cansat-tsniimash/KNPN-2025/doc/Расчет скорости спуска белый.docx

v=v_0 +(g-(C_x ∙S∙(ρ∙v^2)/2)/M)∙t

Find(v)→[, (2∙M∙((√((2∙C_x ∙S∙ρ∙g∙t^2 +2∙C_x ∙S∙ρ∙v_0 ∙t+M)/M))/2-1/2))/(C_x ∙S∙ρ∙t);, -(2∙M∙((√((2∙C_x ∙S∙ρ∙g∙t^2 +2∙C_x ∙S∙ρ∙v_0 ∙t+M)/M))/2+1/2))/(C_x ∙S∙ρ∙t)]

C_x =0.84

S=(π∙(84 mm)^2)/4=5 542 mm^2

ρ=1.225 (kg)/(m^3)

v_0 =7.1 m/s

M=779 gm

v=(2∙M∙((√((2∙C_x ∙S∙ρ∙g∙t^2 +2∙C_x ∙S∙ρ∙v_0 ∙t+M)/M))/2-1/2))/(C_x ∙S∙ρ∙t)

s(t)=∫_0^t v(t)dt

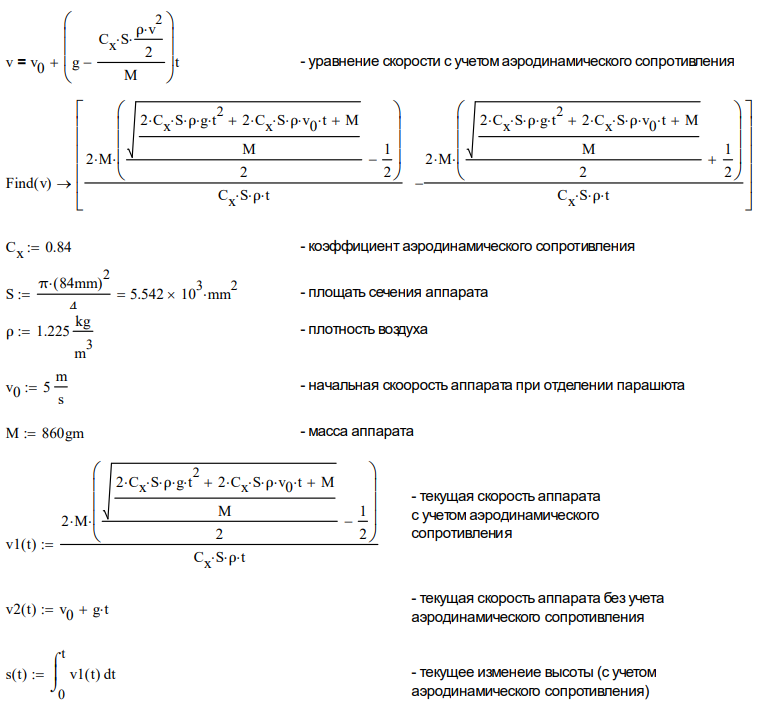
[picture p1: figure]
