cansat-tsniimash/KNPN-2025/doc/парашют1.docx

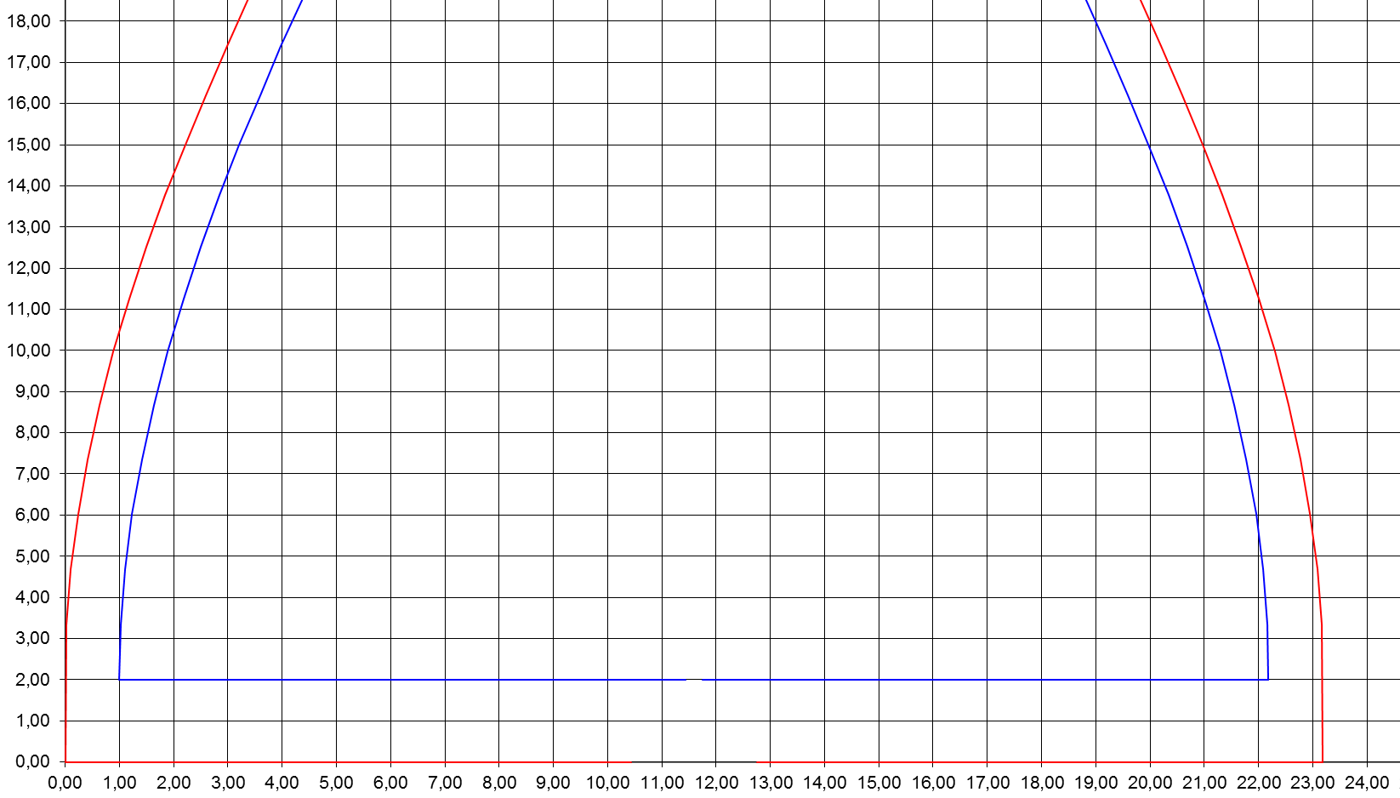
[picture p2: figure]
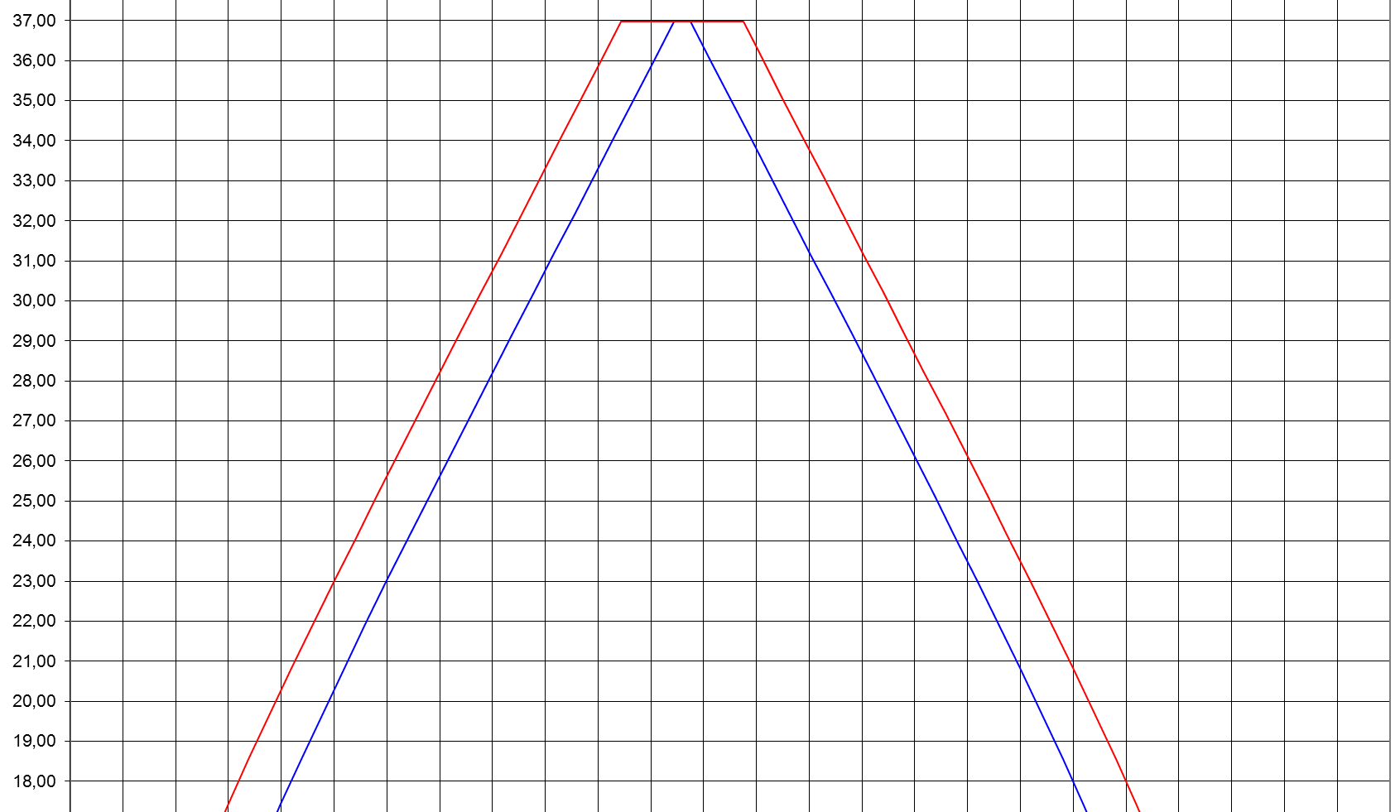
[picture p3: figure]
