cansat-tsniimash/KNPN-2025/doc/Спецификация.pdf

Копировал | Формат А4
КНПН.0000-0 СБ | Сборочный чертеж
| Сборочные единицы
1 | КНПН.1000-0 | Мотор/крепление | 8
2 | КНПН.1100-0 | Кнопка-концевик | 8
3 | КНПН.3000-0 | Гермообъем | 1
4 | КНПН.4000-0 | Плата радио | 1
5 | КНПН.5000-0 | Плата моторов | 1
6 | КНПН.5000-0 | Узел солнечных батарей | 1
7 | КНПН.6000-0 | Плата МК | 1
8 | КНПН.7000-0 | Парашют | 1

Детали

9 | КНПН.0000-1 | База | 1
10 | КНПН.0000-2 | Лепесток 1 | 1
11 | КНПН.0000-3 | Лепесток 2 | 1
12 | КНПН.0000-4 | Лепесток 3 | 1
13 | КНПН.0000-5 | Лепесток 4 | 2
14 | КНПН.0000-6 | Лепесток 5 | 1
15 | КНПН.0000-7 | Лепесток 6 | 1
16 | КНПН.0000-8 | Лепесток 7 | 1
17 | КНПН.0000-9 | Стержень М3 | 4

Инв. N подл. Подп. и дата Взам. инв. N Инв. N дубл. Подп. и дата Справ. N Перв. примен.

## КНПН.0000-0

Изм. | Лист | N докум. | Подп. | Дата
| | Разраб. | - | | Атмосферный зонд | Лит. | Лист | Листов
Пров. | | | | | | | 1 | 3
Н. контр. | Команда КНПН

## Утв. Формат

Зона
Поз.
Обозначение | Наименование | Приме-чание
| Документация

Кол.

Копировал | Формат А4

Прочие изделия

23 | DC-DC преобразователь | 1
| MP1584EN
24 | GPS антенна | 1
| Ublox-NEO-7M
25 | Дальномер | 1
| TF-luna
26 | Мотор-редуктор | 1
| GA12-NA20
27 | Радиомаяк | 1
| TBEACON-ONYX

## КНПН.0000-0

Лист

2 Изм. | Лист | N докум. | Подп. | Дата

Инв. N подл. Подп. и дата Взам. инв. N Инв. N дубл. Подп. и дата

Формат
Зона
Поз.
| Обозначение | Наименование | | Приме-чание
18 | КНПН.0000-11 | Крепление СП | 1
19 | КНПН.0000-12 | Крепление gps | 1
20 | КНПН.0000-13 | Парашютная катушка | 1
21 | КНПН.0000-14 | Кронштейн СБ вертикальный | 1
22 | КНПН.0000-15 | Натяжитель | 1

Кол.
