cansat-tsniimash/KNPN-2025/Winter Session/2025 КНПН ЗС доп.pdf

# Тест подъема аппарата

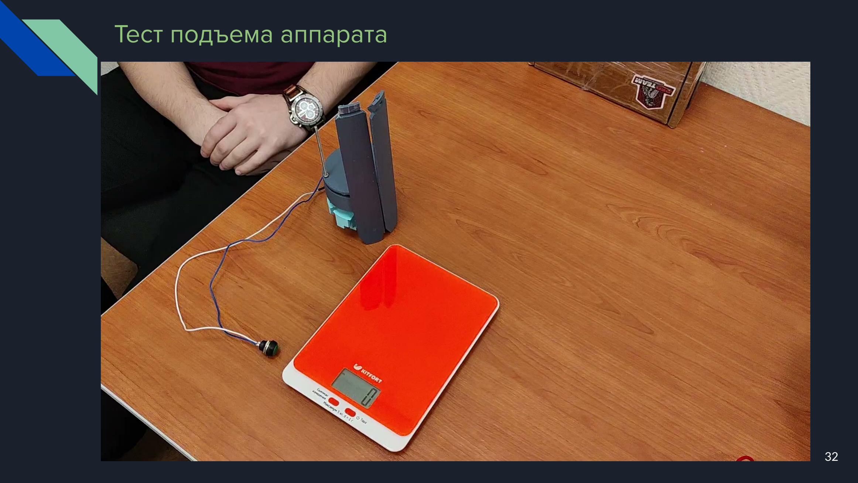
[picture p4: page 1]

# ВИДЕО (https://docs.google.com/file/d/16i_DLucU9-pxqTA7eW-CcuCZwpfHuC1A/preview)

# План-график работ

№ | Сроки | Содержание работ
1 | Октябрь | Определение дополнительных миссий аппарата, постановка задач
2 | Ноябрь - Декабрь | Выбор способов решения поставленных задач, определение состава аппарата, разработка модели аппарата, подбор комплектующих
2 | Декабрь | Прохождение онлайн-тестирования
3 | Январь | Разработка модели аппарата,начало написания кода, подготовка к отборочной сессии
4 | Февраль | Отборочная сессия, доработка ПО, доработка модели аппарата, разработка печатных плат
5 | Март | Изготовление элементов конструкции аппарата, доработка ПО, испытания всех систем
6 | Апрель | Разработка ПО для взаимодействия всех систем, сборка аппарата, пайка микросхем
7 | Май | Сборка тестовой модели аппарата, проведение испытаний, проверка работы всех систем, заочный допуск
8 | Июнь | Разбор телеметрии с испытаний, устранение недочетов, сборка финальной модели аппарата
9 | Июль | Финал чемпионата

# Энергопотребление компонентов аппарата

Устройство | Количество, шт. | Потребление в рабочем режиме, А | Напряжение питания, В | Мощность, Вт
Микроконтроллер STM32F411 Black Pill | 1 | 0,0234 | 3,3 | 0,07722
SD карта | 1 | 0,25 | 3,3 | 0,825
Радиомодуль E220-400T22S | 1 | 0,11 | 3,3 | 0,363
Акселерометр + гироскоп LSM6DS3 | 1 | 0,0009 | 3,3 | 0,00297
Магнитометр LIS3MDL | 1 | 0,0002 | 3,3 | 0,00066
Датчик тока INA219 | 1 | 0,00002 | 3,3 | 0,000066
Фоторезистор VT93N1 | 2 | 0,0006 | 3,3 | 0,00198
АЦП 8-канальный AD5593RBRUZ | 2 | 0,001 | 3,3 | 0,0033
GPS модуль NEO-7M | 1 | 0,1000 | 5 | 0,5
Пищалка | 1 | 0,025 | 5 | 0,125
Датчик давления, температуры, влажности BME280 | 1 | 0,012 | 5 | 0,06
Датчик примесей воздуха MICS-5524 | 1 | 0,032 | 5 | 0,16
Датчик качества воздуха CCS811 | 1 | 0,03 | 5 | 0,15
Датчик примесей воздуха MICS-6814 | 1 | 0,032 | 5 | 0,16
Компрессор JSB1523018 | 1 | 0,12 | 5 | 0,6
Электромагнитный клапан ZT2-3C | 1 | 0,204 | 5 | 1,02
Мотор двухосевой панели GA12-N20 | 1 | 0,06 | 5 | 0,3
Мотор угловой панели GA12-N20 | 1 | 0,04 | 5 | 0,2
Мотор угловой лепестки GA12-N20 активные | 2 | 0,26 | 16 | 4,16
Мотор угловой лепестки GA12-N20 пассивные | 6 | 0,02 | 16 | 0,32
Пережигатель | 2 | 2 | 4,1 | 8,2

# Энергопотребление компонентов аппарата

Токоотдача | Ток, А
Максимальная токоотдача | 8,000
Максимальная токоотдача (3,3V) | 4,500
Максимальная токоотдача (5V) | 3,000
Максимальная токоотдача (16V) | 1,000
Потребление | Ток, А
Максимальное потребление | 3,245
Максимальное потребление (3,3V) | 0,388
Максимальное потребление (5V) | 0,859
Максимальное потребление (16V) | 0,640

# Расчет скорости спуска без парашюта

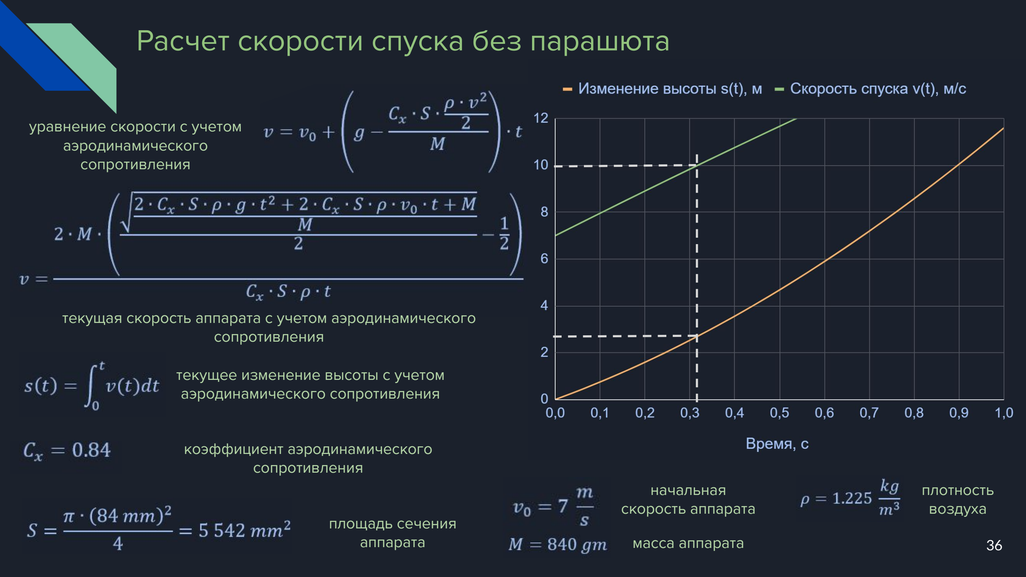
[picture p5: page 5]

плотность
воздуха

начальная
скорость аппарата

масса аппарата

коэффициент аэродинамического сопротивления

уравнение скорости с учетом аэродинамического
сопротивления

текущая скорость аппарата с учетом аэродинамического сопротивления

текущее изменение высоты с учетом аэродинамического сопротивления

площадь сечения
аппарата

# MICS

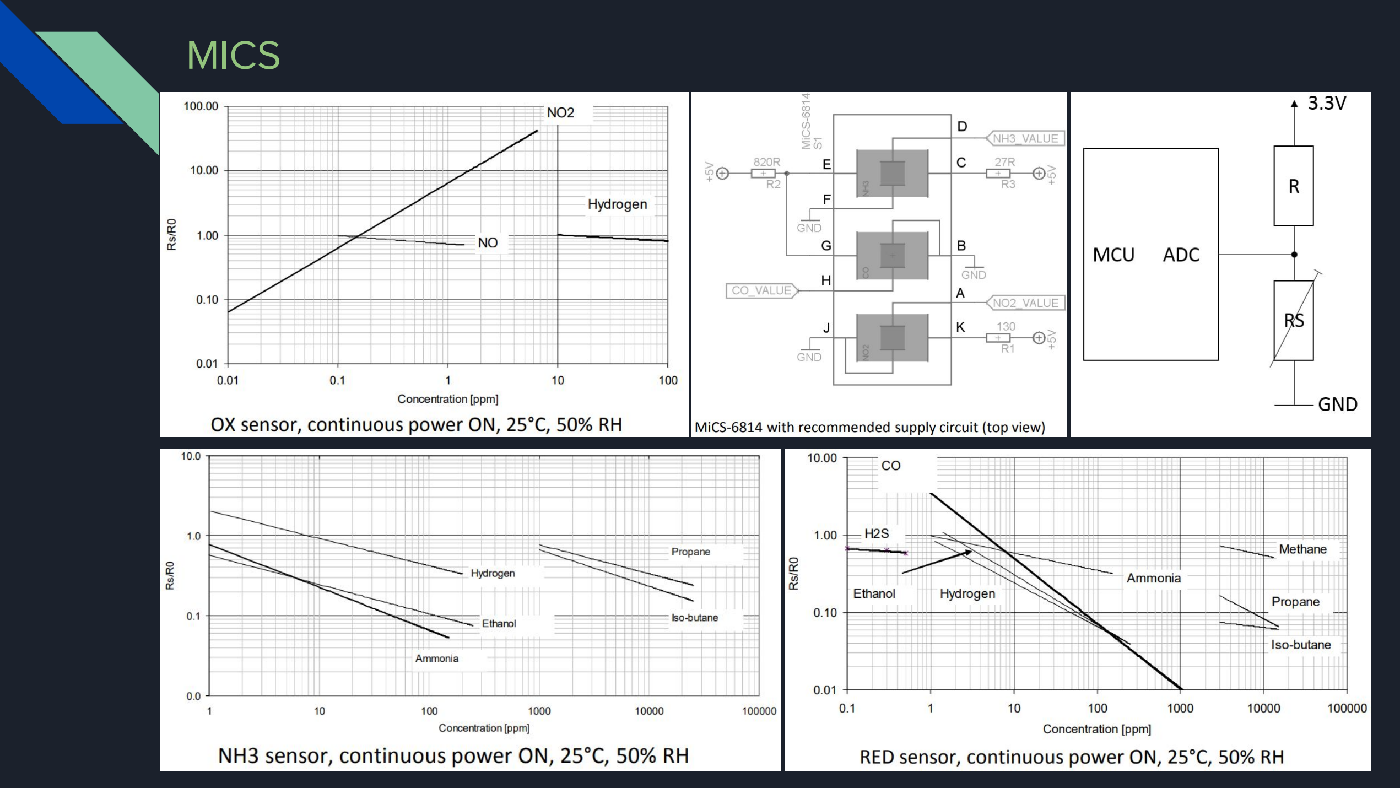
[picture p6: page 6]

Измерения Диапазон измерений

Точность
измерени
я

Частота
измерени
я

Объем
данных
, байт
BME280 | Температура | -40 - +85 град | 0,5 град | 157 Гц -26,32 Гц | 2
| Давление | 30 - 110 кПа | 100 Па (1 м) | | 4
| Влажность | 0% - 100% | 3% | | 2
| Высота | | 1м | | 4
LSM6DSL | Акселеромет р | 16 g | 40 mg | 104,2 Гц | 6
| Гироскоп | 2000 град/с | 3 град/с | | 6
LIS3MDL | Магнитометр | 16 гаусс | 1 гаусс | 80 Гц | 6

Ublox neo
7m
Широта | -

2,5 м

10 Гц

4

Долгота | - | 4
Высота | 0 - 50000 м | 4
Скорость, узл | 0 - 500 м/с | 0,1 м/с | -
Время, с | - | 30 нс | 4
Время, мкс | - | | 4
Fix | - | - | 1
Madgwick | q1, q2, q3, q4 | - | - | 40 Гц | 16
Измерения | Диапазон измерений

Точность
измерения

Частота
измерени
я

Объем
данных
, байт
Фото | Сопротивлени е | 12-300K | - | 28,6 Гц | 4
INA219 | Напряжение | 0 - 26 В | 1% (0,2%) | 14,7 Гц | 2
| Ток | - | 1% (0,2%) | | 4
CCS811 | углекислый CO2 | 400 – 8192 ppm | | 4 Гц | 2
| концентрация летучих веществ TVOC | 0 – 1187 ppb | | | 2
MICS-5524 | угарный CO | 1 – 1000 ppm | | 4 Гц | 2
| этанол C2H5OH | 10 – 500 ppm
водород H2 | 1 – 1000 ppm
аммиак NH3 | 1 – 500 ppm
метан CH4 | 1000 ppm
MICS-6814 | угарный CO | 1 – 1000 ppm | | 4 Гц | 2
| диоксид азота NO2 | 0,05 - 10 ppm | | | 2
| аммиак NH3 | 1 - 300 ppm | | | 2
| | | ±6см (0,2-3м)
TF-luna
8M | Расстояние | 0,2 - 8м
100 Гц | 2
±2% (3-8м)

# Параметры датчиков

# Расчет радиолинии (E220-400T22S)

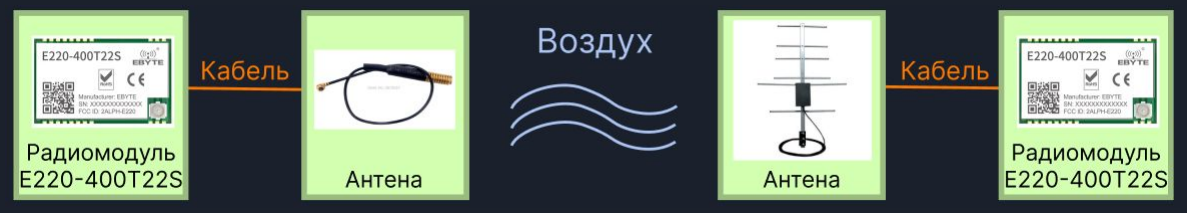
[picture p7: figure]

Радиомодуль | Кабель | Антенна | Воздух | Антенна | Кабель | Радиомодуль
22 | -2 | 0 | -102 | 8 | -2 | 117
дБм | дБ | дБи | дБ | дБи | дБ | дБм
P прд | L прд | G прд | ΣL | G прм | L прм | Pmin

### c – скорость света f – частота радио λ – длина волны d – максимальное расстояние между радиомодулями ΣL – суммарные потери в пространстве ΣP – суммарная мощность на входе в радиоприемник Pmin – чувствительность радиоприемника Δ – запас мощности на входе в радиоприемник

### с = 299 792 458 м/с f = 450.125 MГц

λ = 0.666 м
d = 7 000 м

### ΣL = -102.417 dBm ΣP = P

прд

- Lпрд + G
прд

### - ΣL + G

прм

- L
прм

### = -76 dBm Pmin = -117 dBm Δ = ΣP - Pmin= 41 dBm
