cansat-tsniimash/KNPN-2025/Winter Session/Алгоритм работы .png

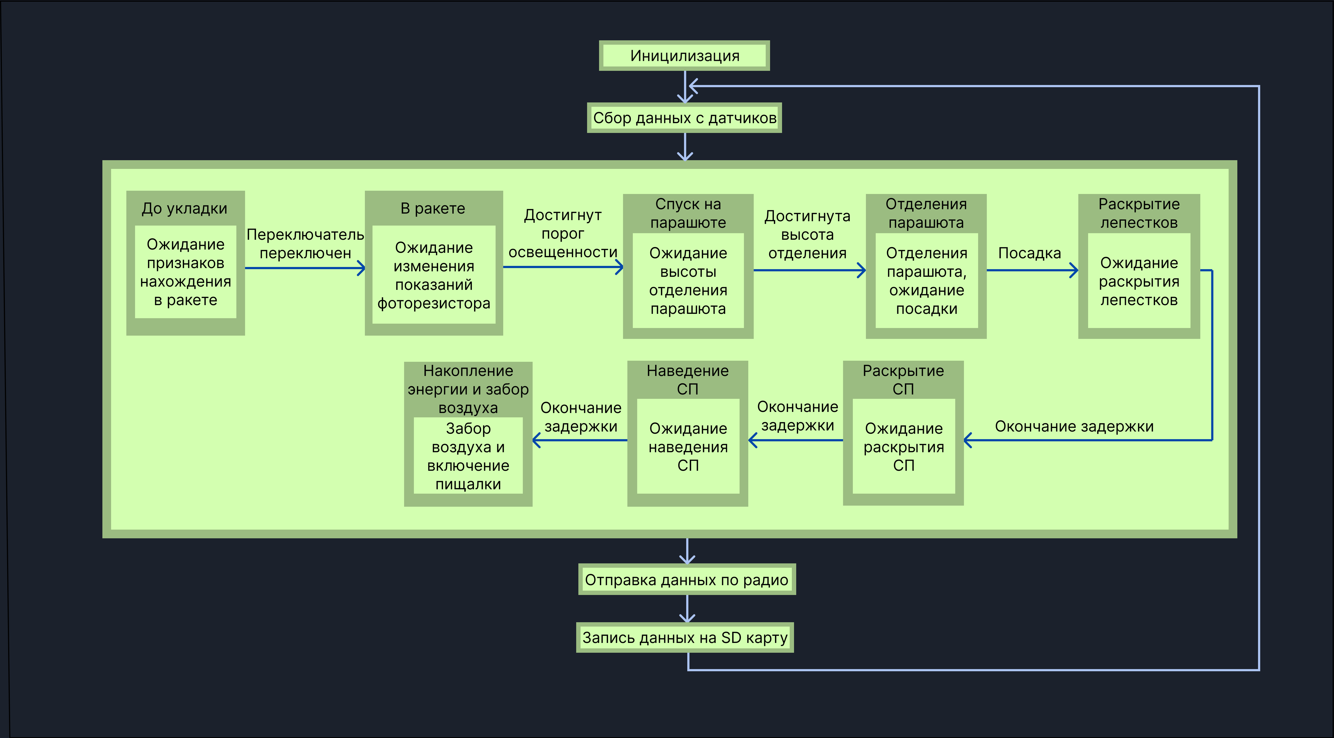
Winter Session/Алгоритм работы .png
