cansat-tsniimash/KNPN-2025/Winter Session/Подключение (16).png

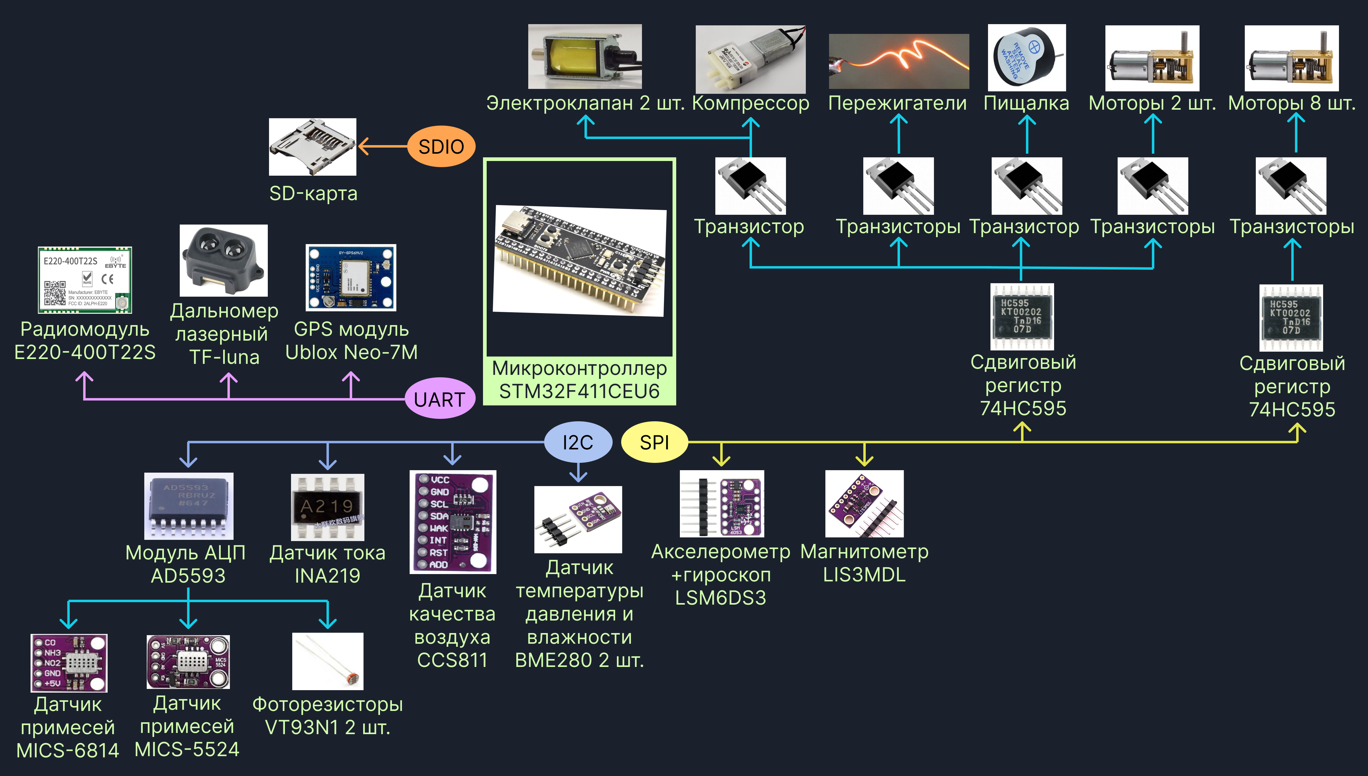
Winter Session/Подключение (16).png
