cansat-tsniimash/KNPN-2025/Winter Session/Подключение.png

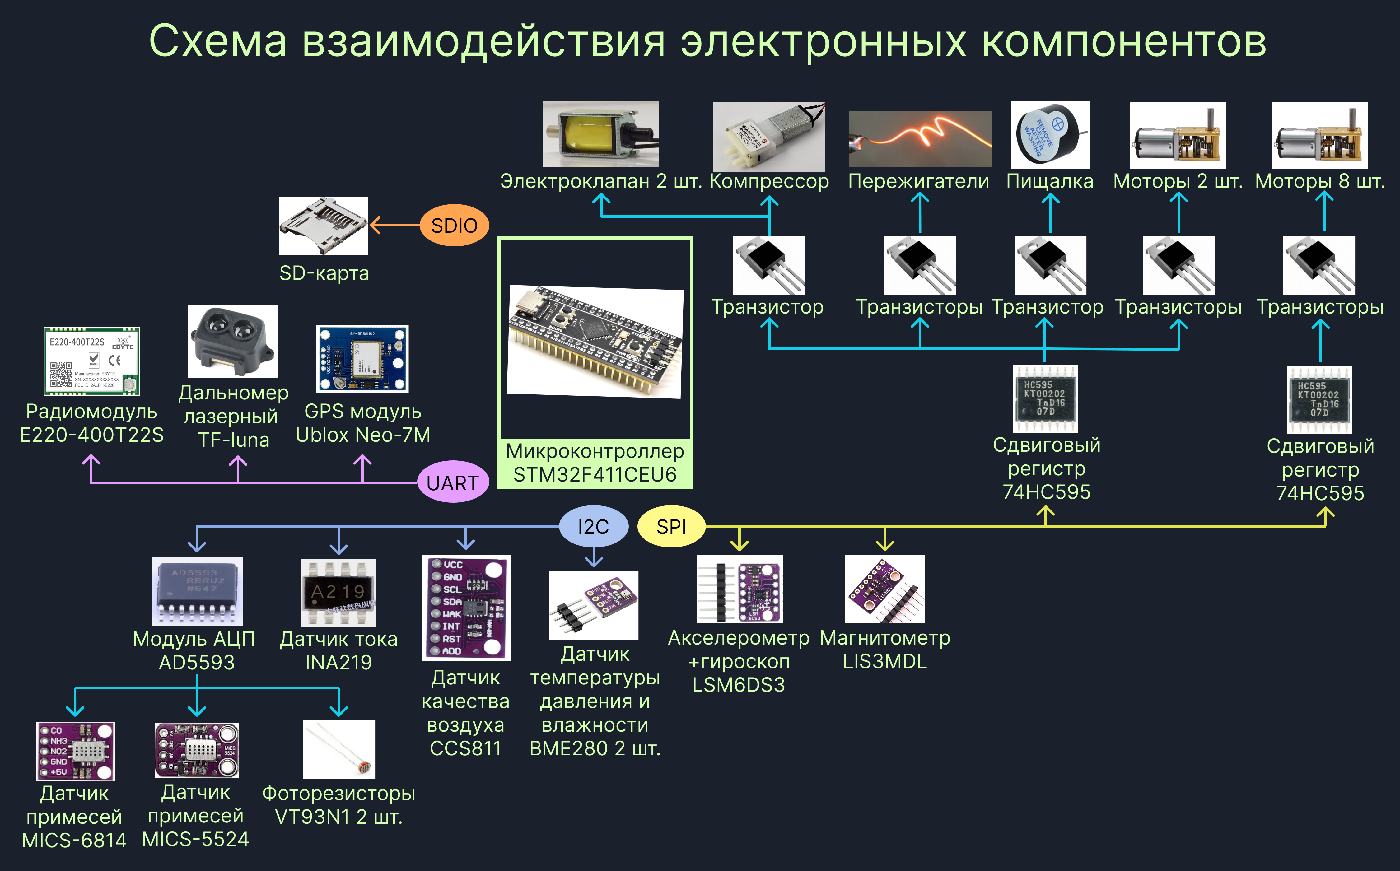
Winter Session/Подключение.png
