cansat-tsniimash/KNPN-2025/Winter Session/Расчёт параметров системы спасения.png

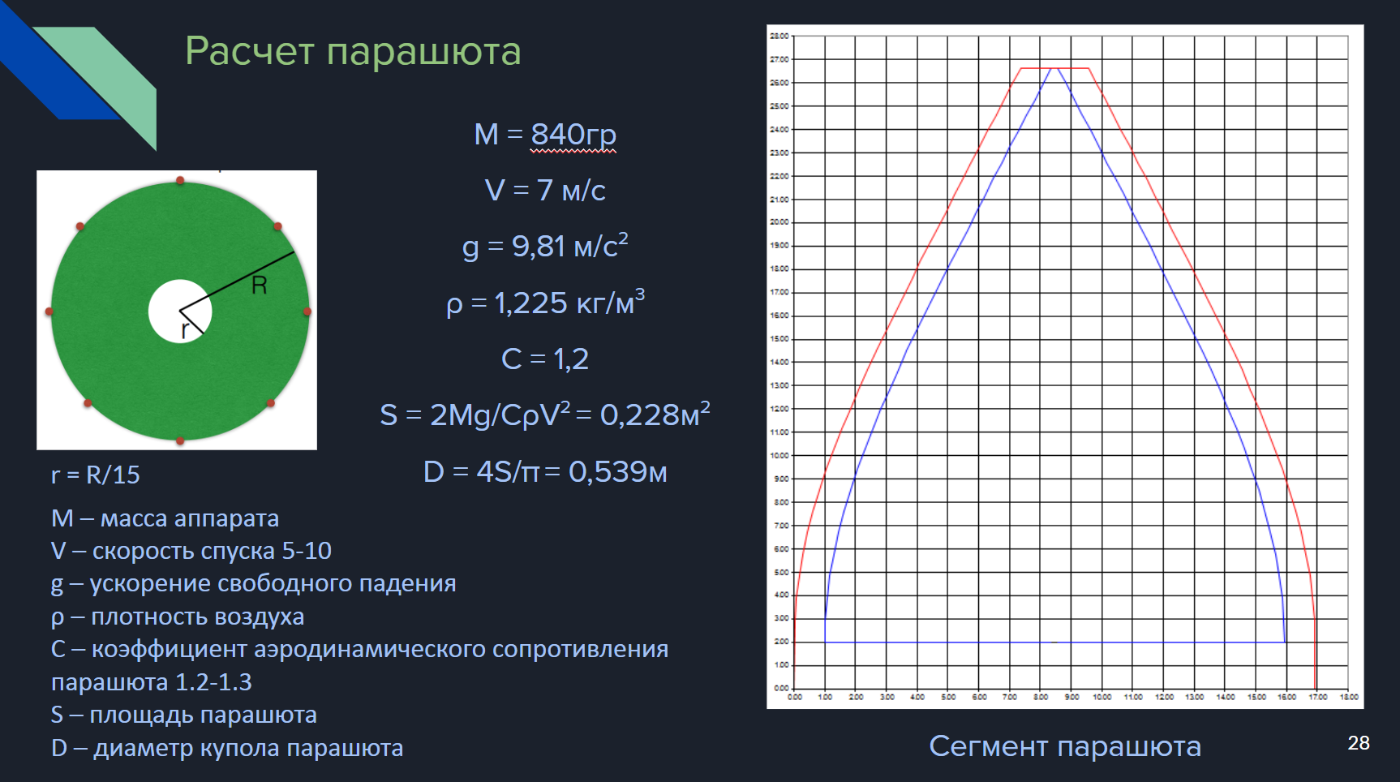
Winter Session/Расчёт параметров системы спасения.png
