cansat-tsniimash/KNPN-2025/Winter Session/Расчёт энергопотребления.png

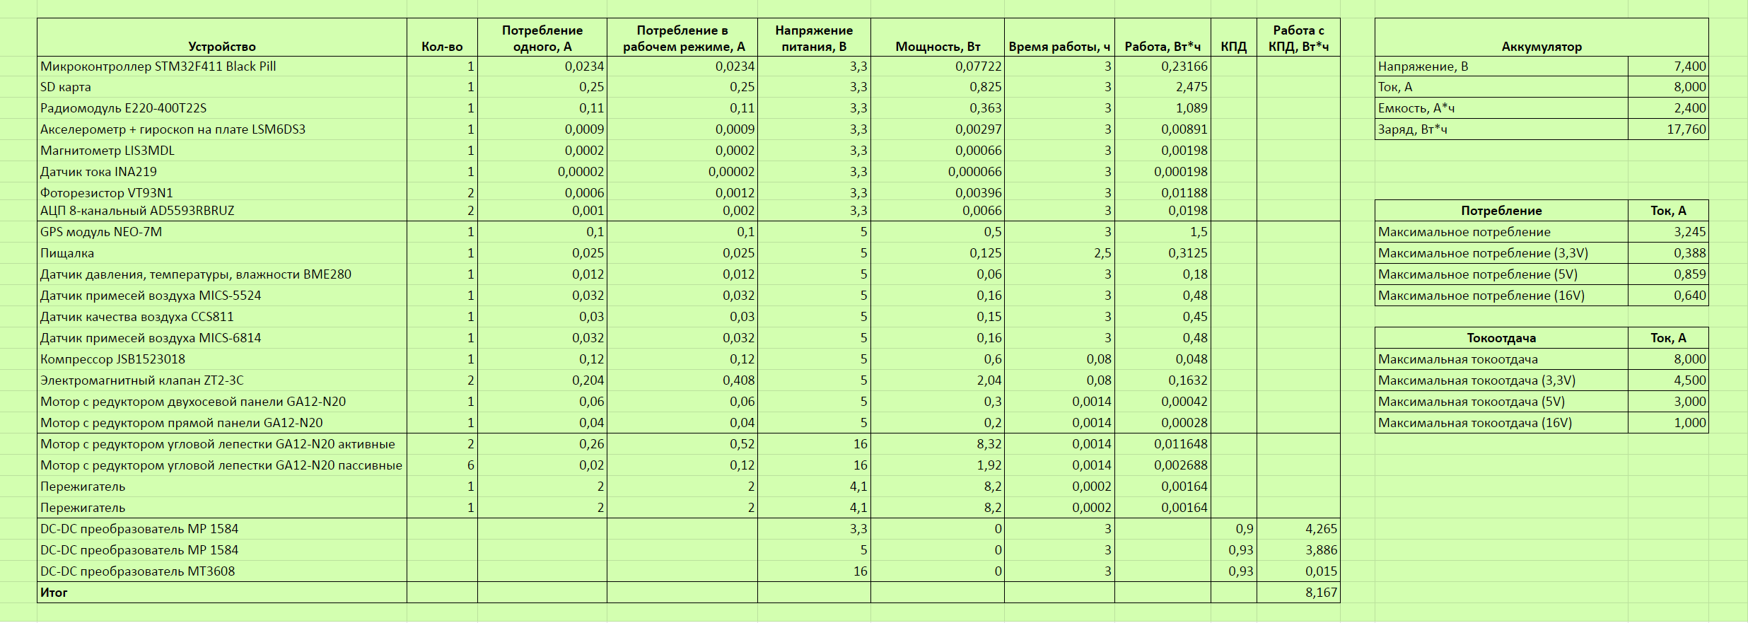
Winter Session/Расчёт энергопотребления.png
