cansat-tsniimash/KNPN-2025/Winter Session/Расчёт энергопотребления_1.png

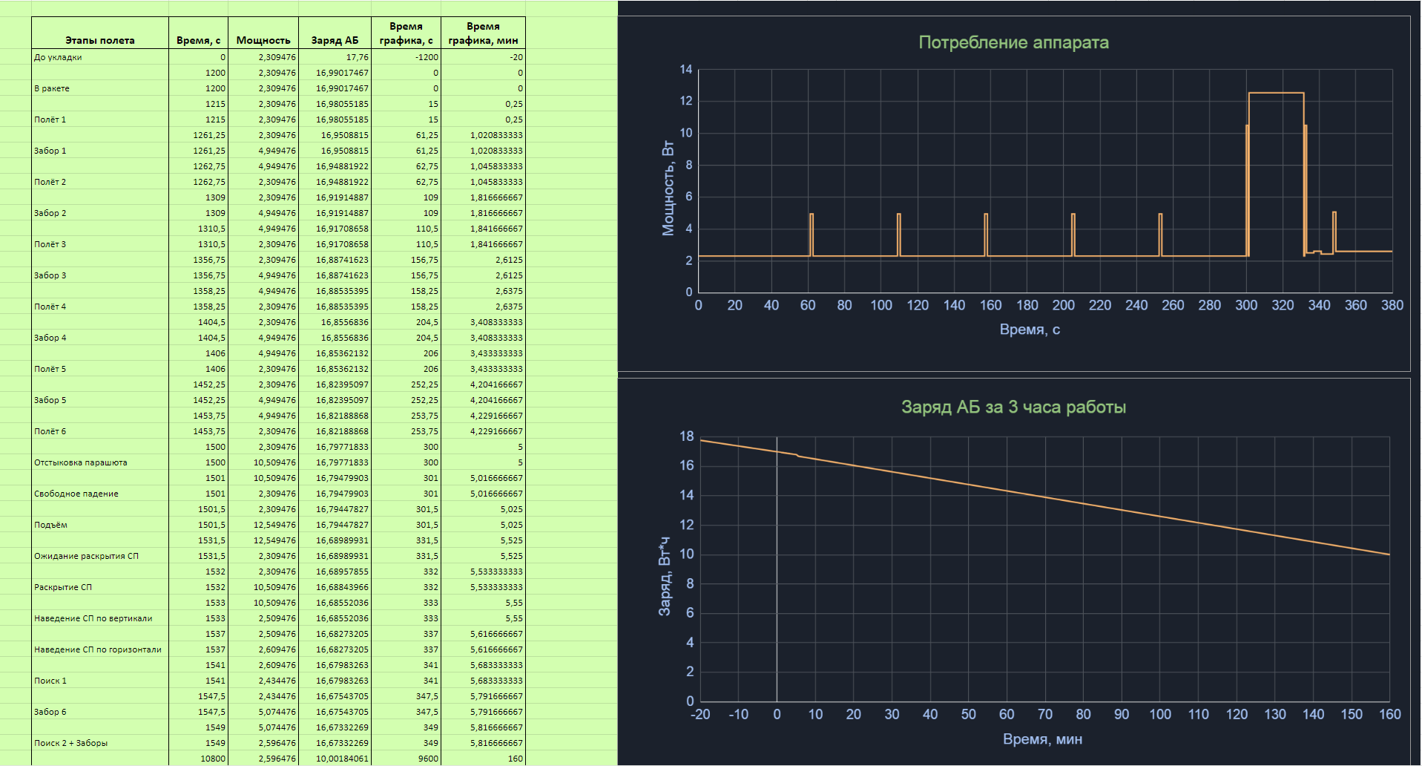
Winter Session/Расчёт энергопотребления_1.png
