cansat-tsniimash/KNPN-2025/Winter Session/Структурная схема бортовой электроники.png

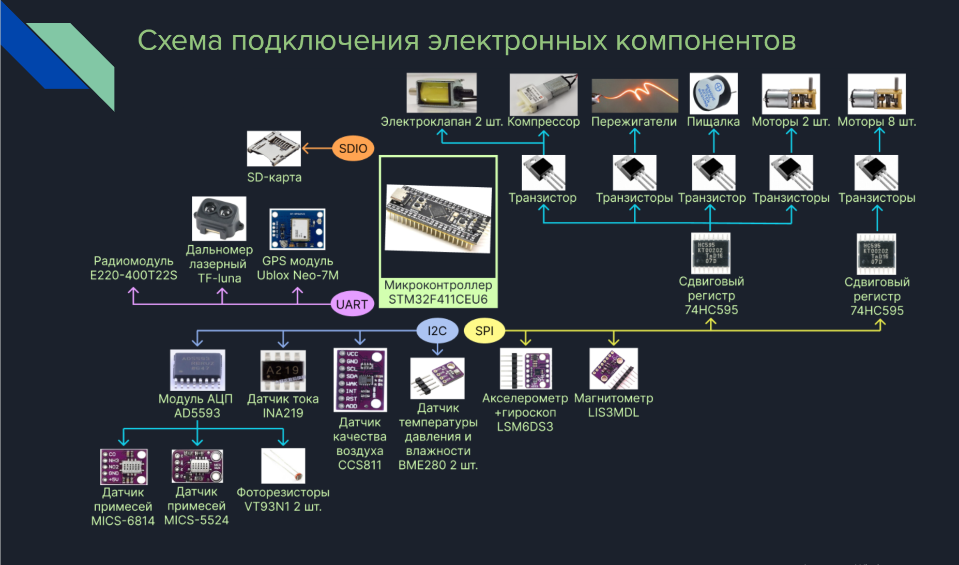
Winter Session/Структурная схема бортовой электроники.png
