cansat-tsniimash/KNPN-2025/Winter Session/электроника.png

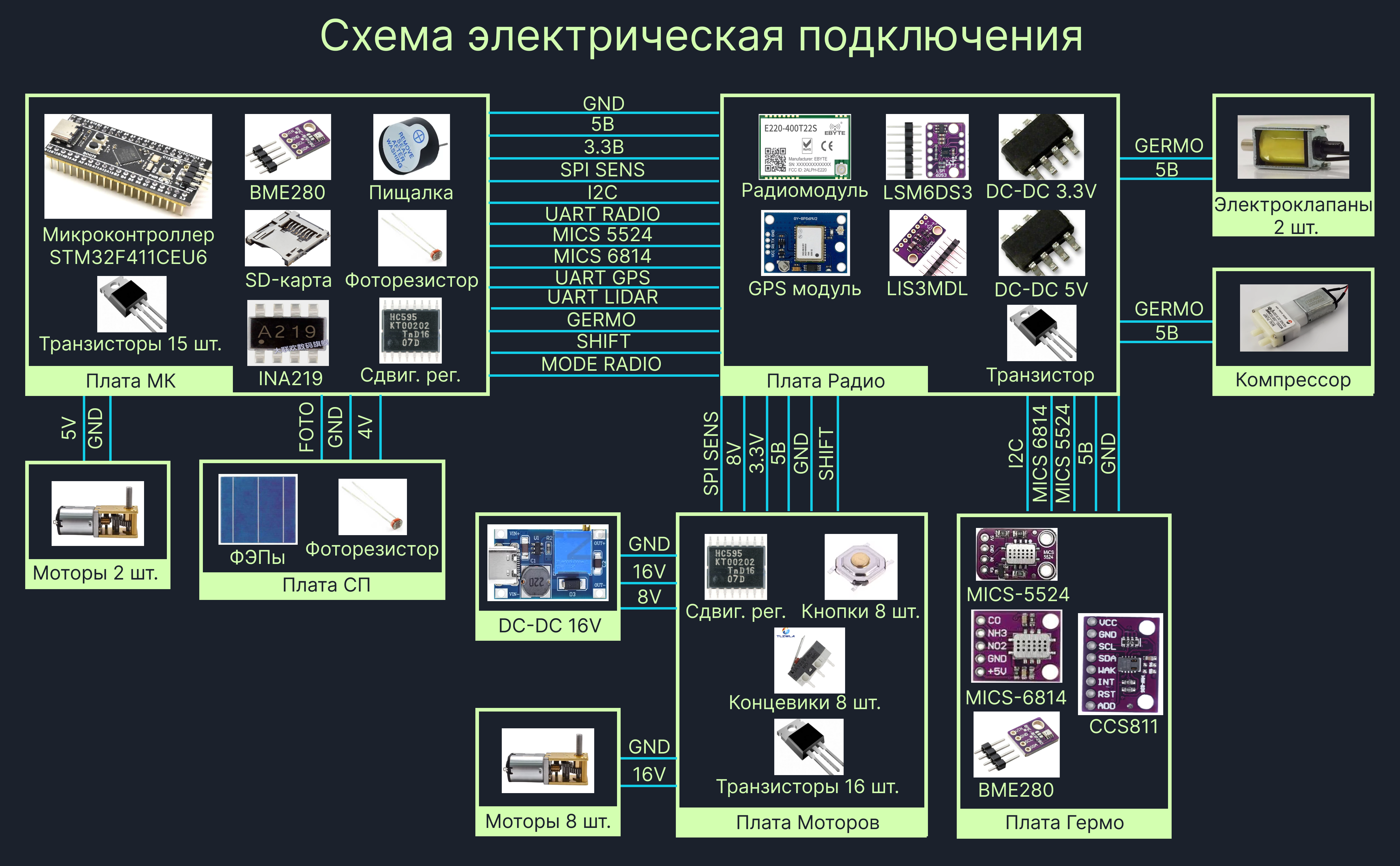
Winter Session/электроника.png
