cansat-tsniimash/KNPN-2025/construction/sat/mk-board.dxf

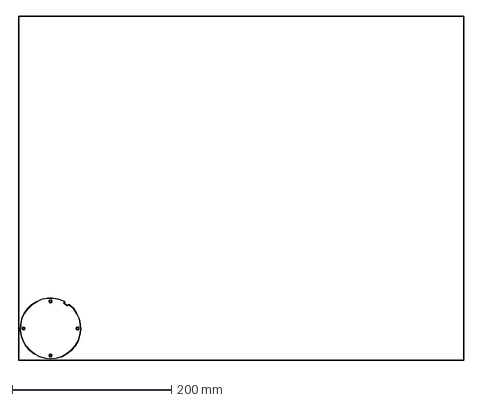
[picture p16: CAD file, 2025-03-26]
construction/sat/mk-board.dxf
561.8 x 434.7 mm
