cansat-tsniimash/KNPN-2025/construction/STL/base.stl

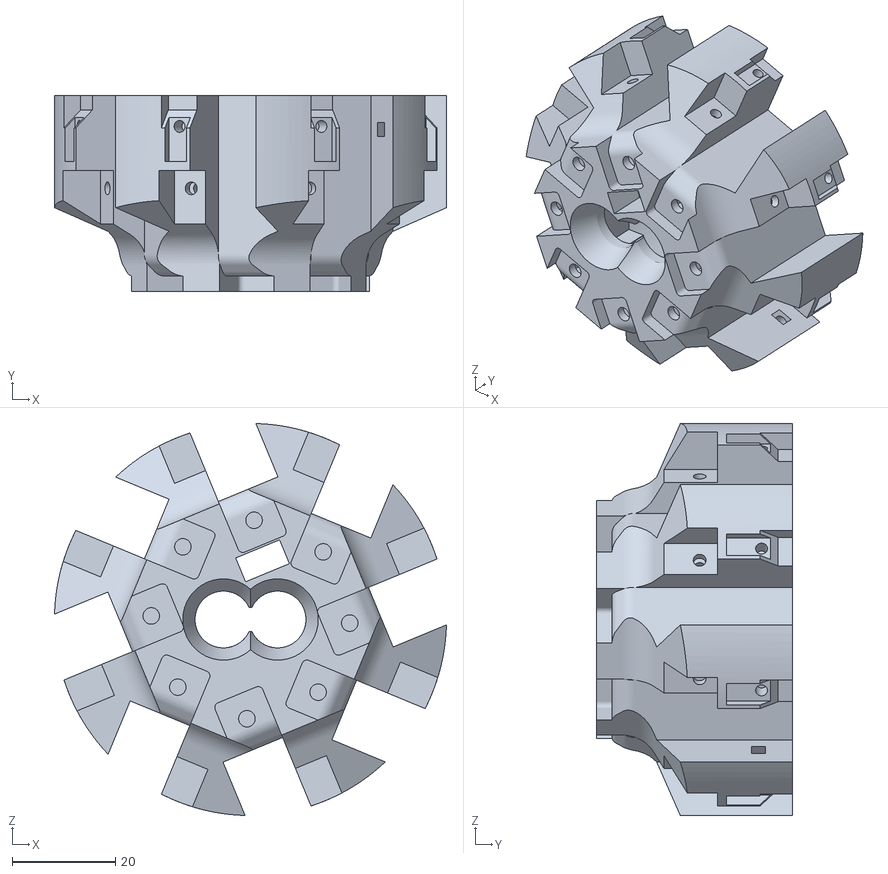
[picture p17: CAD file, 2025-06-01]
construction/STL/base.stl
76.0 x 38.0 x 76.0
