cansat-tsniimash/KNPN-2025/construction/STL/Лепестки запас/lepestok_vz1.stl

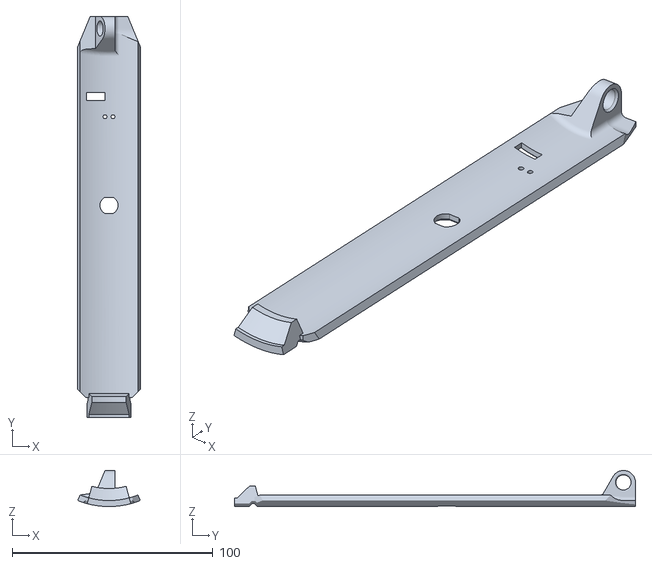
[picture p18: CAD file, 2025-06-25]
construction/STL/Лепестки запас/lepestok_vz1.stl
31.2 x 200.0 x 18.0
