cansat-tsniimash/KNPN-2025/construction/sat/motor_gxf.dxf

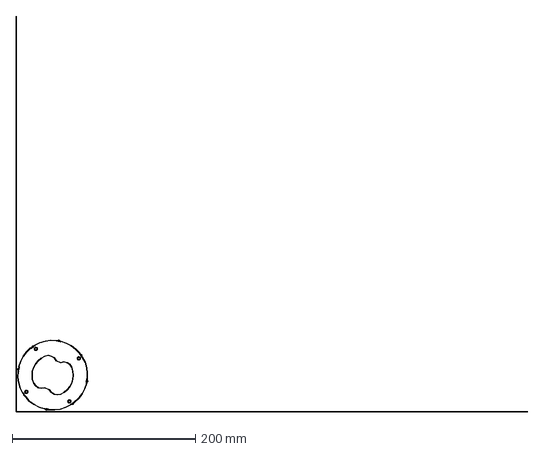
[picture p19: CAD file, 2025-03-07]
construction/sat/motor_gxf.dxf
558.8 x 431.8 mm
