cansat-tsniimash/KNPN-2025/construction/STL/hermetic_case.stl

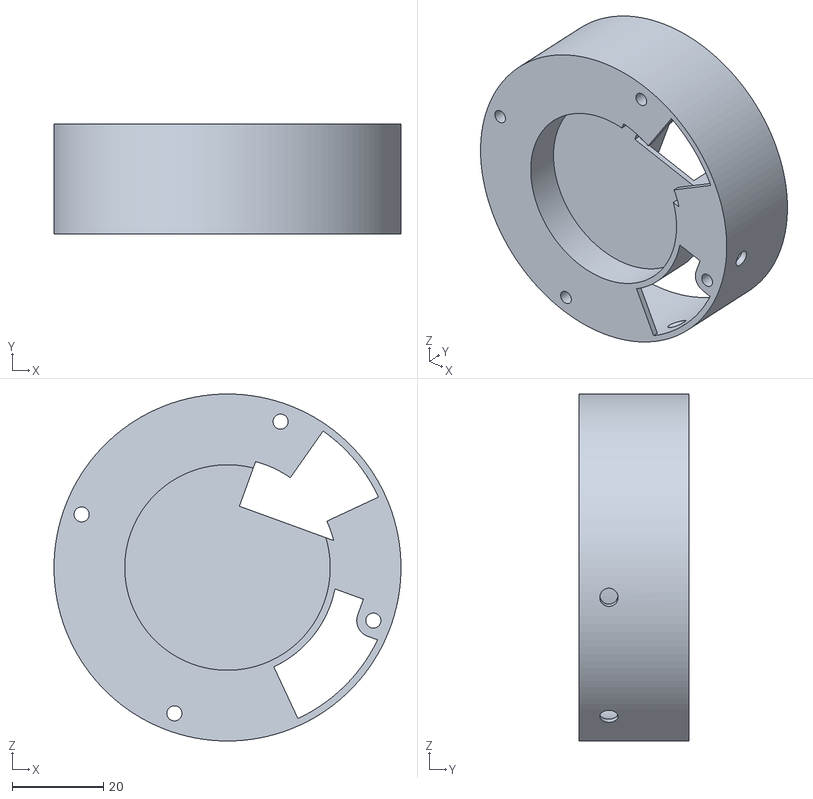
[picture p20: CAD file, 2025-06-01]
construction/STL/hermetic_case.stl
76.0 x 24.0 x 76.0
