cansat-tsniimash/KNPN-2025/construction/sat/hermetic_board.dxf

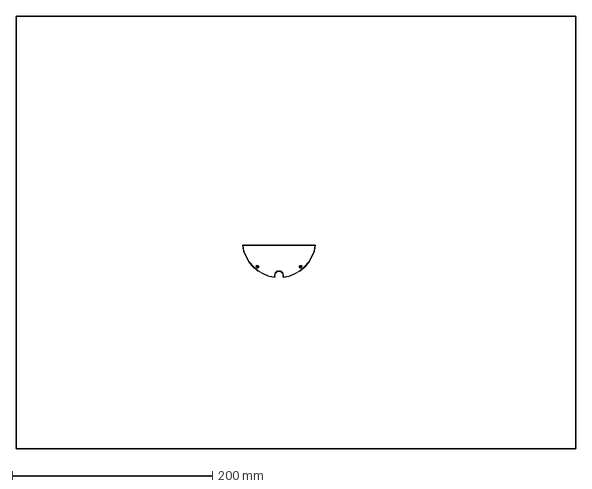
[picture p21: CAD file, 2025-02-07]
construction/sat/hermetic_board.dxf
558.8 x 431.8 mm
