cansat-tsniimash/KNPN-2025/construction/STL/tube_holder.stl

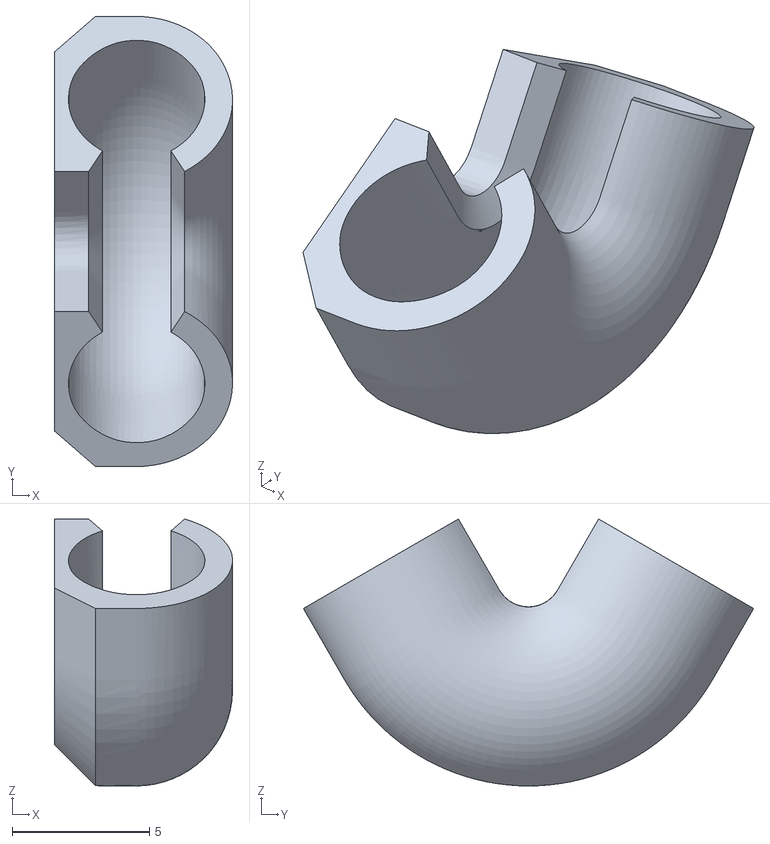
[picture p22: CAD file, 2025-06-01]
construction/STL/tube_holder.stl
6.50 x 16.4 x 9.74
