cansat-tsniimash/KNPN-2025/construction/sat/drw0001.dxf

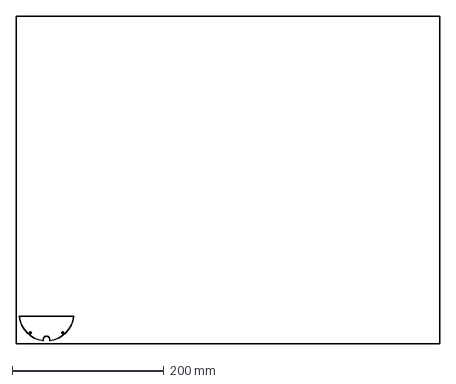
[picture p23: CAD file, 2025-02-07]
construction/sat/drw0001.dxf
558.8 x 431.8 mm
