cansat-tsniimash/KNPN-2025/construction/STL/gps_base.stl

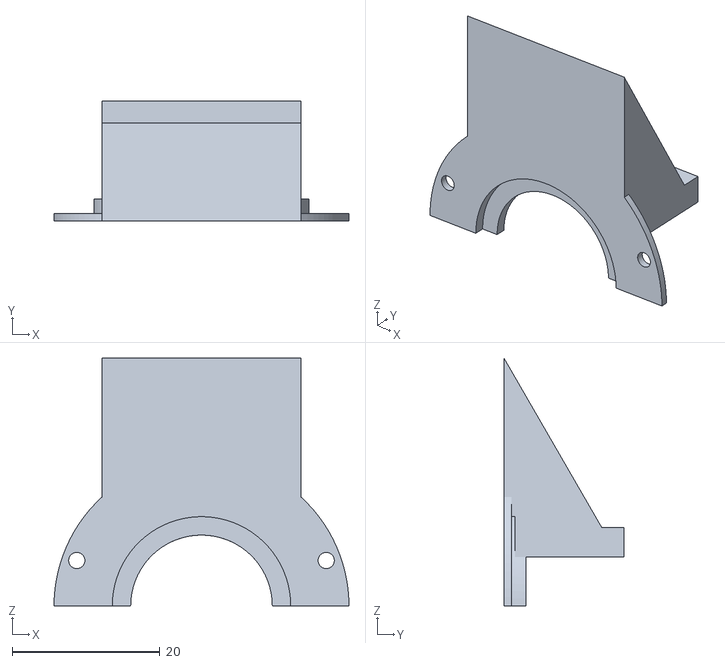
[picture p24: CAD file, 2025-05-28]
construction/STL/gps_base.stl
40.0 x 16.3 x 33.6
