cansat-tsniimash/KNPN-2025/construction/sat/hermetic_case.stl

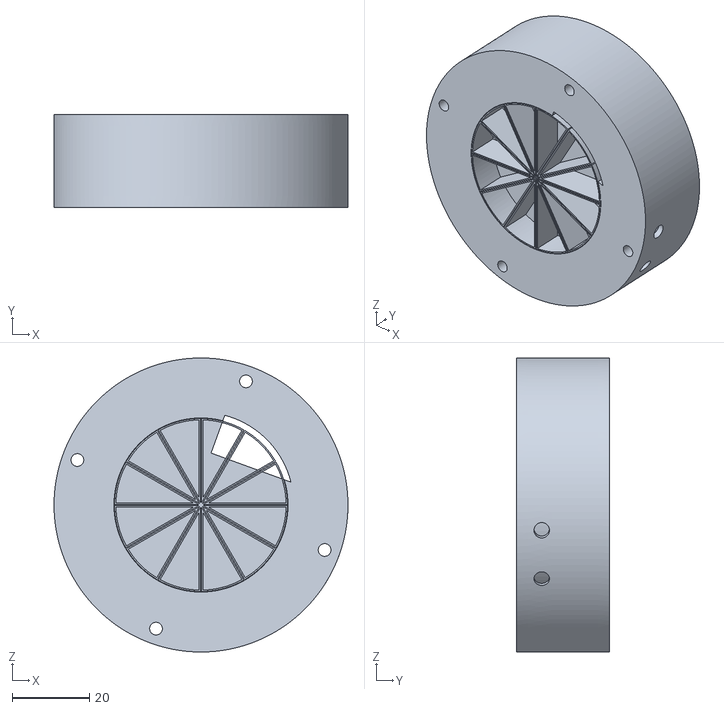
[picture p25: CAD file, 2024-12-14]
construction/sat/hermetic_case.stl
76.0 x 24.0 x 76.0
