cansat-tsniimash/KNPN-2025/construction/STL/parachute_compartment.stl

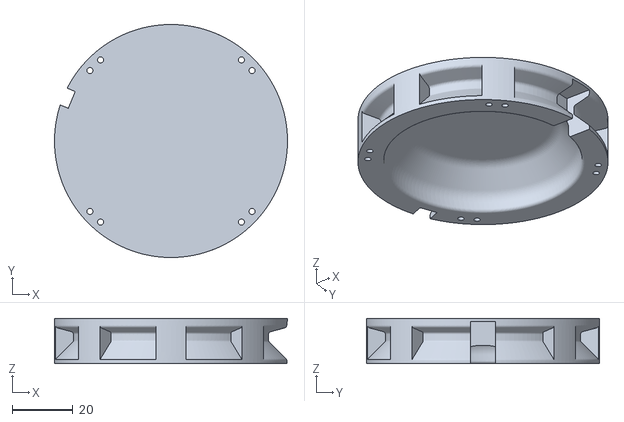
[picture p26: CAD file, 2025-04-11]
construction/STL/parachute_compartment.stl
77.0 x 77.0 x 15.0
