cansat-tsniimash/KNPN-2025/construction/STL/6.stl

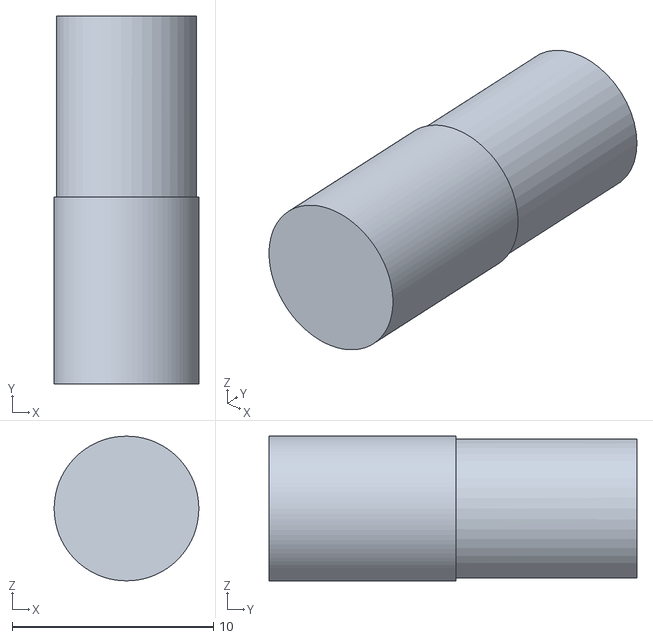
[picture p27: CAD file, 2025-04-11]
construction/STL/6.stl
7.20 x 18.3 x 7.19
