cansat-tsniimash/KNPN-2025/construction/STL/cylin_test4.stl

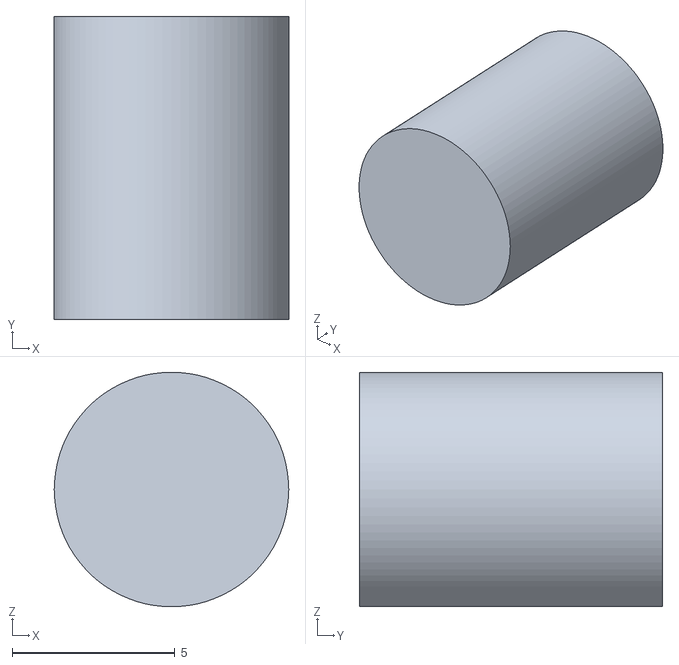
[picture p29: CAD file, 2025-04-11]
construction/STL/cylin_test4.stl
7.20 x 9.30 x 7.19
