cansat-tsniimash/KNPN-2025/construction/STL/cylin_test05.stl

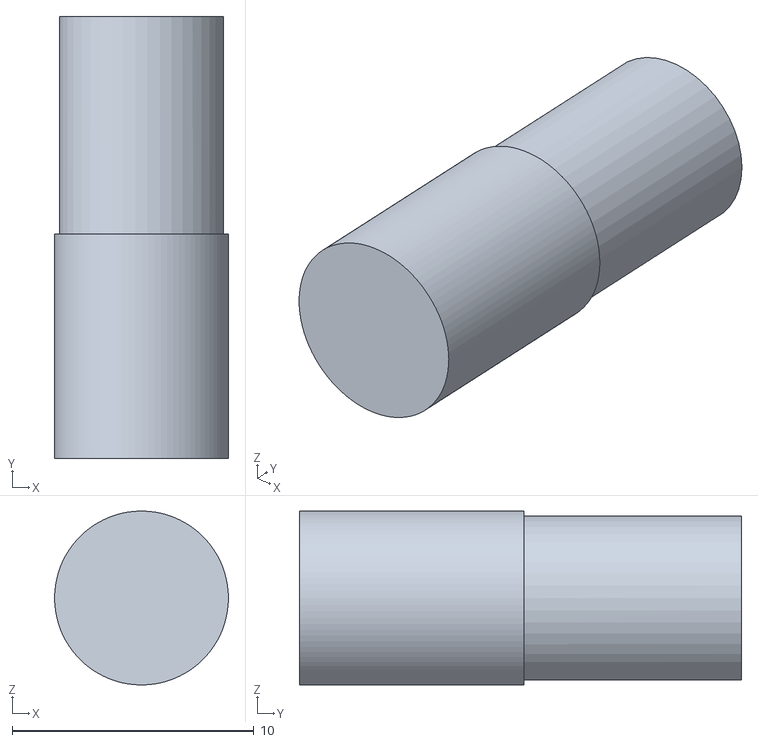
[picture p30: CAD file, 2025-04-11]
construction/STL/cylin_test05.stl
7.20 x 18.3 x 7.19
