cansat-tsniimash/KNPN-2025/construction/STL/cylin_test2.stl

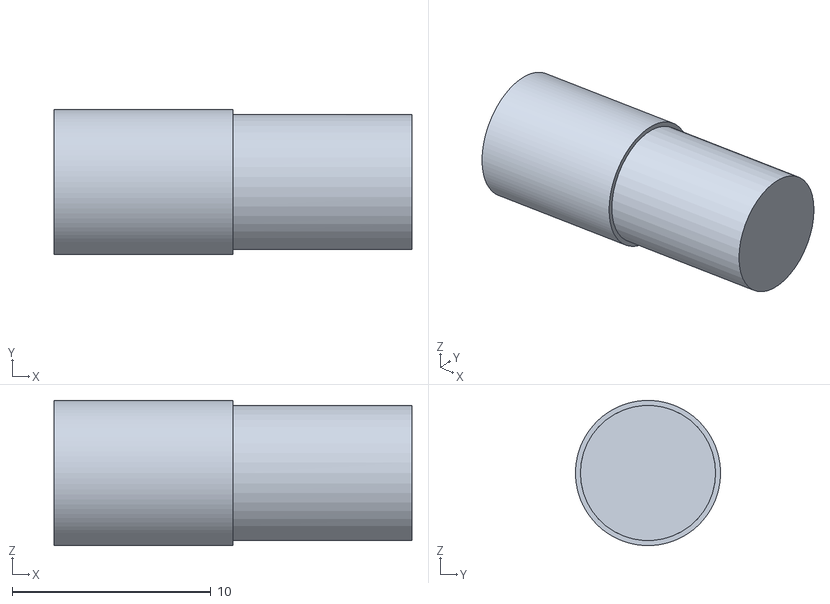
[picture p31: CAD file, 2025-04-11]
construction/STL/cylin_test2.stl
18.0 x 7.30 x 7.29
