cansat-tsniimash/KNPN-2025/construction/STL/cylin_test3.stl

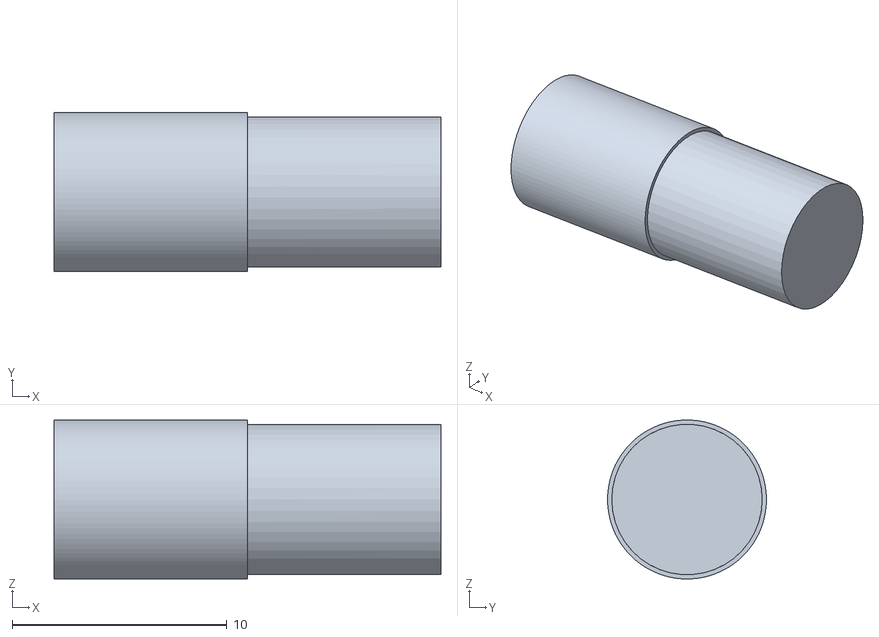
[picture p32: CAD file, 2025-04-11]
construction/STL/cylin_test3.stl
18.0 x 7.40 x 7.39
