cansat-tsniimash/KNPN-2025/construction/STL/lepestok_vz3.stl

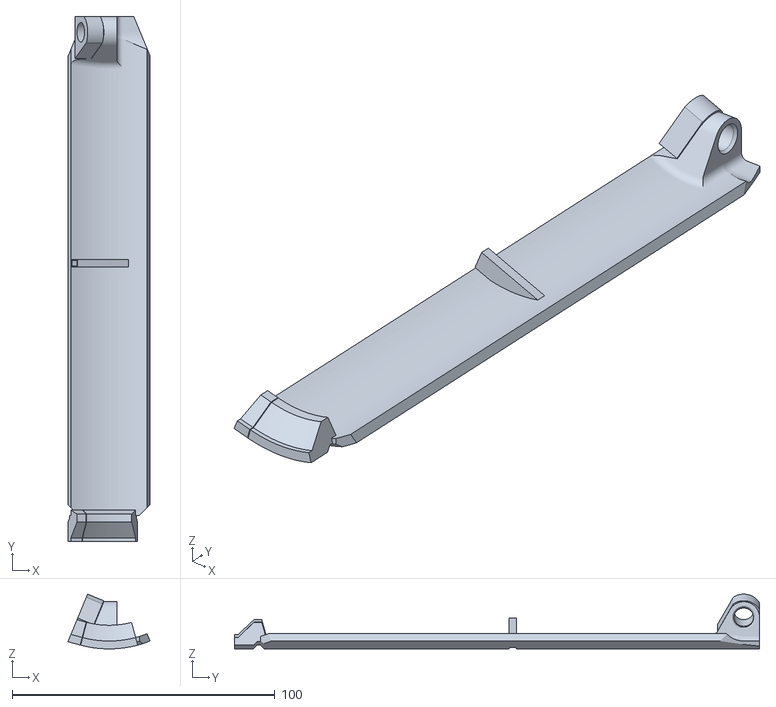
[picture p33: CAD file, 2025-02-07]
construction/STL/lepestok_vz3.stl
31.3 x 200.0 x 20.9
