cansat-tsniimash/KNPN-2025/construction/STL/lepestok_cyl_test.stl

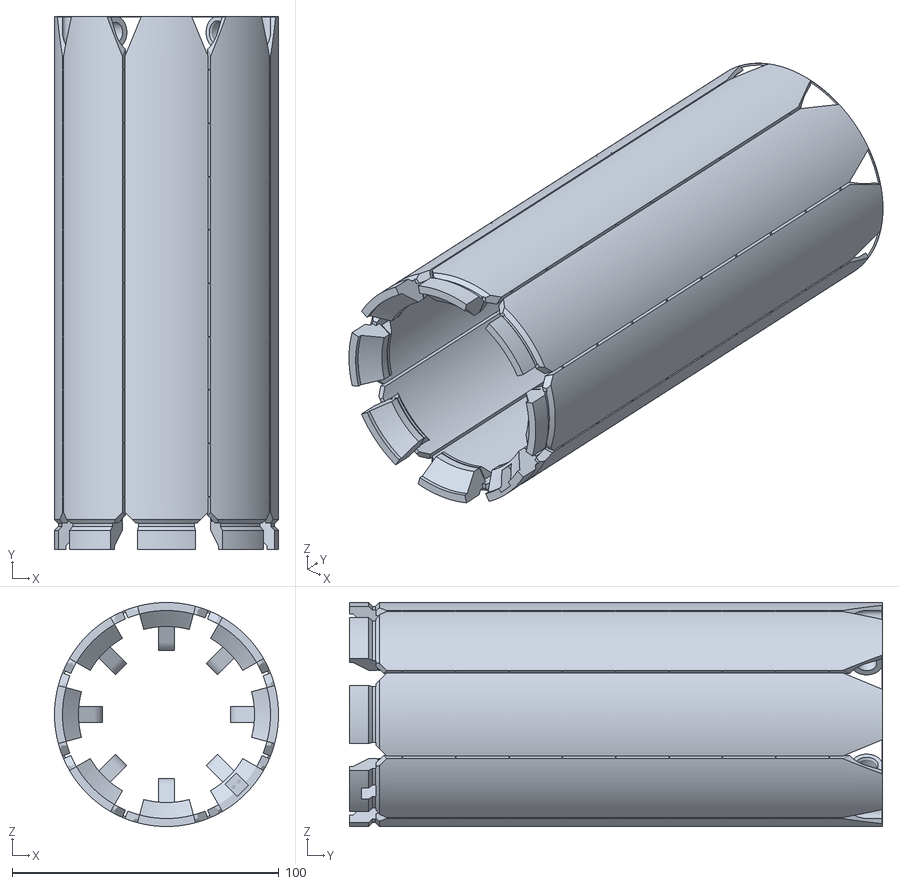
[picture p34: CAD file, 2024-11-23]
construction/STL/lepestok_cyl_test.stl
84.0 x 200.0 x 84.0
