cansat-tsniimash/KNPN-2025/construction/STL/corobka_grusika.stl

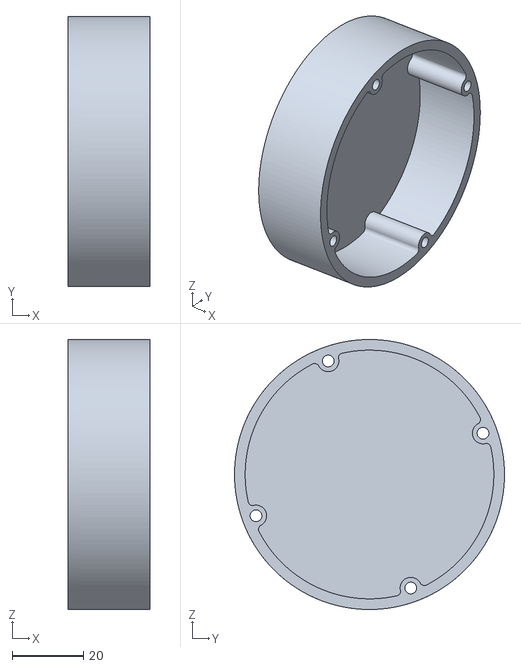
[picture p35: CAD file, 2024-11-23]
construction/STL/corobka_grusika.stl
23.0 x 76.0 x 76.0
