cansat-tsniimash/KNPN-2025/construction/STL/lepestok_2_test.stl

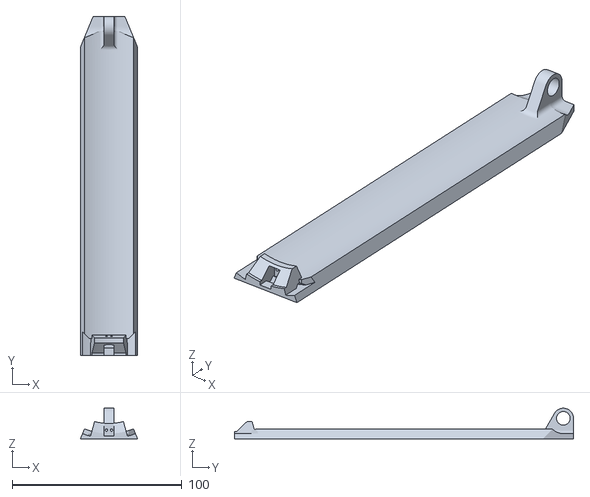
[picture p36: CAD file, 2024-11-23]
construction/STL/lepestok_2_test.stl
33.8 x 200.0 x 18.1
