cansat-tsniimash/KNPN-2025/construction/STL/crishka_grusika.stl

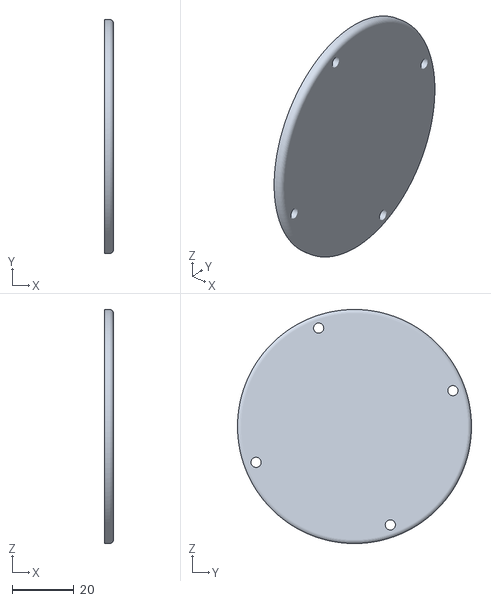
[picture p37: CAD file, 2024-11-23]
construction/STL/crishka_grusika.stl
3.00 x 76.0 x 76.0
