cansat-tsniimash/KNPN-2025/(list of files, cad)

Other CAD files:
construction/STL/Лепестки запас/lepestok_vz2.stl
construction/STL/Лепестки запас/lepestok_990.stl
construction/STL/Лепестки запас/lepestok-aboba.stl
construction/STL/lepestok_vz2.stl
construction/STL/Лепестки запас/lepestok_vmot.stl
construction/STL/lepestok_990.stl
construction/STL/Лепестки запас/lepestok_1.stl
construction/STL/lepestok_vz1.stl
construction/STL/lepestok-aboba.stl
construction/STL/lepestok_1.stl
construction/STL/lepestok_vz4.stl
construction/STL/lepestok_vmot.stl
construction/STL/lepestok_1_test2.stl
construction/STL/lepestok_1_test.stl
construction/STL/lepestok_1_test3.stl
construction/Models in creo/gps_ublox_neo-6m.prt
construction/Models in creo/gy-lsm6ds3_lsm6ds3.prt
construction/Models in creo/magnetometer_lis3mdl.prt
construction/Models in creo/motor-reductor.prt
construction/Models in creo/oxigen-sensor_me2-o2-f20.prt
construction/Models in creo/wireless_module_e22-400t30s.prt
construction/Old version/74hc595t16.prt
construction/Old version/ad5593.prt
construction/Old version/akkum_18350.prt
construction/Old version/amplifier_xq-02a.prt
construction/Old version/blinchik-down_1.prt
construction/Old version/blinchik-down_2.prt
construction/Old version/blinchik_for_kreplenie.prt
construction/Old version/blinchik_kernel_up.prt
construction/Old version/board.prt
construction/Old version/button.prt
construction/Old version/cilindr.prt
construction/Old version/connector_pls-smd.prt
construction/Old version/dc-dc_12v.prt
construction/Old version/detal_vrashenie_w_spring.prt
construction/Old version/disk.prt
construction/Old version/down_corpus.prt
construction/Old version/driver_tmc2209.prt
construction/Old version/ecap220-cmd.prt
construction/Old version/es_board.prt
construction/Old version/ftoroplast-botom.prt
construction/Old version/ftoroplast-top.prt
construction/Old version/gear_motor_2axis.prt
construction/Old version/ina219_korpus.prt
construction/Old version/irf7905.prt
construction/Old version/kernel_2mm_down.prt
construction/Old version/kernel_2mm_rezba.prt
construction/Old version/kernel_2mm_up.prt
construction/Old version/kreplenie_motor_i_akkum_niz.prt
construction/Old version/krishka_akkum.prt
construction/Old version/motor-1axis.prt
construction/Old version/motor-2axis.prt
construction/Old version/motor-reductor.prt
construction/Old version/nrf24l01.prt
construction/Old version/parachut_gps.prt
construction/Old version/parachut_perezhigatel.prt
construction/Old version/plata_dop.prt
construction/Old version/podshipnik.prt
construction/Old version/radiator.prt
construction/Old version/razem_3pin.prt
construction/Old version/razem_bolshoi_dlya_dop_platu.prt
construction/Old version/si2302.prt
construction/Old version/si2302_ao3407a.prt
construction/Old version/sp_base.prt
construction/Old version/sp_kernel_1mm_39mm.prt
construction/Old version/sp_krepezh_plata1.prt
construction/Old version/sp_krepezh_plata2.prt
construction/Old version/sp_krepezh_plata_motor.prt
construction/Old version/sp_plata.prt
construction/Old version/sp_shtanga.prt
construction/Old version/sp_zaglushka.prt
construction/Old version/spring_0_5x3_5x180deg_6turns.prt
construction/Old version/switch_ss-12d10.prt
construction/Old version/tube.prt
construction/Old version/vt93n1.prt
construction/STL/prt0001.prt
construction/sat/3mm_gear.prt
construction/sat/abstractnaa_os.prt
construction/sat/air_valve.prt
construction/sat/akb_tbeacon.prt
construction/sat/akk_cyl_aaaaaaaa.prt
construction/sat/akkum_18350.prt
construction/sat/andrey_pomni_tut_fignia2.prt
construction/sat/andrey_pomni_tut_fignya.prt
construction/sat/base.prt
construction/sat/base2.prt
construction/sat/base_for_test.prt
construction/sat/bme280_board.prt
construction/sat/bme280_module.prt
construction/sat/board.prt
construction/sat/boarder.prt
construction/sat/boarder_mk.prt
construction/sat/bottom_disk_corpus.prt
construction/sat/box_for_sp.prt
construction/sat/button.prt
construction/sat/buzzer.prt
construction/sat/ccs811.prt
construction/sat/compressor.prt
construction/sat/connector-h5-pbs-12.prt
construction/sat/connector-h5-pbs-16.prt
construction/sat/connector-pbs-12.prt
construction/sat/connector-pbs-16.prt
construction/sat/connector-pbs-4.prt
construction/sat/connector-pls-12.prt
construction/sat/connector-pls-16.prt
construction/sat/connector-pls-2.prt
construction/sat/connector-pls-20.prt
construction/sat/connector-pls-4.prt
construction/sat/connector_b2b-eh-a.prt
construction/sat/connector_pbs-10_5mm_smd.prt
construction/sat/connector_pbs-12_5mm_smd.prt
construction/sat/connector_pbs-15_smd.prt
construction/sat/connector_pbs-16_5mm_smd.prt
construction/sat/connector_pbs-4_5mm_smd.prt
construction/sat/connector_pbs-4_smd.prt
construction/sat/connector_pbs-smd.prt
construction/sat/connector_pbs_5mm-smd.prt
construction/sat/connector_pls-10_smd.prt
construction/sat/connector_pls-12_smd.prt
construction/sat/connector_pls-16_smd.prt
construction/sat/connector_pls-smd.prt
construction/sat/connector_pls_5mm-smd.prt
construction/sat/corpus_motor.prt
construction/sat/dalnomer2.prt
construction/sat/dc-dc_12v.prt
construction/sat/dc-dc_1584.prt
construction/sat/derjalka_motora_m2.prt
construction/sat/dop_connector.prt
construction/sat/es_board.prt
construction/sat/ffc_pinhead_dip.prt
construction/sat/fitting.prt
construction/sat/gayla_by_andrey.prt
construction/sat/gear_motor_2axis.prt
construction/sat/gps_antenna.prt
construction/sat/gps_antenna25x25.prt
construction/sat/gps_base.prt
construction/sat/gps_ublox_neo-7m.prt
construction/sat/hermetic_board.prt
construction/sat/hermetic_case.prt
construction/sat/kernel_3mm.prt
construction/sat/krivoship.prt
construction/sat/lepestok-aboba.prt
construction/sat/lepestok.prt
construction/sat/lepestok_1.prt
construction/sat/lepestok_1_test.prt
construction/sat/lepestok_2.prt
construction/sat/lepestok_2_test.prt
construction/sat/lepestok_990.prt
construction/sat/lepestok_vmot.prt
construction/sat/lepestok_vz1.prt
construction/sat/lepestok_vz2.prt
construction/sat/lepestok_vz3.prt
construction/sat/lepestok_vz4.prt
construction/sat/lidar.prt
construction/sat/limit_switch.prt
construction/sat/lis3mdl_board.prt
construction/sat/lsm6ds3_board.prt
construction/sat/microsd_connector.prt
construction/sat/mics-5524.prt
construction/sat/mics-6814.prt
construction/sat/motor-2axis.prt
construction/sat/motor-reductor-m4.prt
construction/sat/motor__2.prt
construction/sat/motor_angular.prt
construction/sat/motor_board.prt
construction/sat/motor_fastener.prt
construction/sat/mt3608.prt
construction/sat/parachute.prt
construction/sat/parachute_compartment.prt
construction/sat/perehodnik_motoblin.prt
construction/sat/pinhead_jst_2pin.prt
construction/sat/pinhead_jst_4pin.prt
construction/sat/pinhead_jst_5pin.prt
construction/sat/plate_sp.prt
construction/sat/prt0001.prt
construction/sat/prt0002.prt
construction/sat/prt0003.prt
construction/sat/prt000754.prt
construction/sat/shahshahs.prt
construction/sat/shatun.prt
construction/sat/solariy_aaaaaaaa.prt
construction/sat/sp_base.prt
construction/sat/sp_board.prt
construction/sat/sp_board_fastener1.prt
construction/sat/sp_board_fastener2.prt
construction/sat/sp_board_motor_fastener.prt
construction/sat/sp_cap.prt
construction/sat/sp_kernel_1mm_39mm.prt
construction/sat/sp_rod.prt
construction/sat/sp_shaft_fastener.prt
construction/sat/spring_0_5x3_5x180deg_6turns.prt
construction/sat/stm32f411_board.prt
construction/sat/svaston_na_pehcat.prt
construction/sat/switch_mss-12d01.prt
construction/sat/switch_ss-12d11.prt
construction/sat/tbeacon_onyx.prt
construction/sat/tensioner.prt
construction/sat/tube_holder.prt
construction/sat/vt93n1.prt
construction/sat/wireless_module_e220-400t22s.prt
