cansat-tsniimash/KNPN-2025/construction/video/cansatpresent.jpg

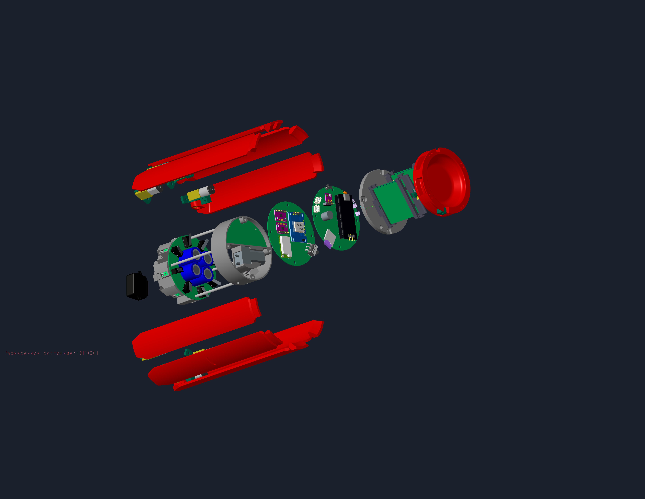
construction/video/cansatpresent.jpg
