cansat-tsniimash/KNPN-2025/construction/video/parachute_animation.gif

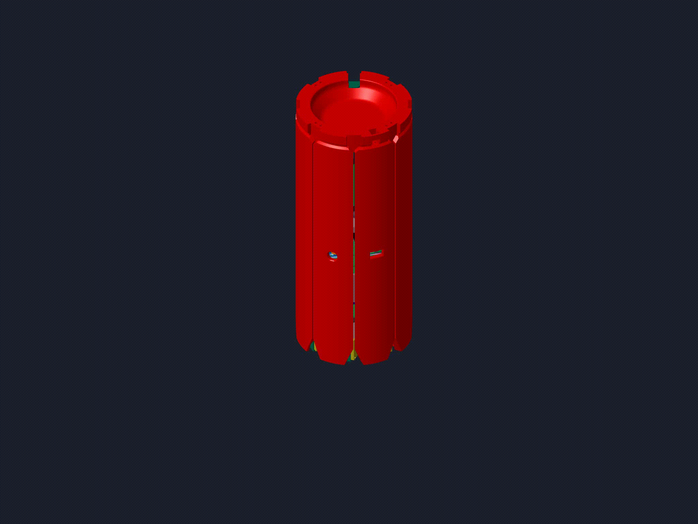
construction/video/parachute_animation.gif
