cansat-tsniimash/KNPN-2025/construction/video/без кромки/parachute_animation.gif

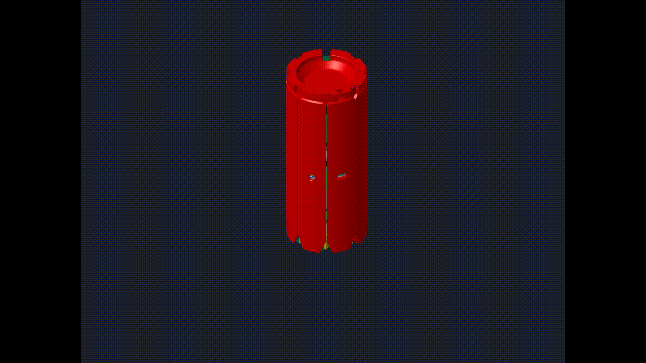
construction/video/без кромки/parachute_animation.gif
