cansat-tsniimash/KNPN-2025/schematics/Принципиальная схема бортовой электроники чб.pdf

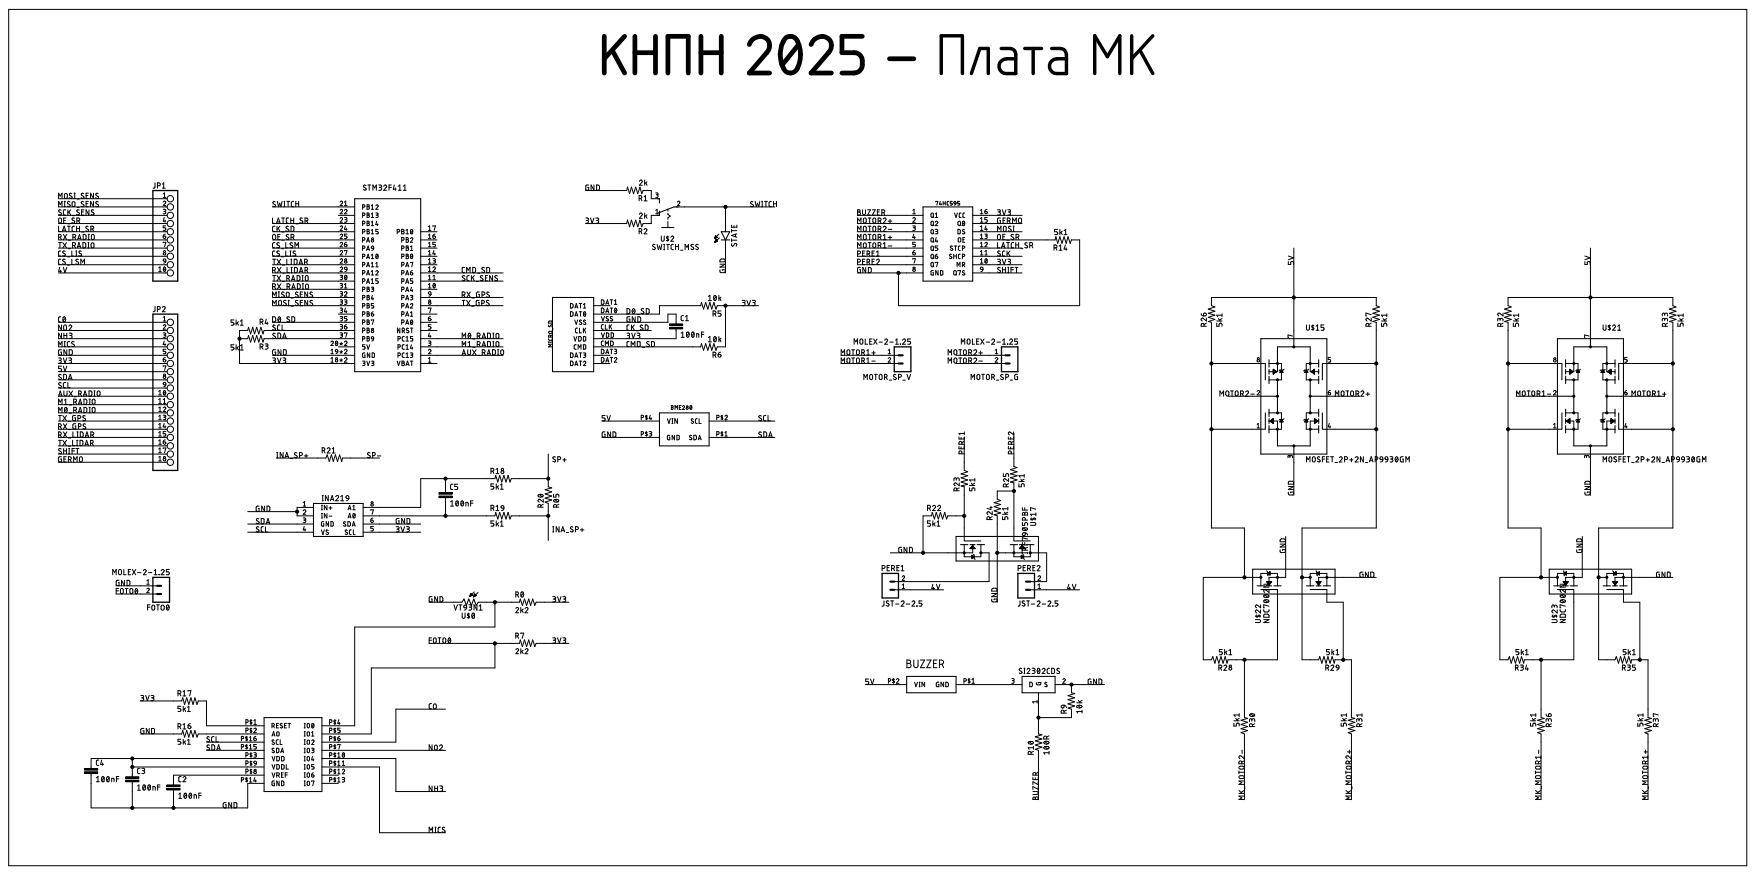
[picture p47: page 1]

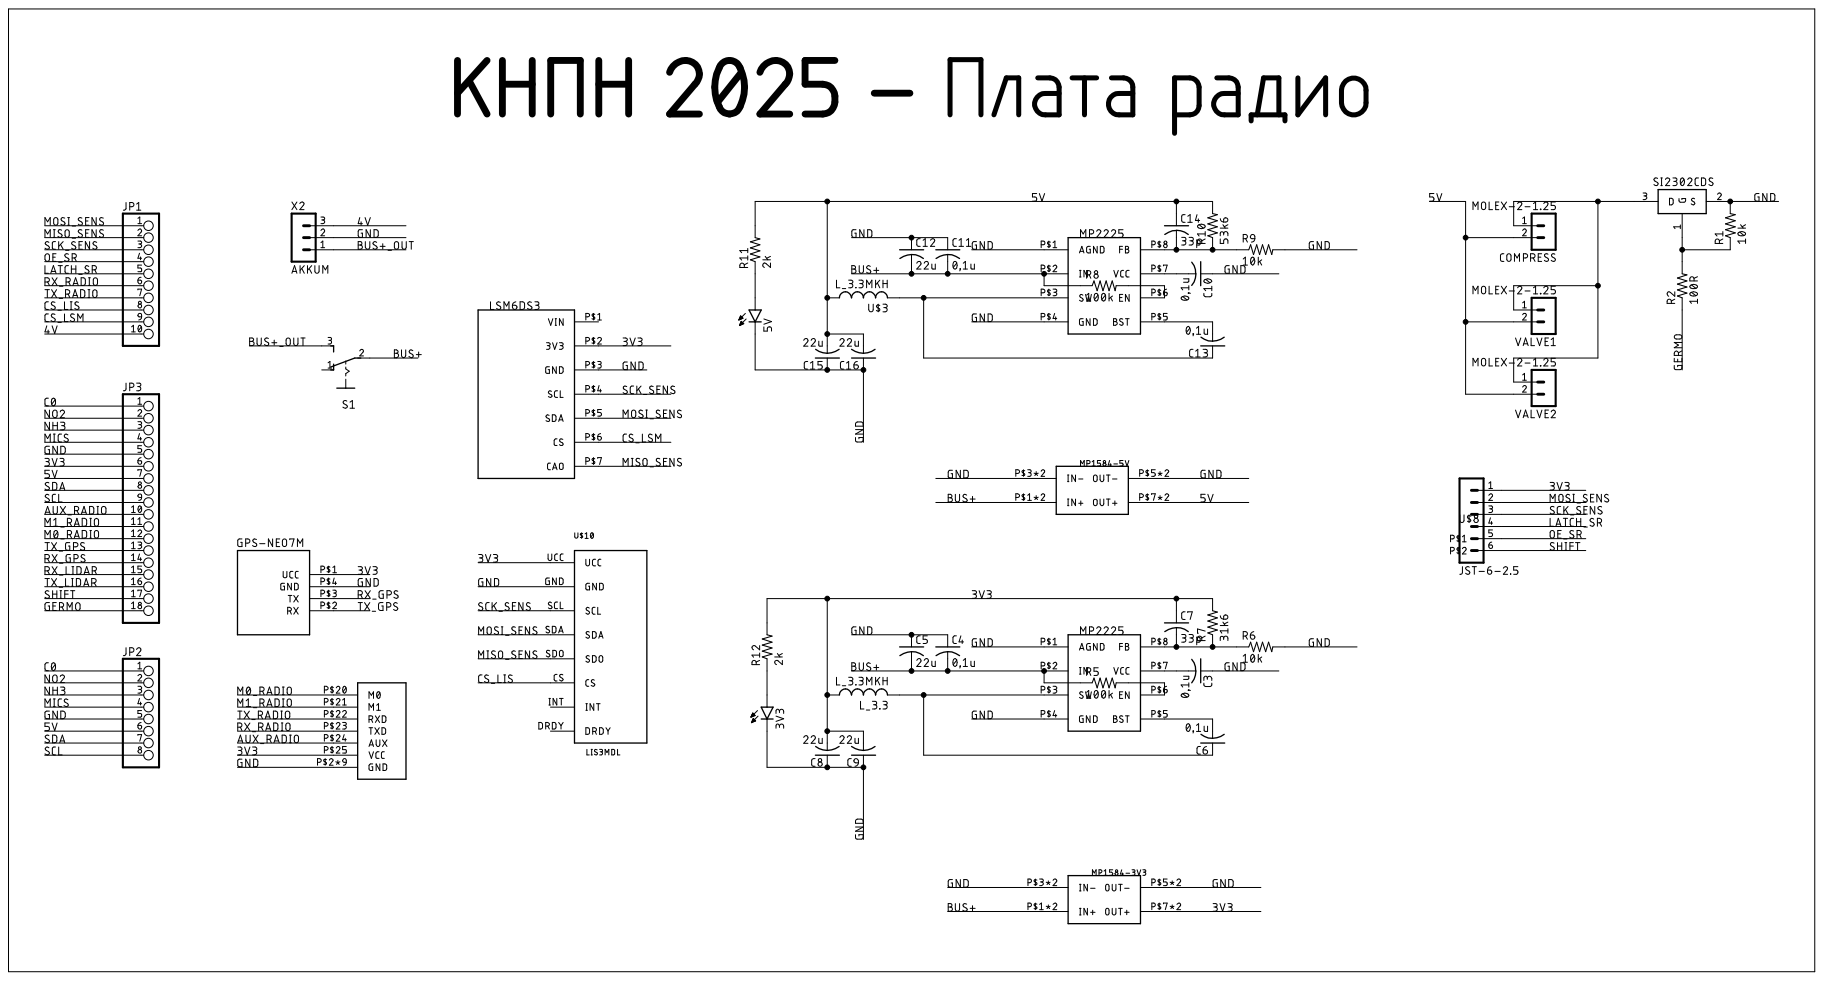
[picture p48: page 2]

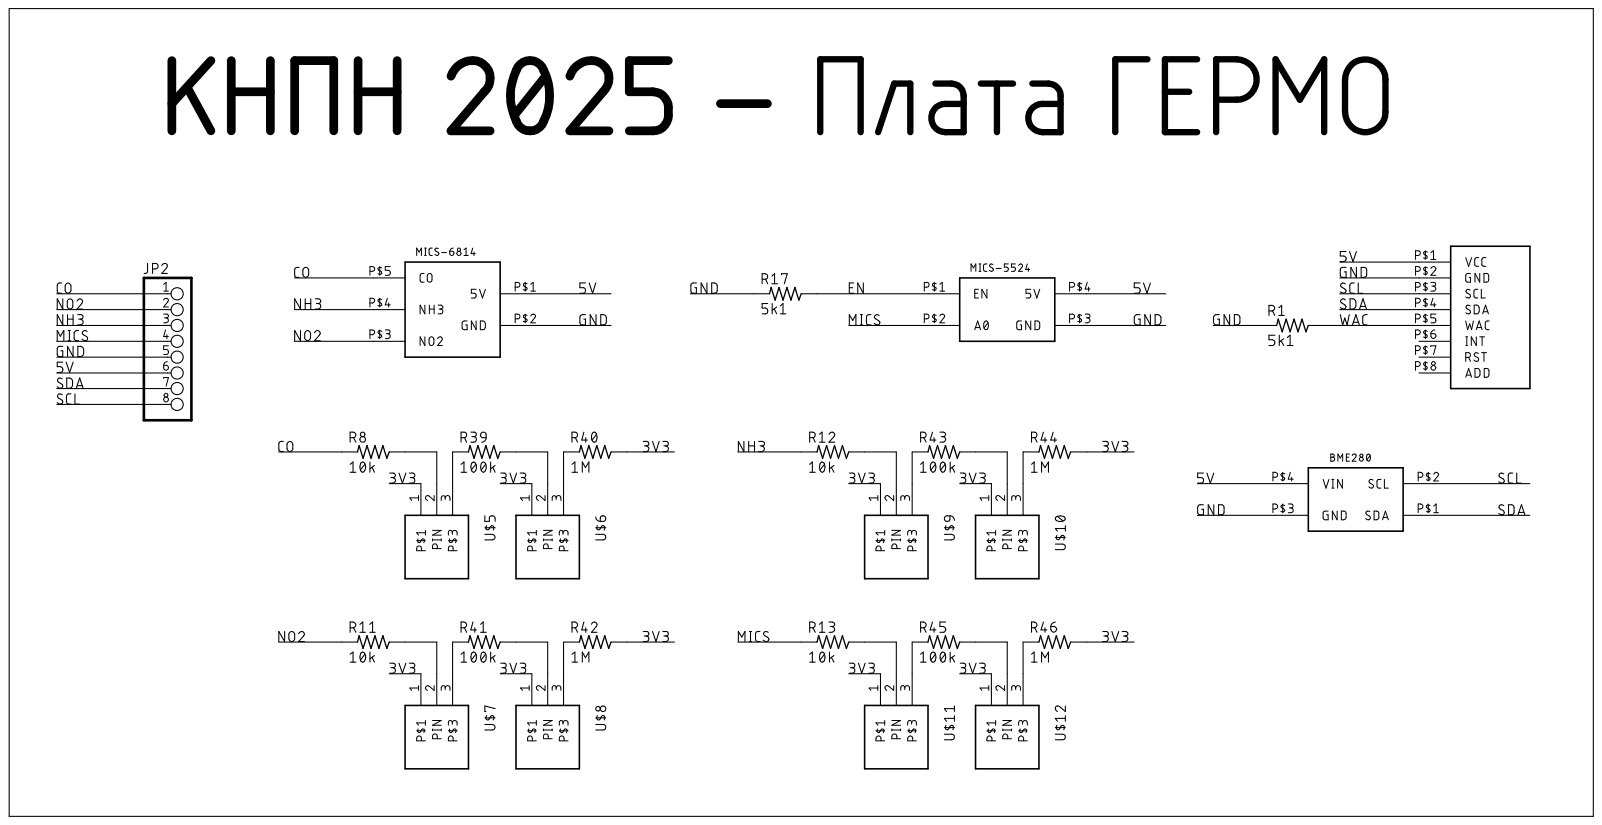
[picture p49: page 3]

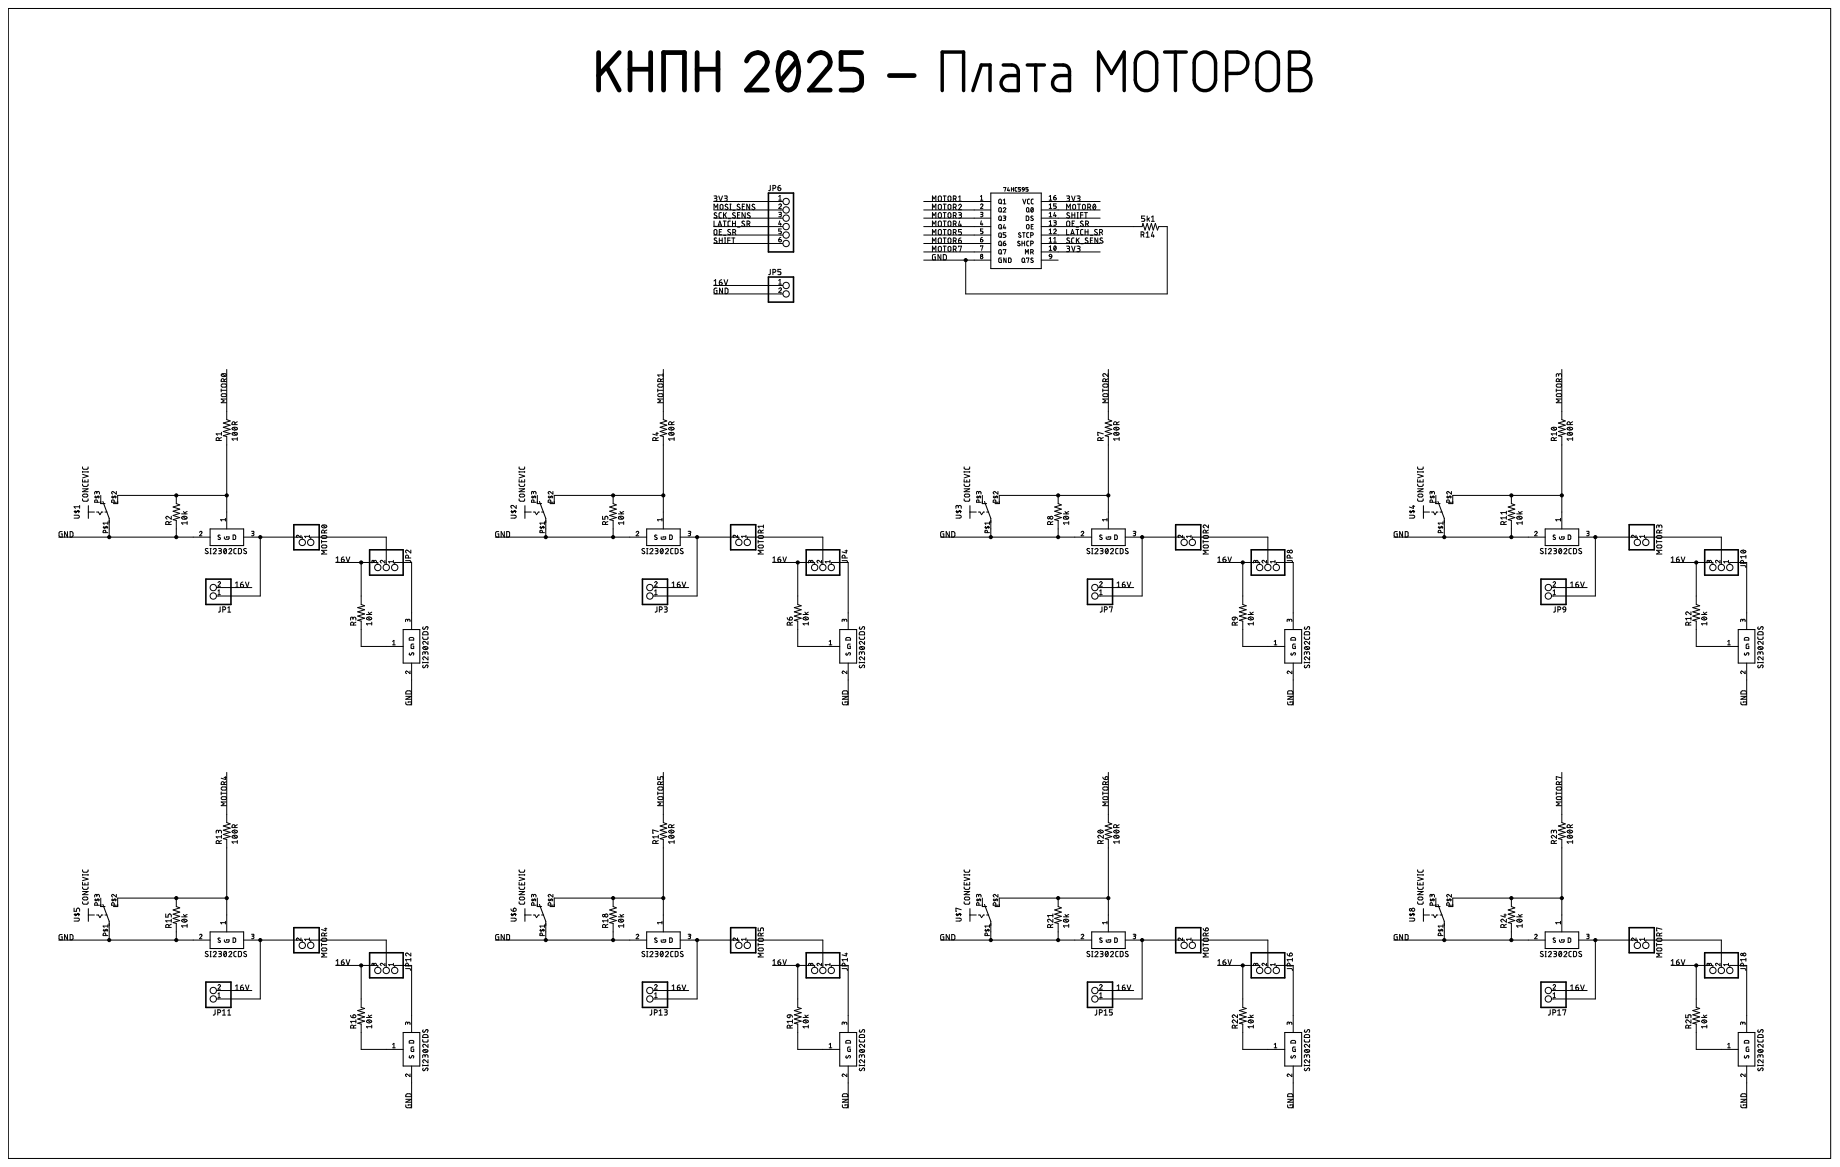
[picture p50: page 4]

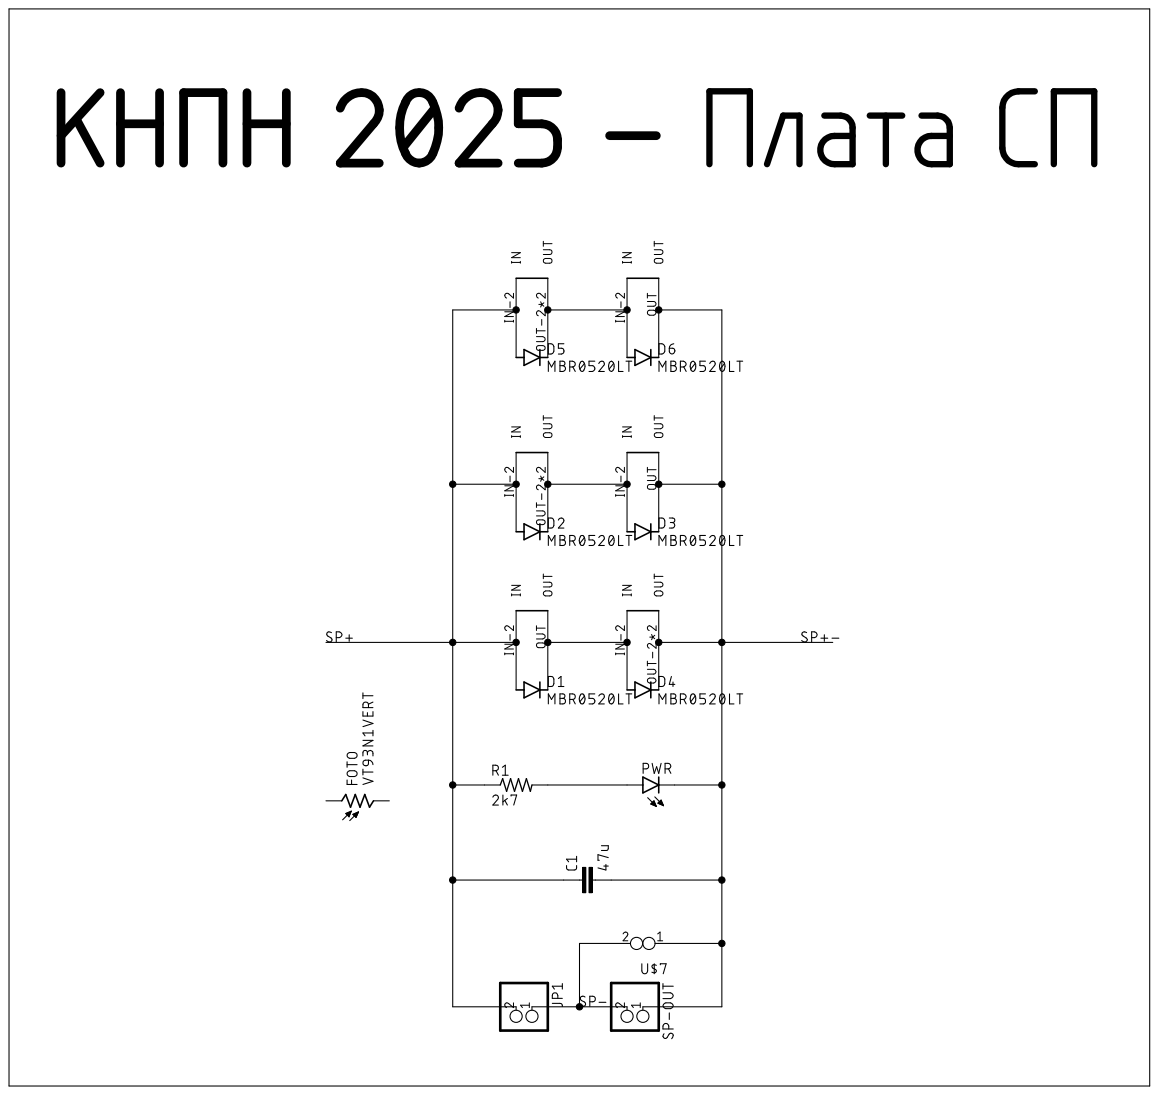
[picture p51: page 5]

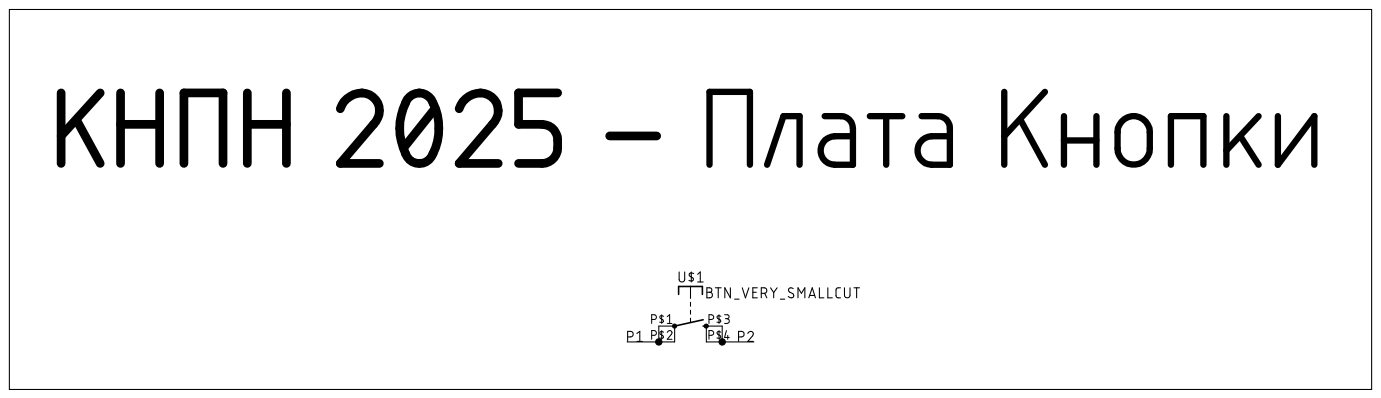
[picture p52: page 6]
