cansat-tsniimash/KNPN-2025/doc/СБ.pdf

АБ

201

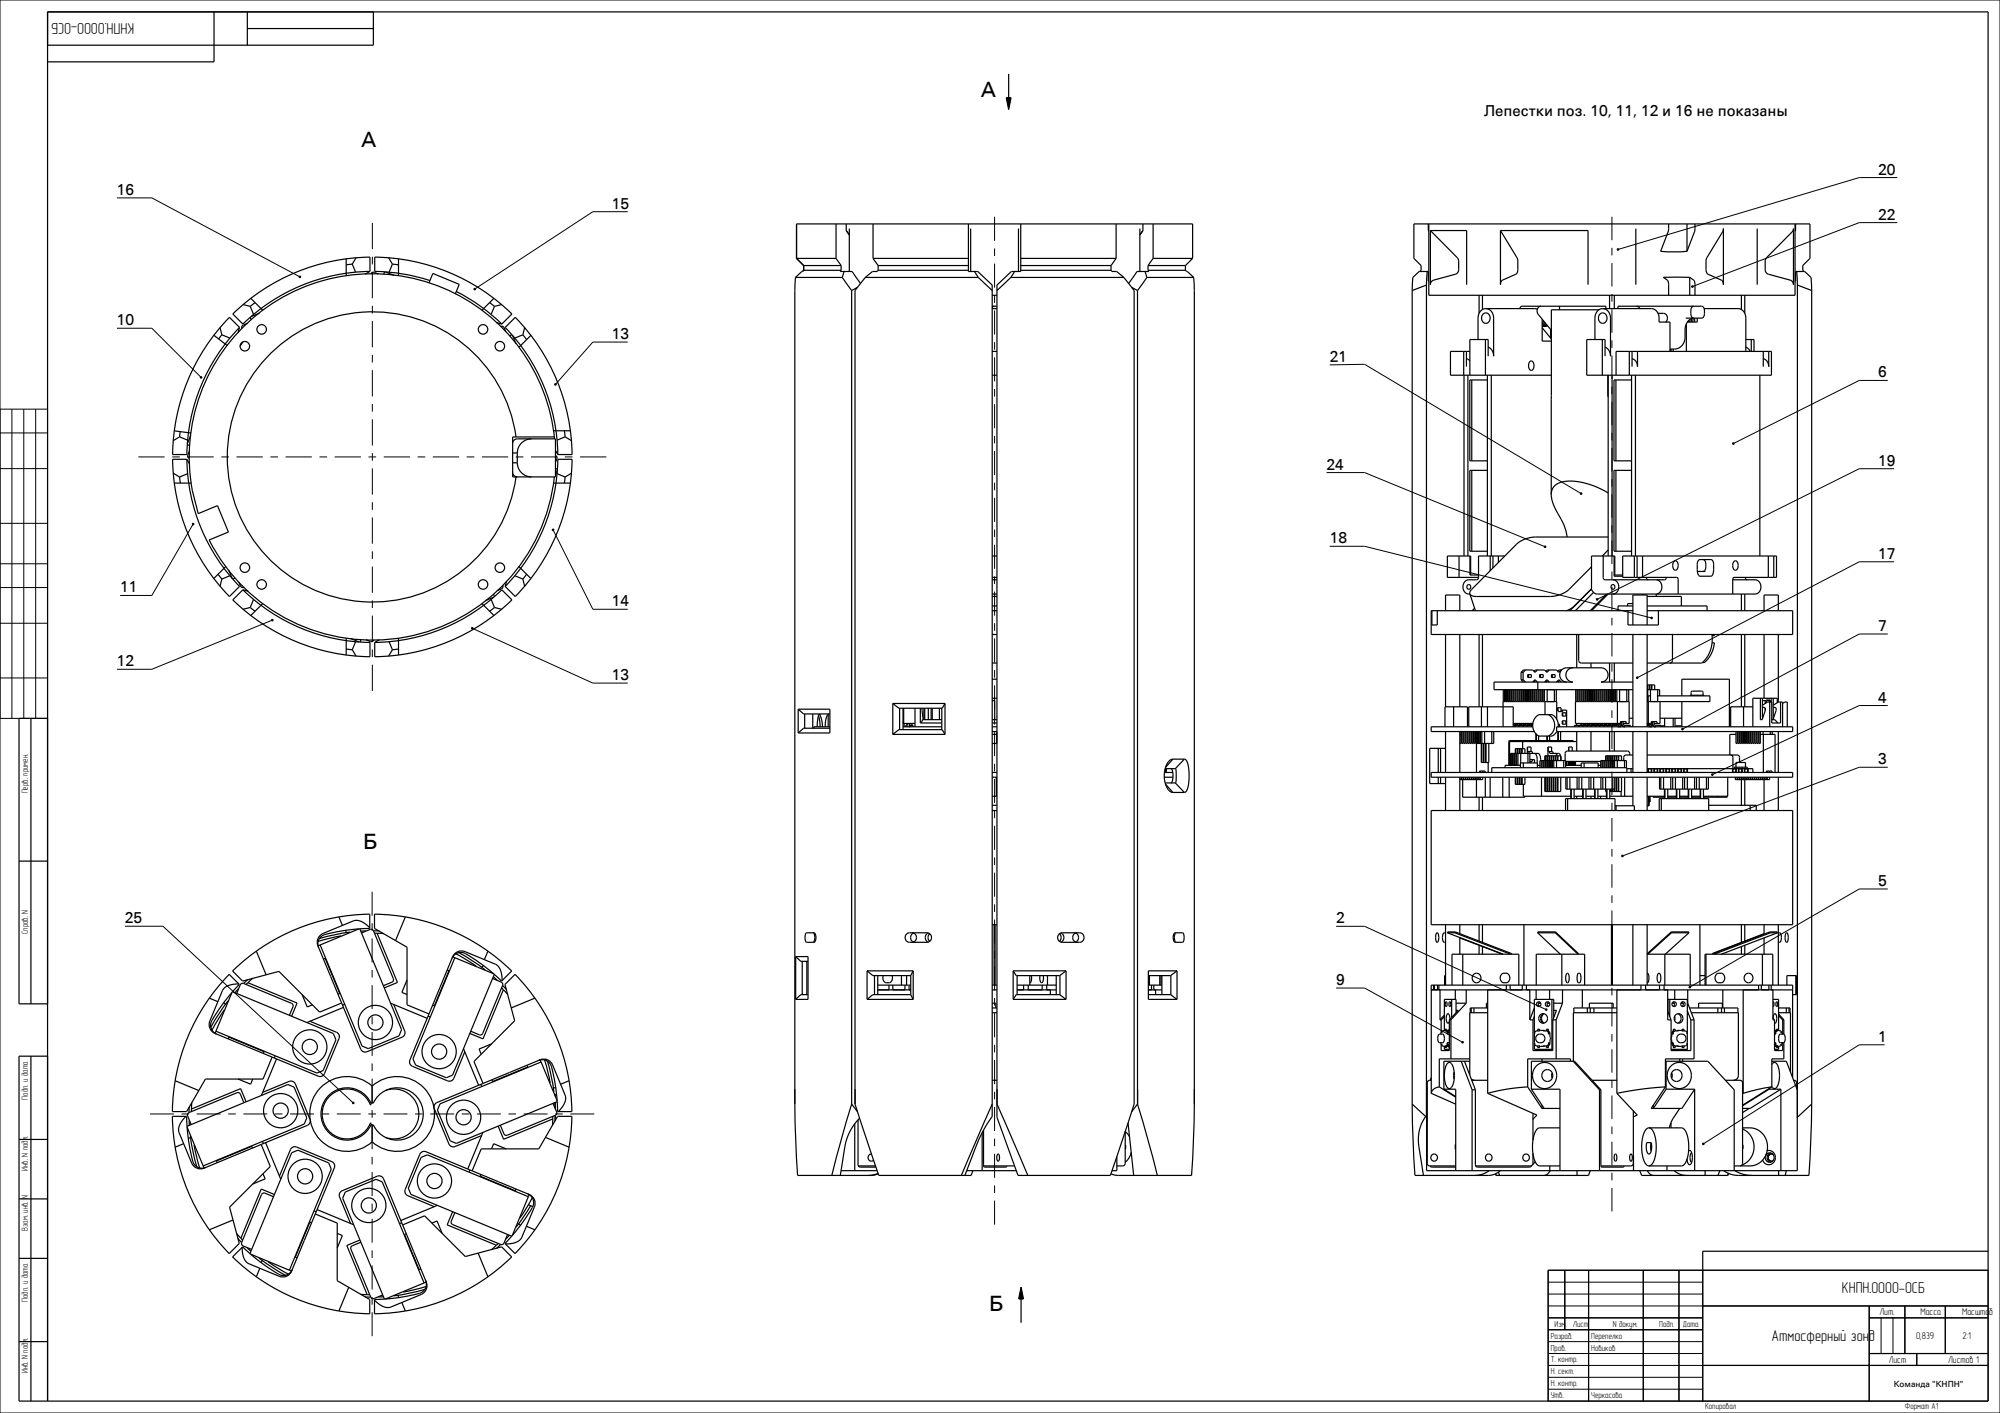
[picture p53: page 1]
Êîïèðîâàë; Ôîðìàò À1 КНПН.0000-0СБ; онд

Лепестки поз. 10, 11, 12 и 16 не показаны

Èíâ. N ïîäë. Ïîäï. è äàòà Âçàì. èíâ. N Èíâ. N ïîäë. Ïîäï. è äàòà Ñïðàâ. N Ïåðâ. ïðèìåí.

Атмосфе рный з | Ëèò. | Ìàññ à | Ìà ñøòàá

È çì. Ëè | ò ñ | N äîêóì. | î äï. Ï | Äàòà | | | | | 0,839 | 2:1
Ðà çðàá. | | Пе е елко р п
Ïðîâ. | | Новиков
Ò. êî íòð. | | | | | Ëè ñò | Ëè ñòîâ 1
Í. ñåêò. Í. êîíòð. | | | | | Команда "КНПН"

Óòâ. | Черка сова
