cansat-tsniimash/KNPN-2025/Winter Session/компоновка.pdf

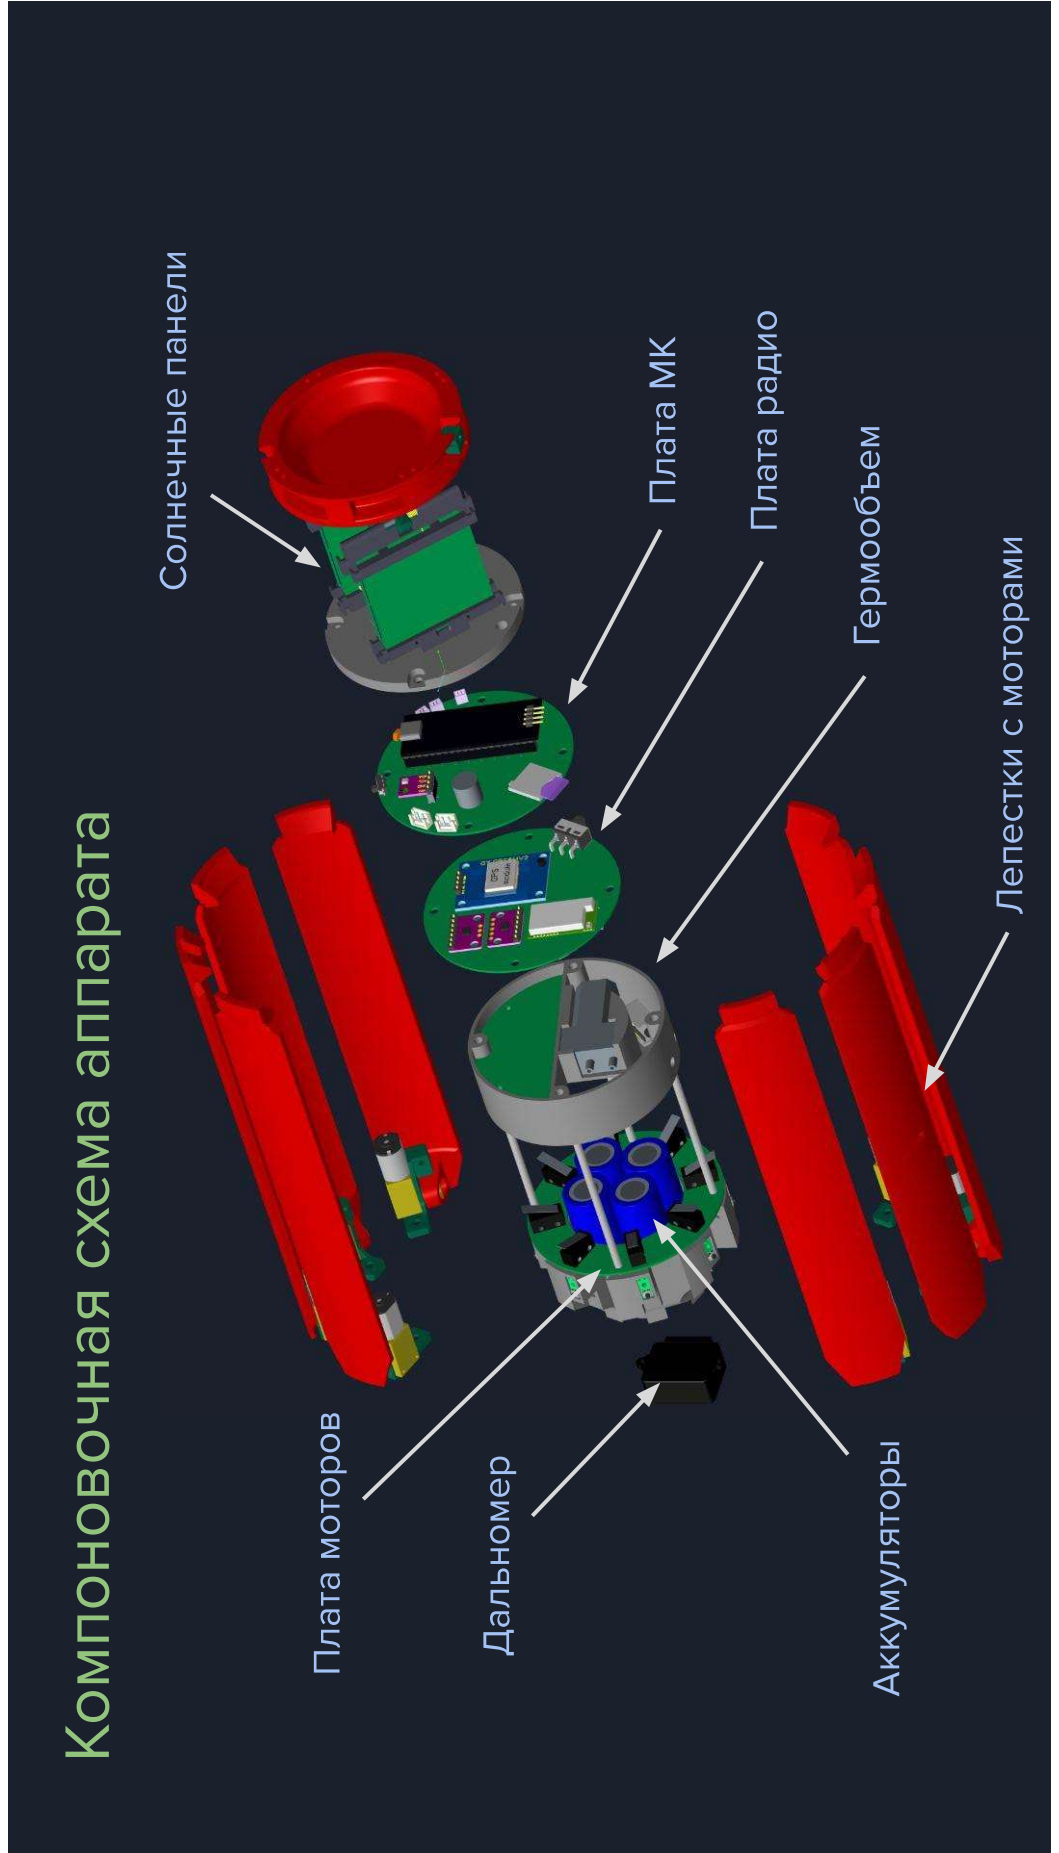
[picture p54: page 1]
