cansat-tsniimash/KNPN-2025/Winter Session/парашют.pdf

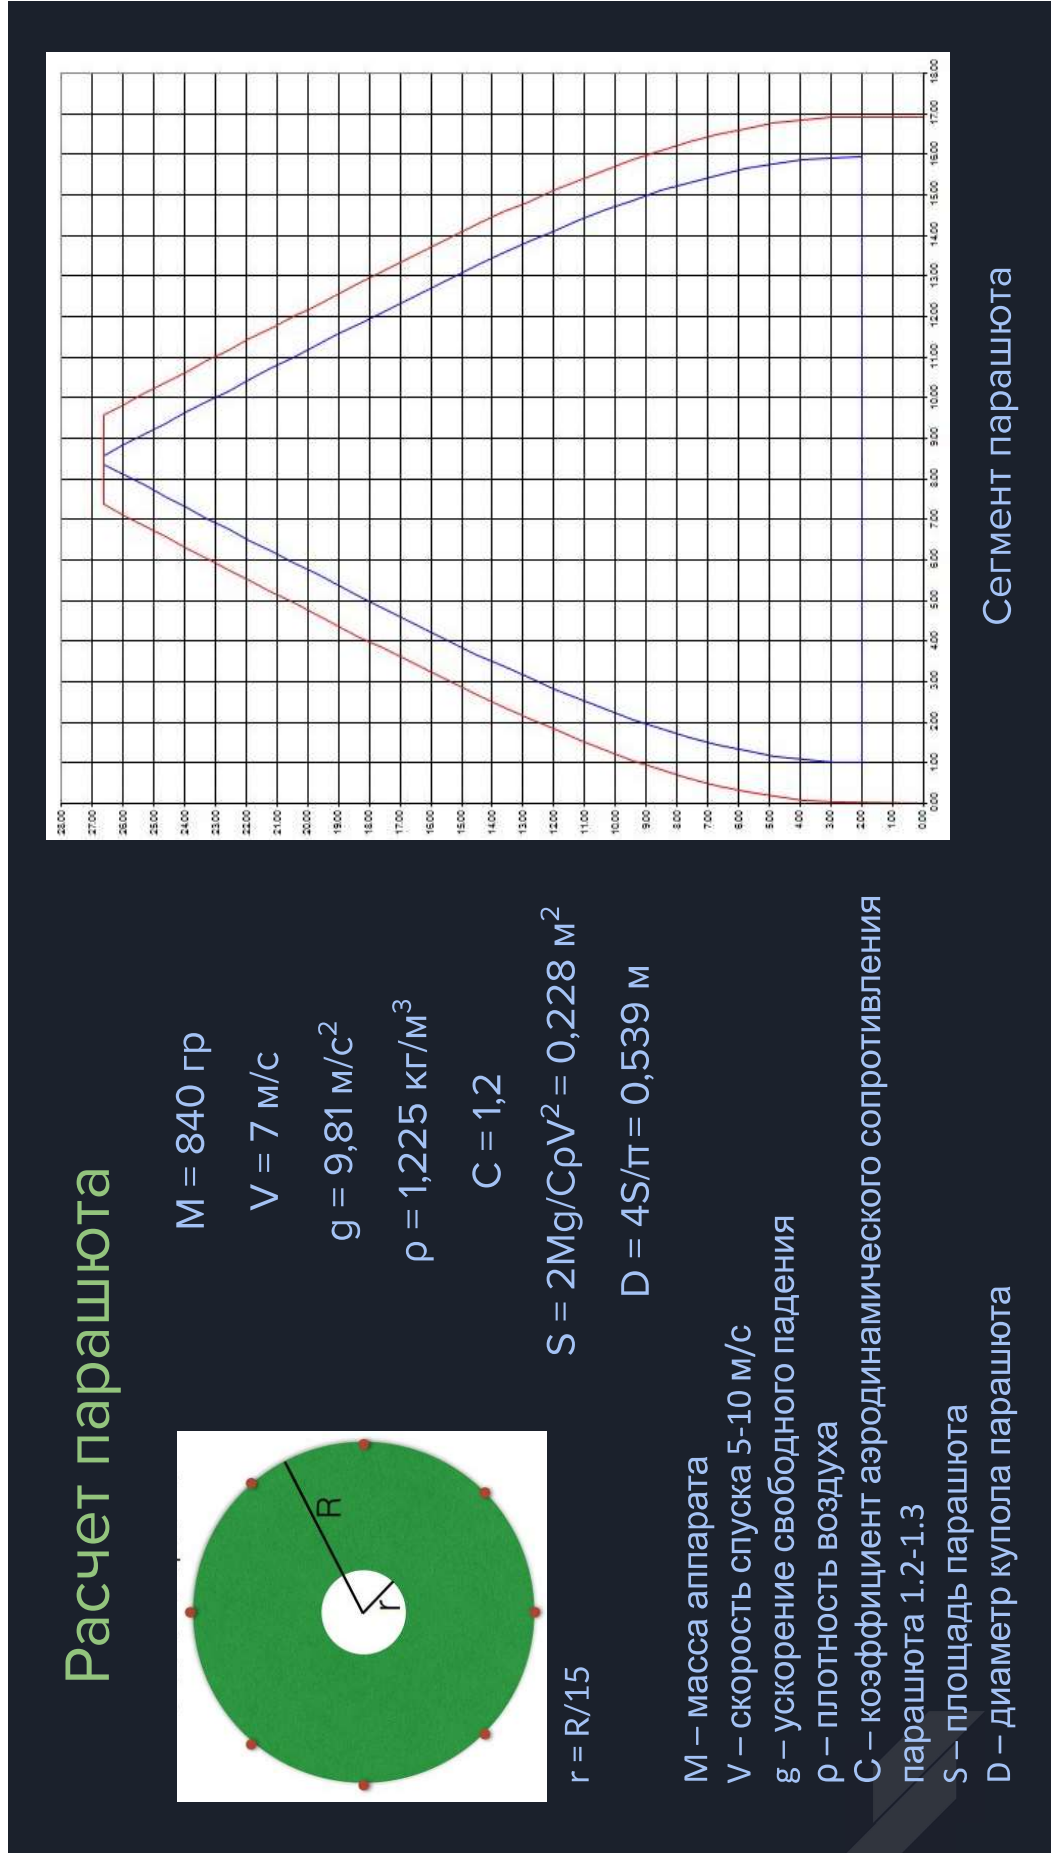
[picture p55: page 1]
