cansat-tsniimash/KNPN-2025/Winter Session/Расчет параметров системы спасения.pdf

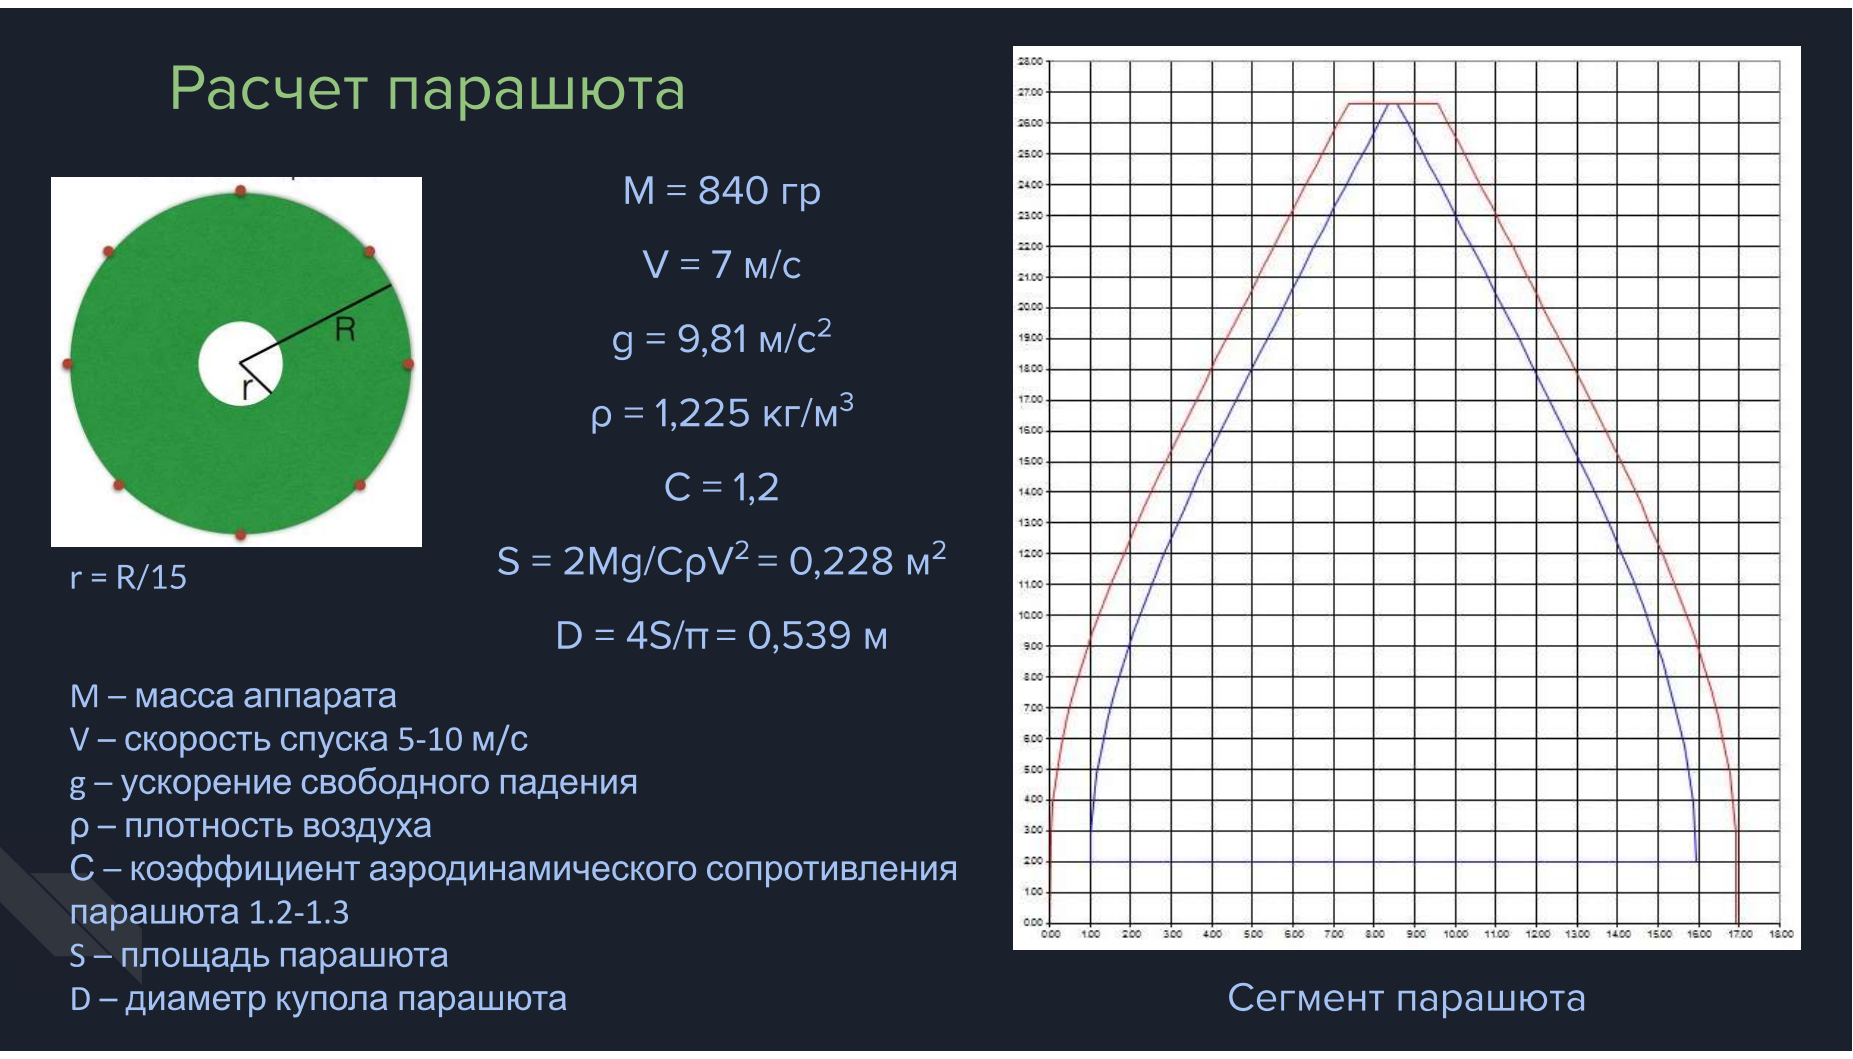
[picture p56: page 1]
