cansat-tsniimash/KNPN-2025/Winter Session/Расчет энергопотребления.pdf

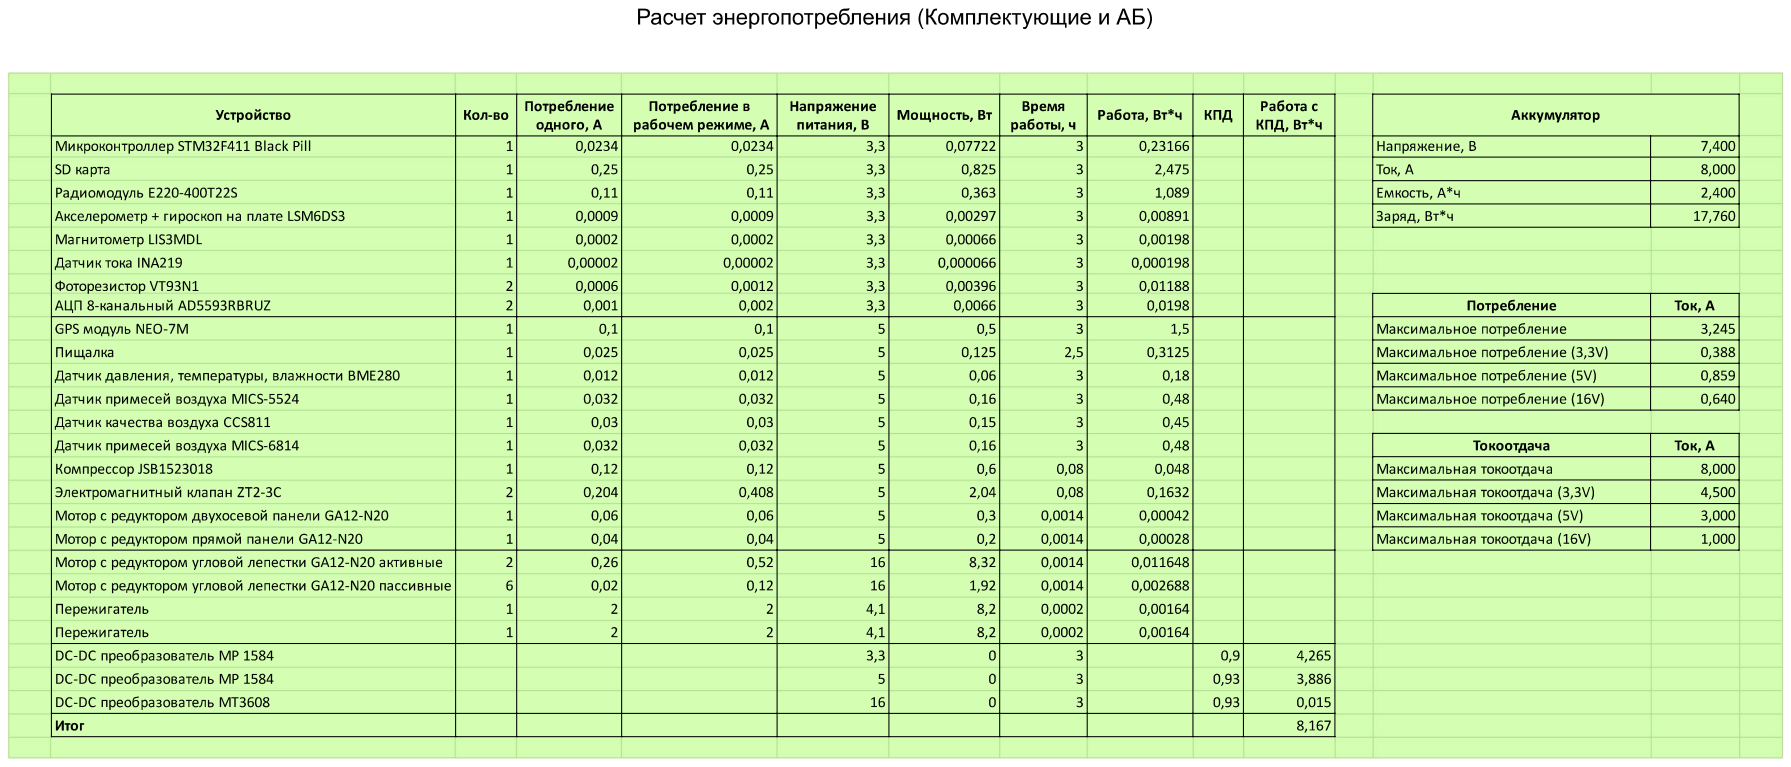
[picture p57: page 1]

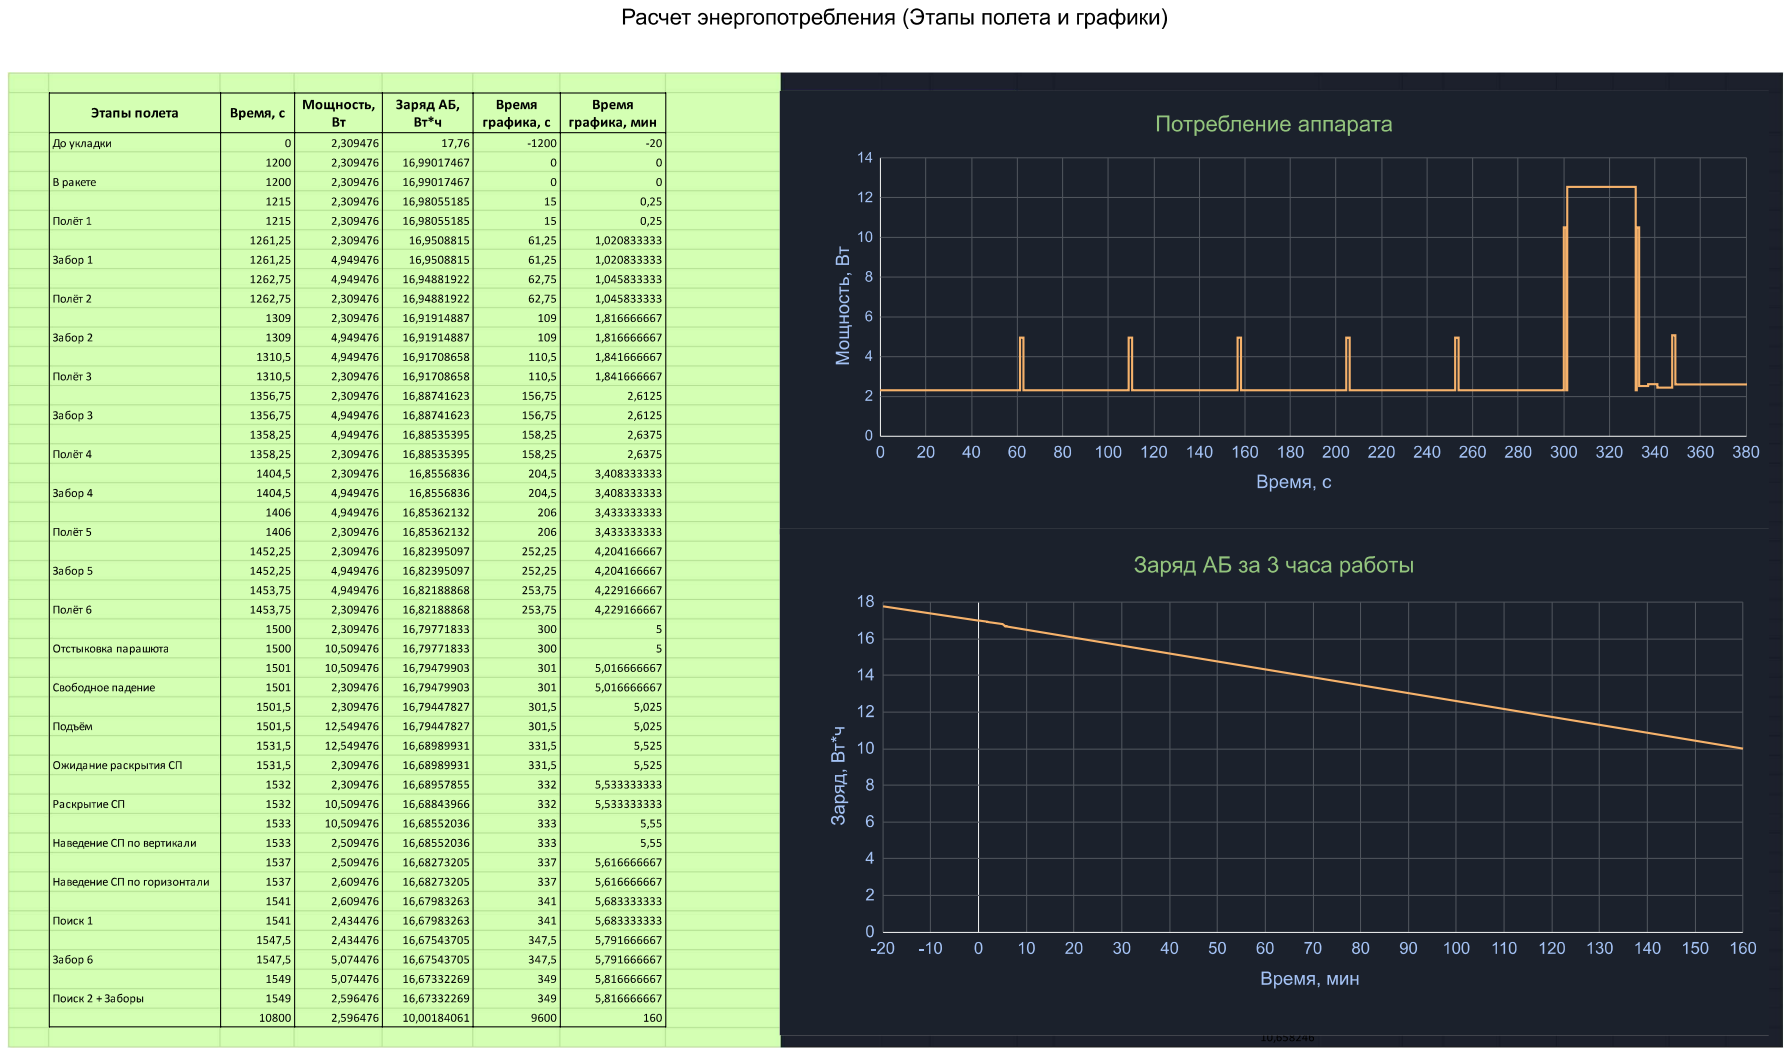
[picture p58: page 2]
