cansat-tsniimash/KNPN-2025/Winter Session/Сборочный чертеж.pdf

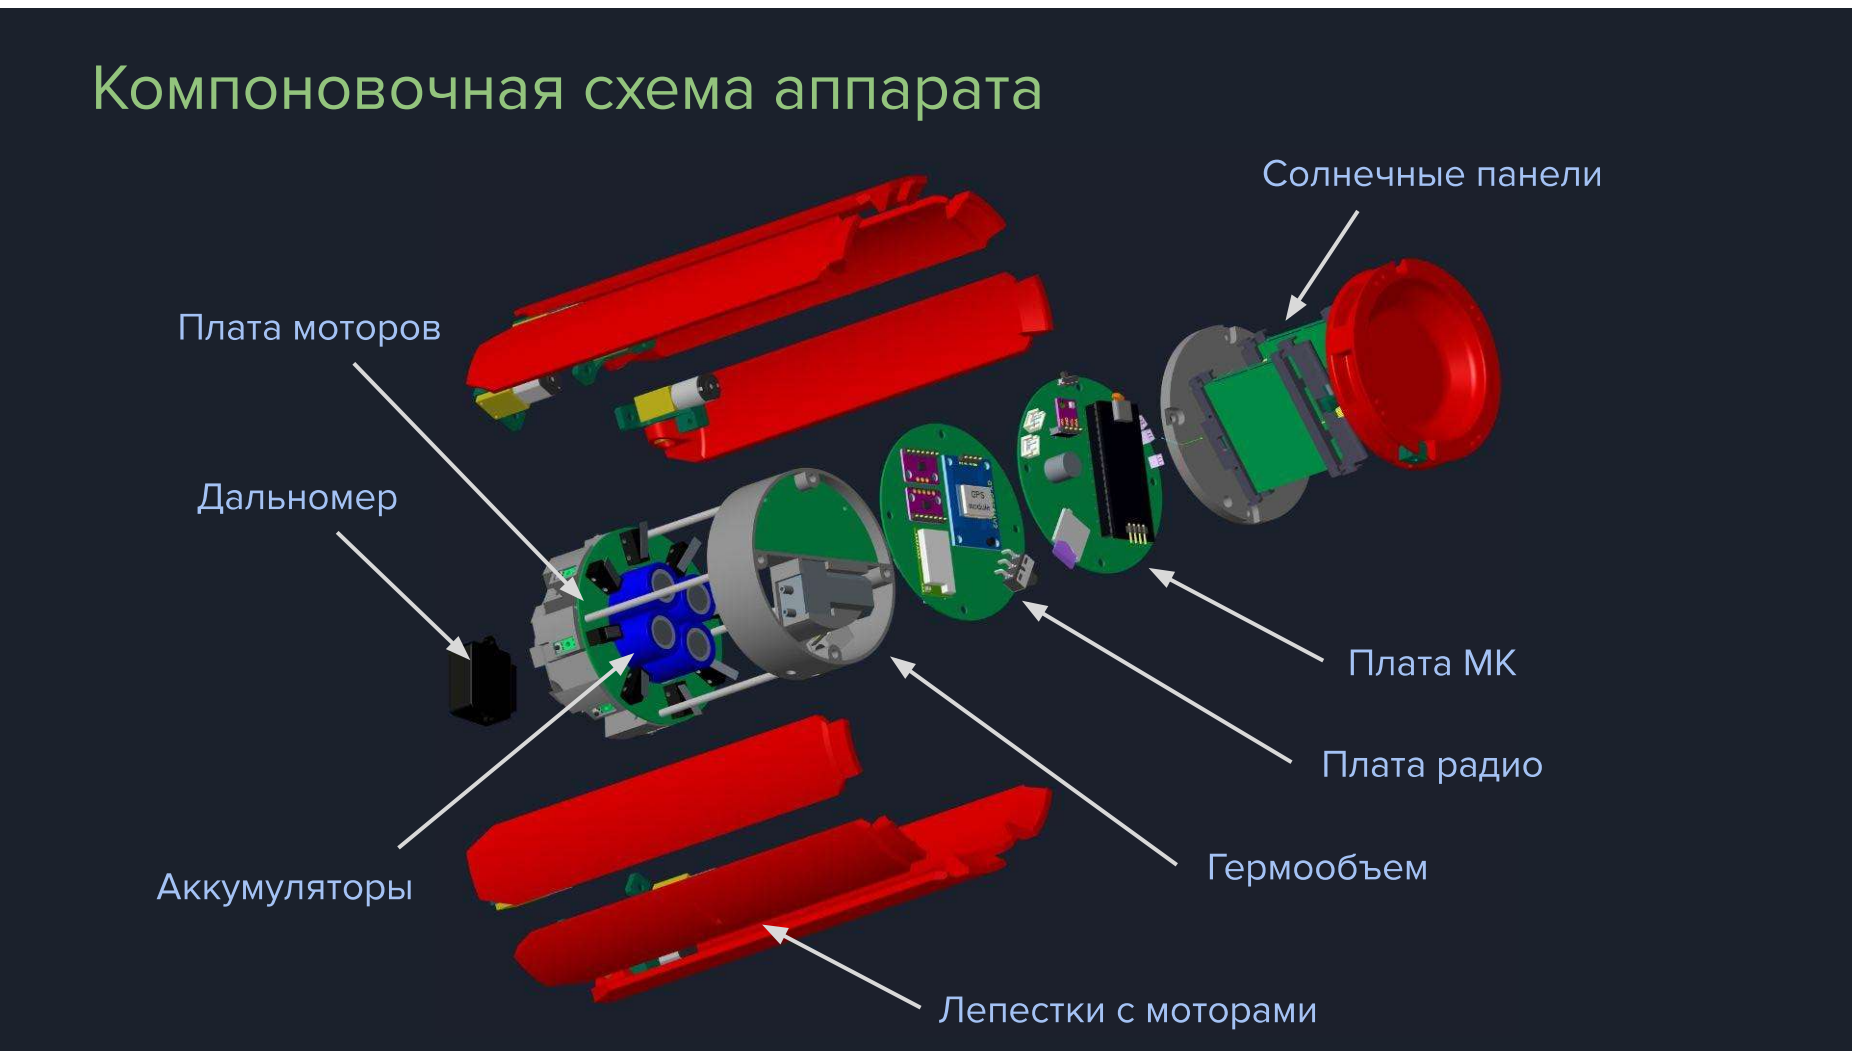
[picture p59: page 1]
