cansat-tsniimash/KNPN-2025/Winter Session/Энергобаланс 2.pdf

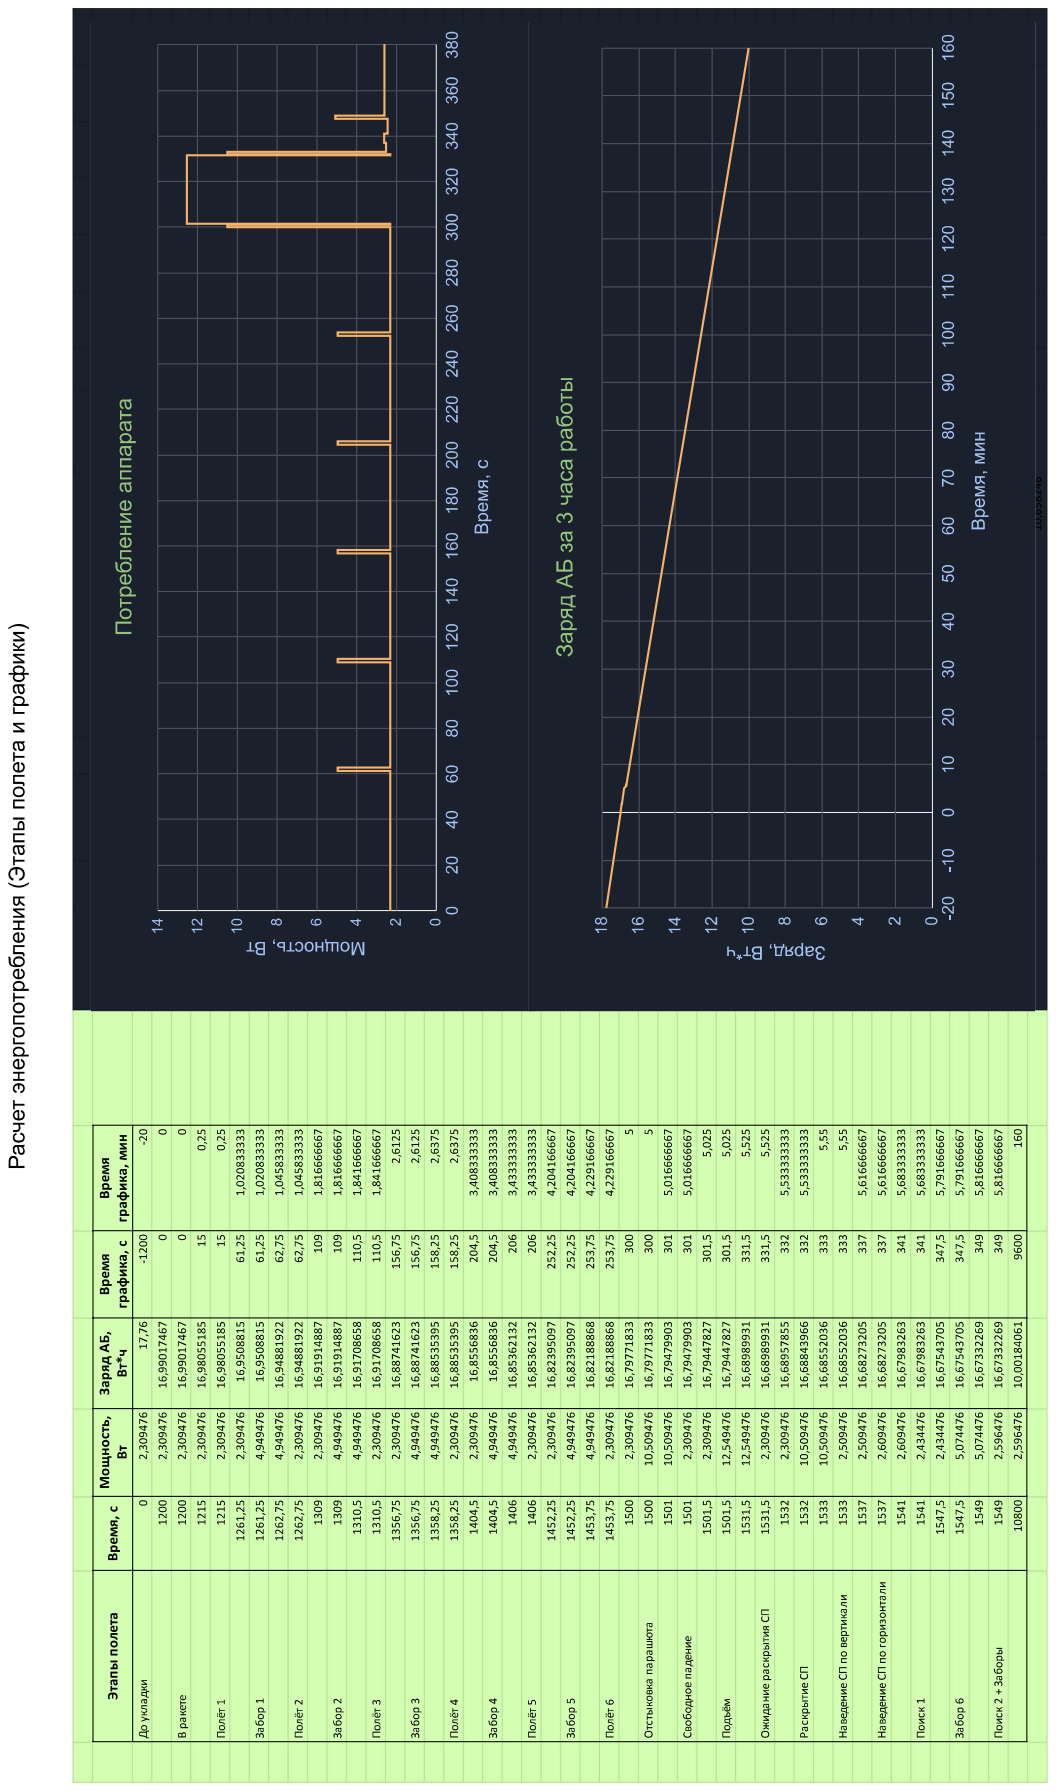
[picture p60: page 1]
