cansat-tsniimash/KNPN-2025/Winter Session/энергобаланс1.pdf

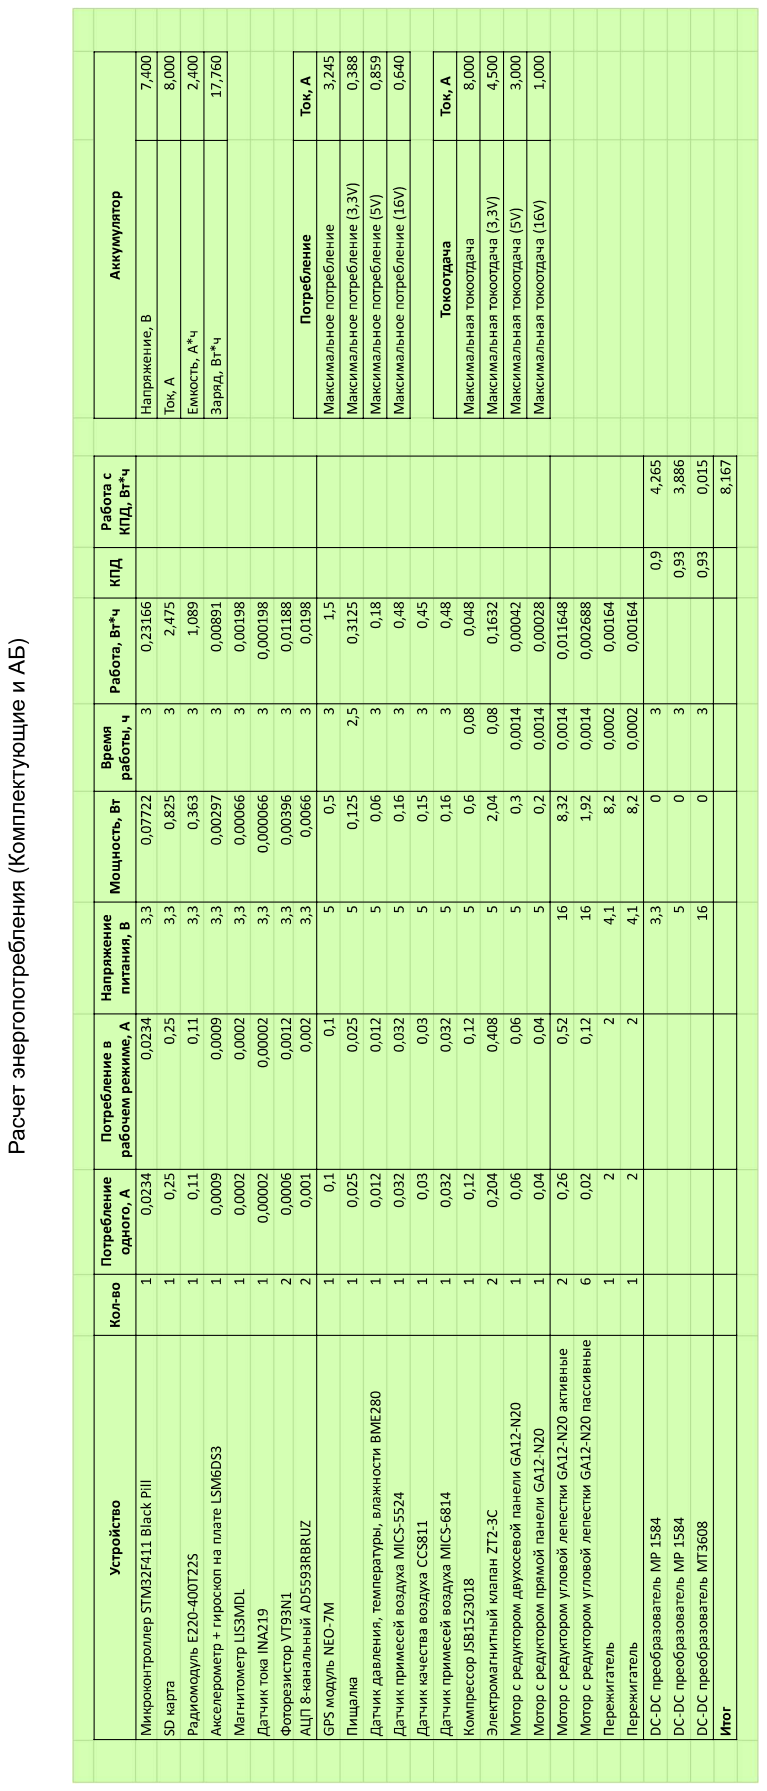
[picture p61: page 1]
