cansat-tsniimash/KNPN-2025/Winter Session/Материалы на ЗС/Габаритный чертеж.pdf

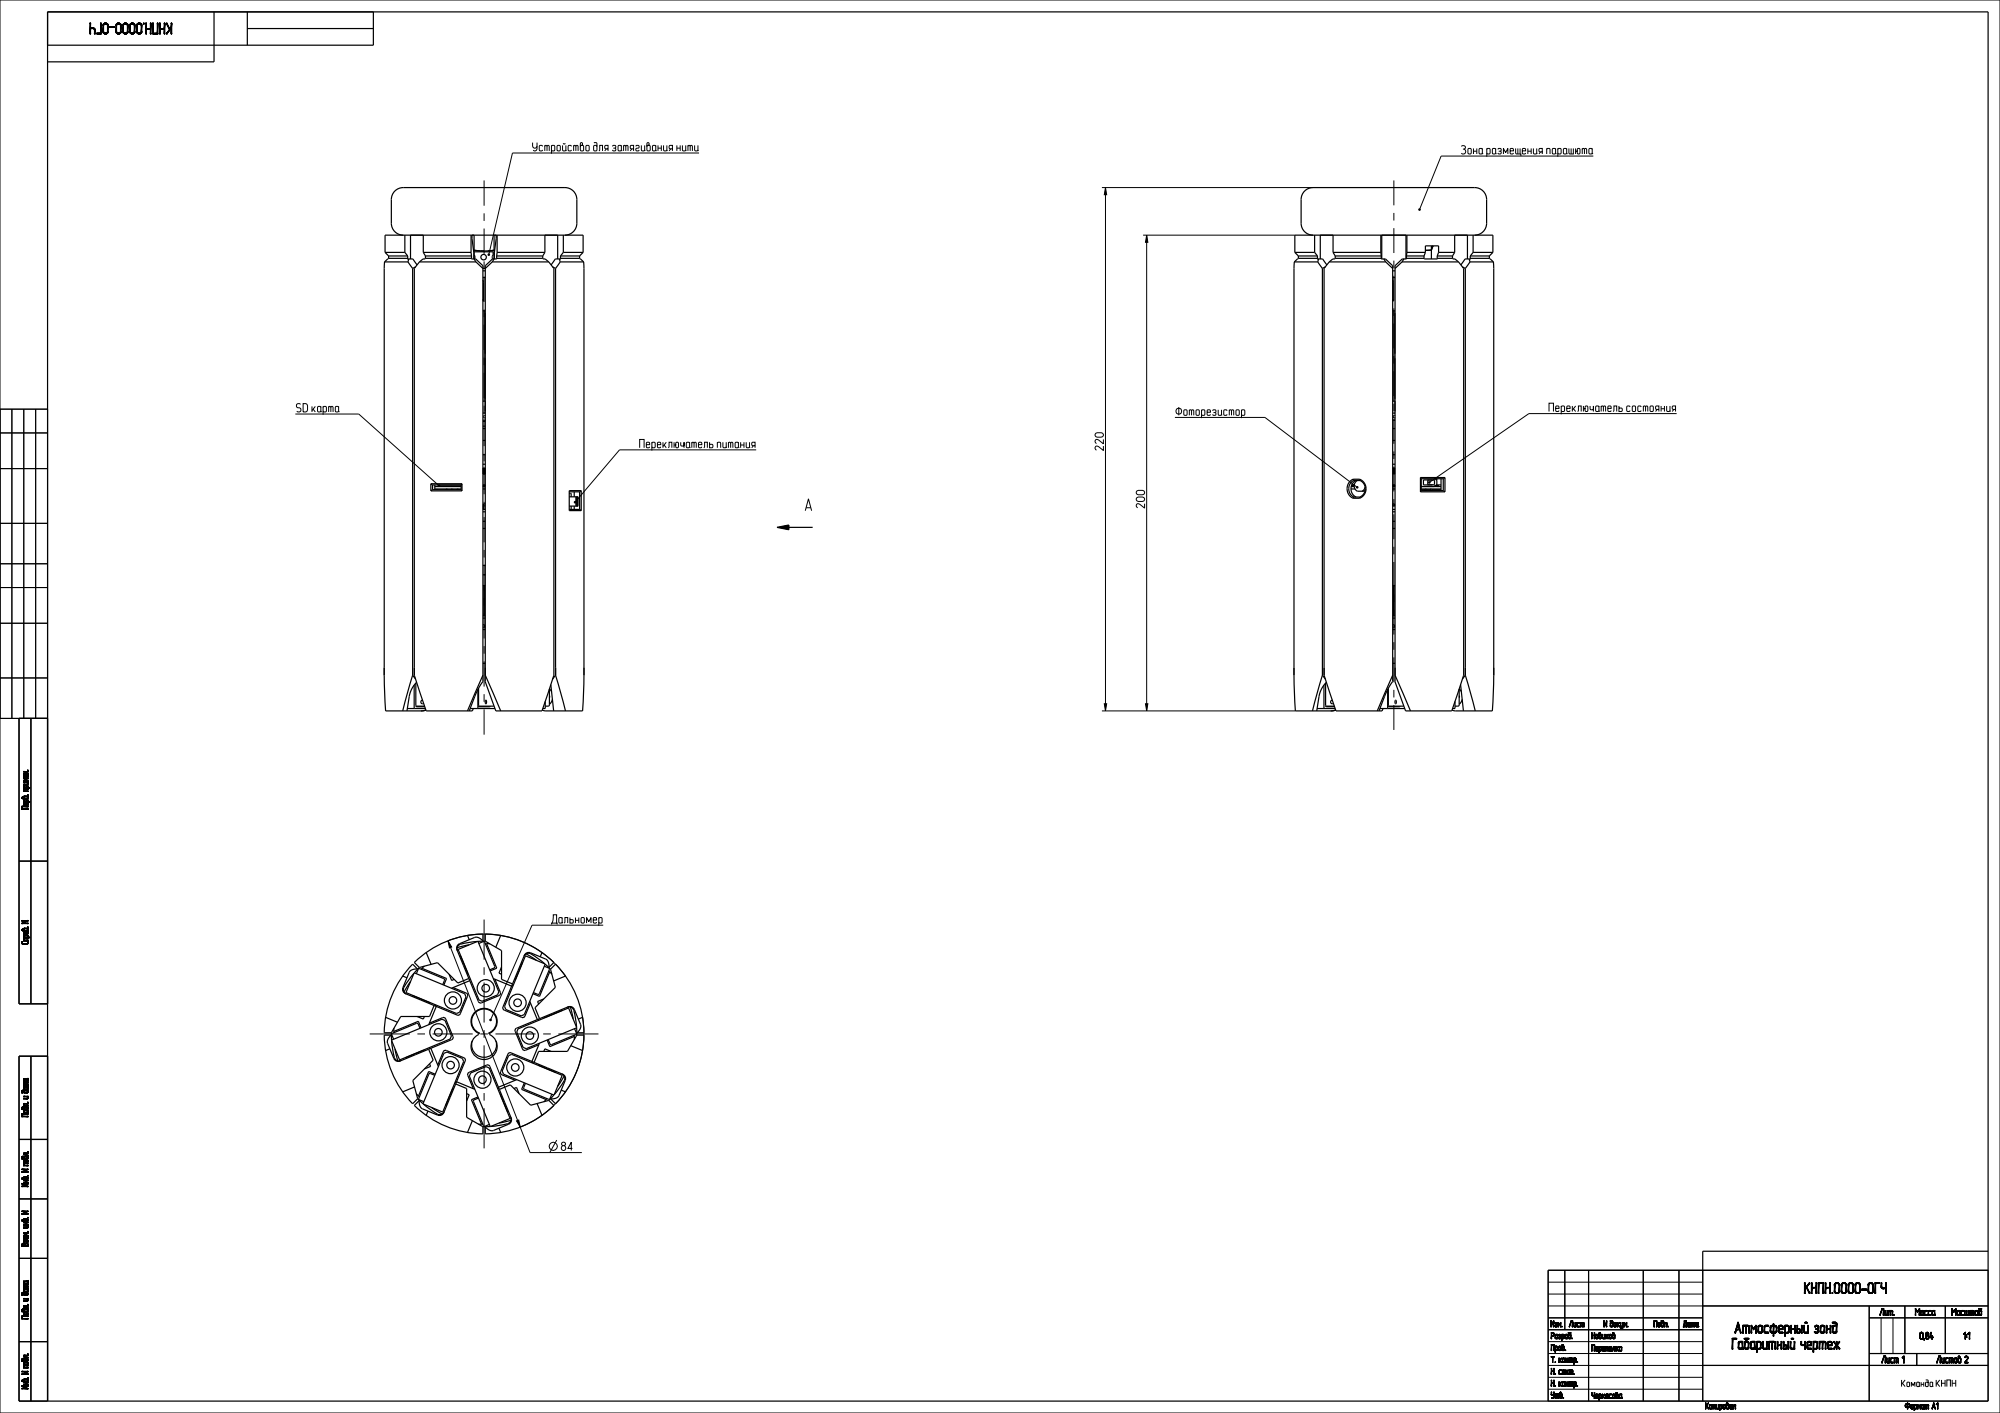
[picture p62: page 1]
Êîïèðîâàë; Ôîðìàò À1; Атмосферный зонд Габаритный чертеж; Фоторезистор; Переключатель состояния; Устройство для затягивания нити; Зона размещения парашюта; SD карта; Переключатель питания; Дальномер

Èíâ. N ïîäë. Ïîäï. è äàòà Âçàì. èíâ. N Èíâ. N ïîäë. Ïîäï. è äàòà Ñïðàâ. N Ïåðâ. ïðèìåí. Èíâ. N ïîäë. Ïîäï. è äàòà Âçàì. èíâ. N Èíâ. N ïîäë. Ïîäï. è äàòà Ñïðàâ. N Ïåðâ. ïðèìåí.

КНПН.0000-0ГЧ

Ëèò. | Ìàññà | Ìàñøòàá

Èçì. Ëèñò | | N äîêóì. | Ïîäï. | Äàòà | | | | | 0,84 | 1:1

Ðàçðàá. | | Новиков
Ïðîâ. | | Перепелко
Ò. êîíòð. | | | | | Ëèñò 1 | Ëèñòîâ 2
Í. ñåêò. | | | | | Команда КНПН
Í. êîíòð.
Óòâ. | Черкасова

Б

А

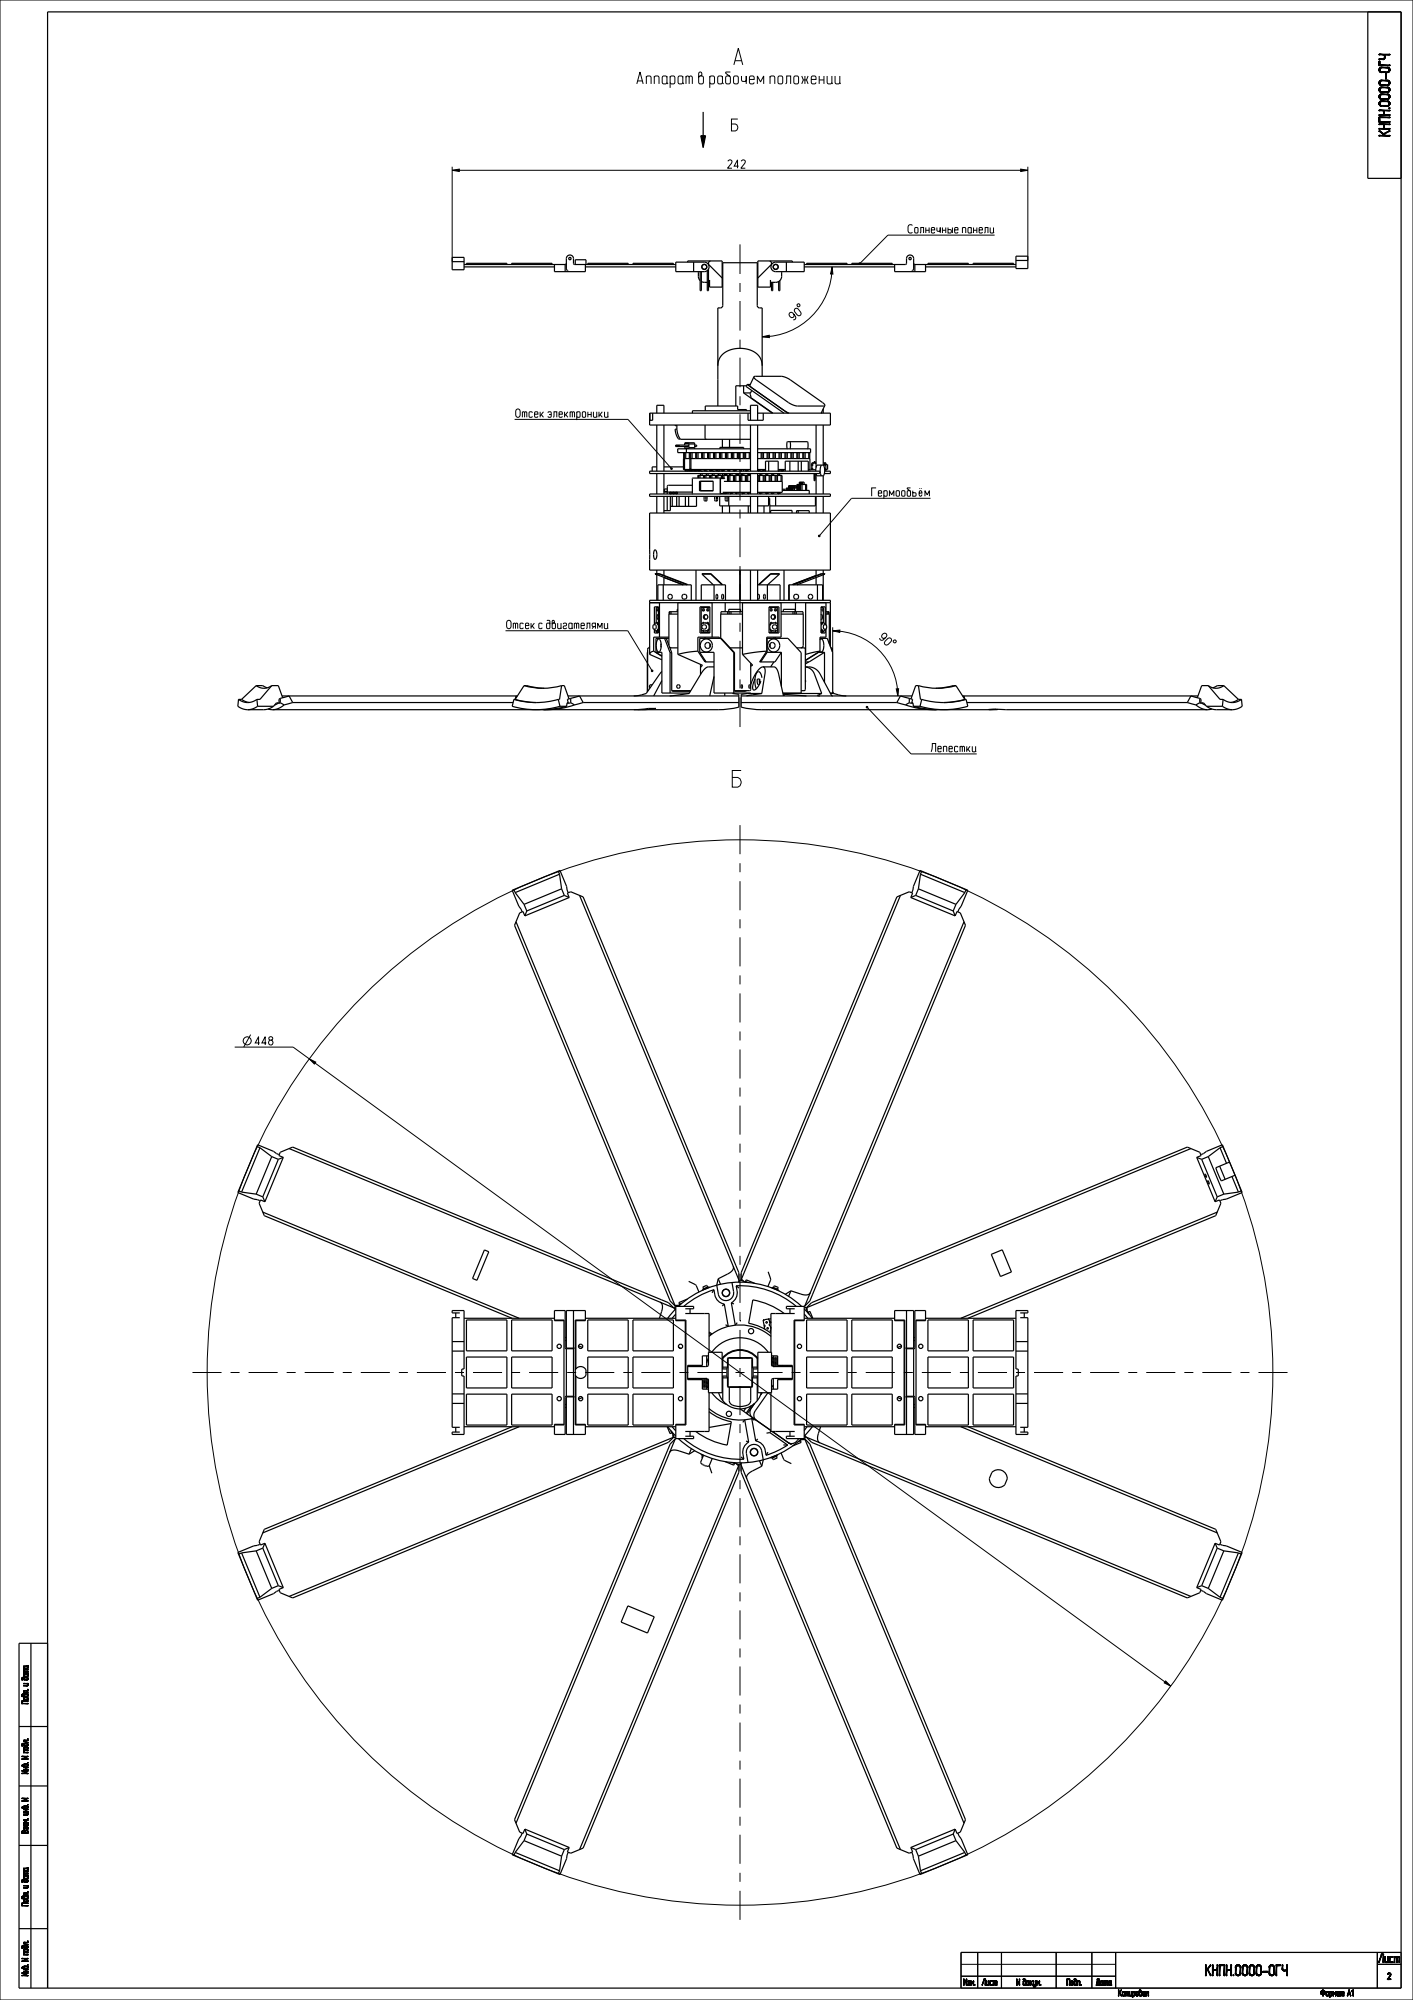
[picture p63: page 2]
Êîïèðîâàë; Ôîðìàò À1; Ëèñò; КНПН.0000-0ГЧ; Солнечные панели; Отсек электроники; Гермообьём; Отсек с двигателями; Лепестки

Аппарат в рабочем положении

Èíâ. N ïîäë. Ïîäï. è äàòà Âçàì. èíâ. N Èíâ. N ïîäë. Ïîäï. è äàòà

КНПН.0000-0ГЧ | 2 Èçì. Ëèñò
N äîêóì. | Ïîäï. | Äàòà
