cansat-tsniimash/KNPN-2025/schematics/RADIO.brd

## EAGLE design schematics/RADIO.brd (2025-03-26)

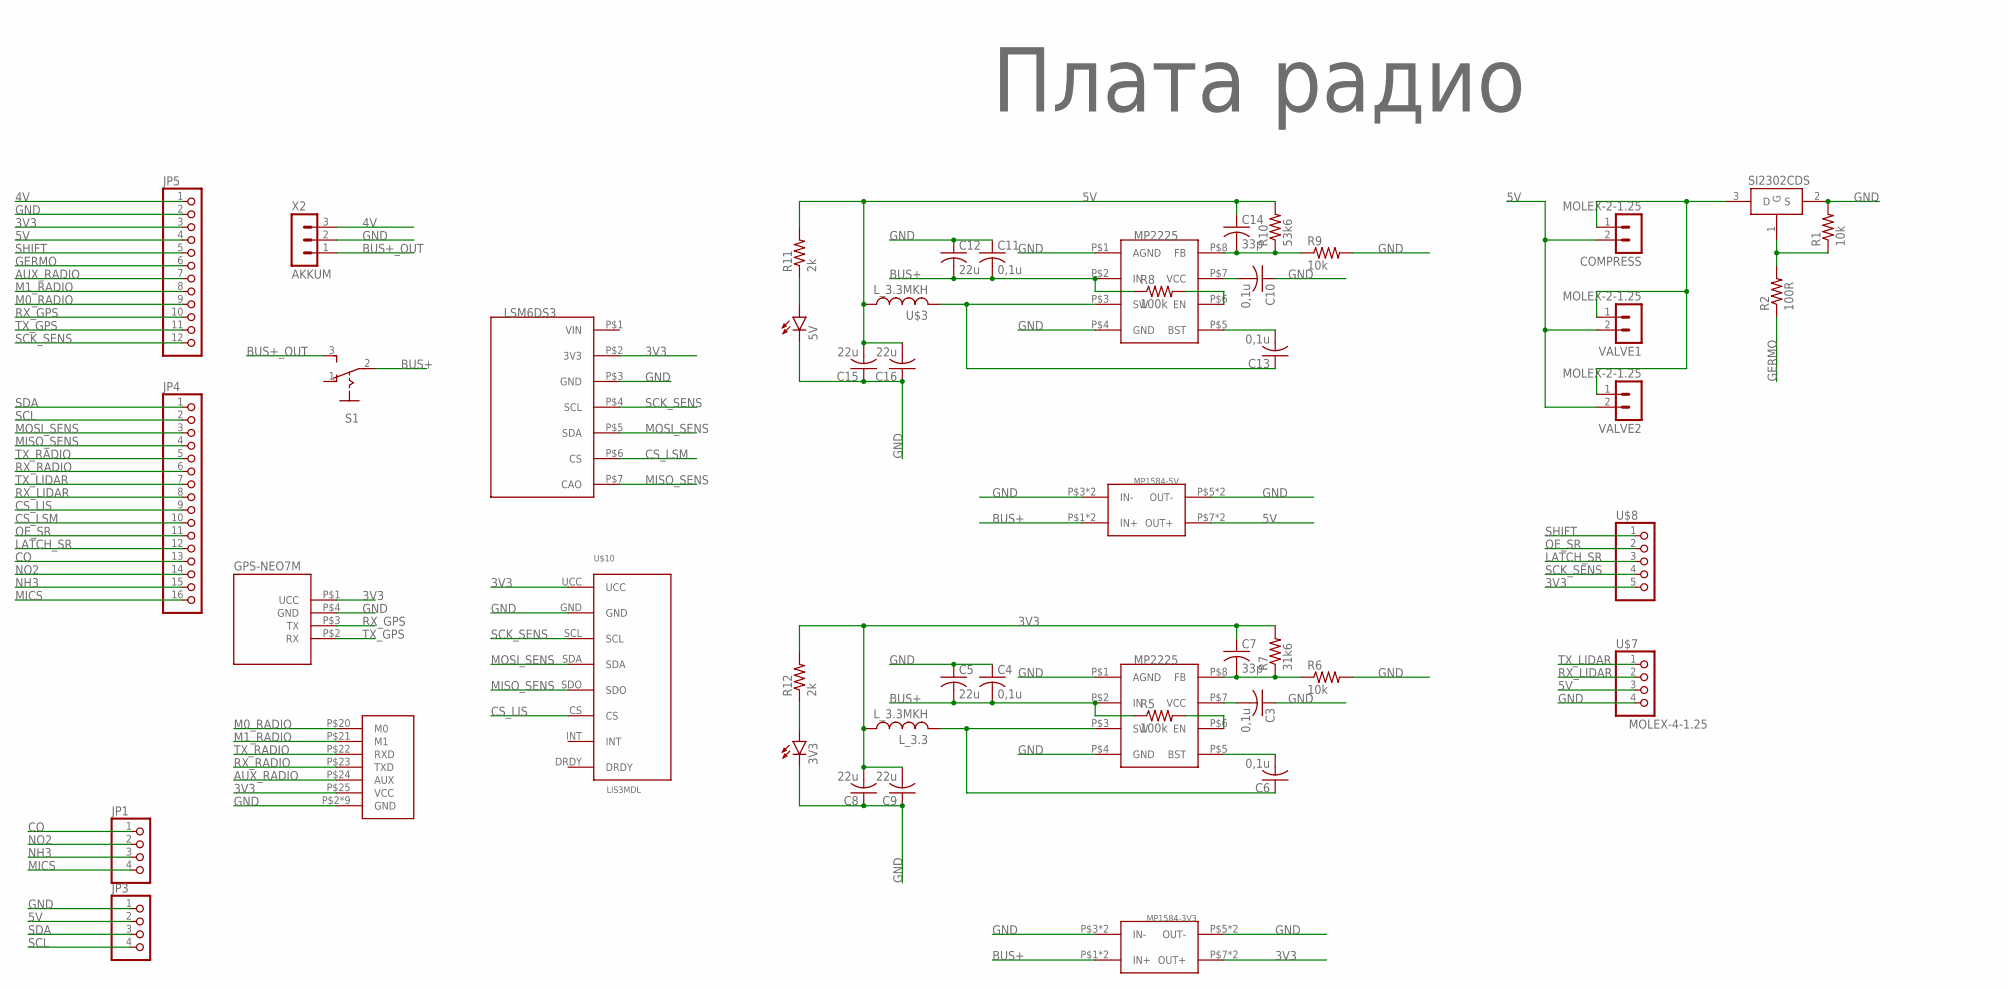
[picture p64: schematic RADIO.sch]

Parts:
3V3, 5V: LEDCHIP-LED0603; CHIP-LED0603
C3, C6, C10, C13: 0,1u; C0603
C4, C11: 0,1u; C1206
C5, C12: 22u; C0603
C7, C14: 33p; C0603
C8, C9, C15, C16: 22u; C1206
COMPRESS: MOLEX-2-1.25; 53047-02
GPS-NEO7M: GPS-NEO7M
JP1, JP3: PINHD-1X4; 1X04
JP4: PINHD-1X16; 1X16
JP5: PINHD-1X12; 1X12
LSM6DS3: LSM6DS3; LSM6DS3_WITHOUT
L_3.3: L_3.3MKH; L_SPM5020
MP1584-3V3: MP1584-B
MP1584-5V: MP1584; MP1584-B
R1, R6, R9: 10k; R0603
R2: 100R; R0603
R5, R8: 100k; R0603
R7: 31k6; R0603
R10: 53k6; R0603
R11, R12: 2k; R0603
RADIO: E220-400T22S
S1: UNICS-SWITCHSS_12D11; SS_12D11
SI2302CDS: SI2302CDS; SOT23-3
U$1: Плата радио; LOGO
U$2, U$5: MP2225; TSOT23-8
U$3: L_3.3MKH; L_SPM5020
U$7: MOLEX-4-1.25; 53047-04
U$8: MOLEX-5-1.25; 53047-05
U$10: LIS3MDL
VALVE1, VALVE2: MOLEX-2-1.25; 53047-02
X2: AKKUM; JST-3-2.5

Connections:
3V3: C7.1, C8.2, C9.2, GPS-NEO7M.P$1 (UCC), JP5.3, LSM6DS3.P$2 (3V3), L_3.3.P$1 (1), MP1584-3V3.P$7 (OUT+), MP1584-3V3.P$8 (OUT+), R7.2, R12.2, RADIO.P$25 (VCC), U$8.5, U$10.UCC
4V: JP5.1, X2.3
5V: C14.1, C15.2, C16.2, COMPRESS.2, JP3.2, JP5.4, MP1584-5V.P$7 (OUT+), MP1584-5V.P$8 (OUT+), R10.2, R11.2, U$3.P$1 (1), U$7.3, VALVE1.2, VALVE2.2
AUX_RADIO: JP5.7, RADIO.P$24 (AUX)
BUS+: C4.2, C5.2, C11.2, C12.2, MP1584-3V3.P$1 (IN+), MP1584-3V3.P$2 (IN+), MP1584-5V.P$1 (IN+), MP1584-5V.P$2 (IN+), R5.1, R8.1, S1.2, U$2.P$2 (IN), U$5.P$2 (IN)
BUS+_OUT: S1.3 (S), X2.1
CO: JP1.1, JP4.13
CS_LIS: JP4.9, U$10.CS
CS_LSM: JP4.10, LSM6DS3.P$6 (CS)
GERMO: JP5.6, R2.1
GND: 3V3.C, 5V.C, C3.1, C4.1, C5.1, C8.1, C9.1, C10.1, C11.1, C12.1, C15.1, C16.1, GPS-NEO7M.P$4 (GND), JP3.1, JP5.2, LSM6DS3.P$3 (GND), MP1584-3V3.P$3 (IN-), MP1584-3V3.P$4 (IN-), MP1584-3V3.P$5 (OUT-), MP1584-3V3.P$6 (OUT-), MP1584-5V.P$3 (IN-), MP1584-5V.P$4 (IN-), MP1584-5V.P$5 (OUT-), MP1584-5V.P$6 (OUT-), R1.2, R6.2, R9.2, RADIO.P$2 (GND), RADIO.P$8 (GND), RADIO.P$11 (GND), RADIO.P$13 (GND), RADIO.P$14 (GND), RADIO.P$15 (GND), RADIO.P$16 (GND), RADIO.P$19 (GND), RADIO.P$26 (GND), SI2302CDS.2 (S), U$2.P$1 (AGND), U$2.P$4 (GND), U$5.P$1 (AGND), U$5.P$4 (GND), U$7.4, U$10.GND, X2.2
LATCH_SR: JP4.12, U$8.3
M0_RADIO: JP5.9, RADIO.P$20 (M0)
M1_RADIO: JP5.8, RADIO.P$21 (M1)
MICS: JP1.4, JP4.16
MISO_SENS: JP4.4, LSM6DS3.P$7 (CAO), U$10.SDO
MOSI_SENS: JP4.3, LSM6DS3.P$5 (SDA), U$10.SDA
unnamed: R1.1, R2.2, SI2302CDS.1 (G)
unnamed: COMPRESS.1, SI2302CDS.3 (D), VALVE1.1, VALVE2.1
unnamed: C3.2, U$2.P$7 (VCC)
unnamed: R5.2, U$2.P$6 (EN)
unnamed: C6.2, U$2.P$5 (BST)
unnamed: C6.1, L_3.3.P$2 (2), U$2.P$3 (SW)
unnamed: C7.2, R6.1, R7.1, U$2.P$8 (FB)
unnamed: C10.2, U$5.P$7 (VCC)
unnamed: R8.2, U$5.P$6 (EN)
unnamed: C13.2, U$5.P$5 (BST)
unnamed: C13.1, U$3.P$2 (2), U$5.P$3 (SW)
unnamed: C14.2, R9.1, R10.1, U$5.P$8 (FB)
unnamed: 5V.A, R11.1
unnamed: 3V3.A, R12.1
NH3: JP1.3, JP4.15
NO2: JP1.2, JP4.14
OE_SR: JP4.11, U$8.2
RX_GPS: GPS-NEO7M.P$3 (TX), JP5.10
RX_LIDAR: JP4.8, U$7.2
RX_RADIO: JP4.6, RADIO.P$23 (TXD)
SCK_SENS: JP5.12, LSM6DS3.P$4 (SCL), U$8.4, U$10.SCL
SCL: JP3.4, JP4.2
SDA: JP3.3, JP4.1
SHIFT: JP5.5, U$8.1
TX_GPS: GPS-NEO7M.P$2 (RX), JP5.11
TX_LIDAR: JP4.7, U$7.1
TX_RADIO: JP4.5, RADIO.P$22 (RXD)

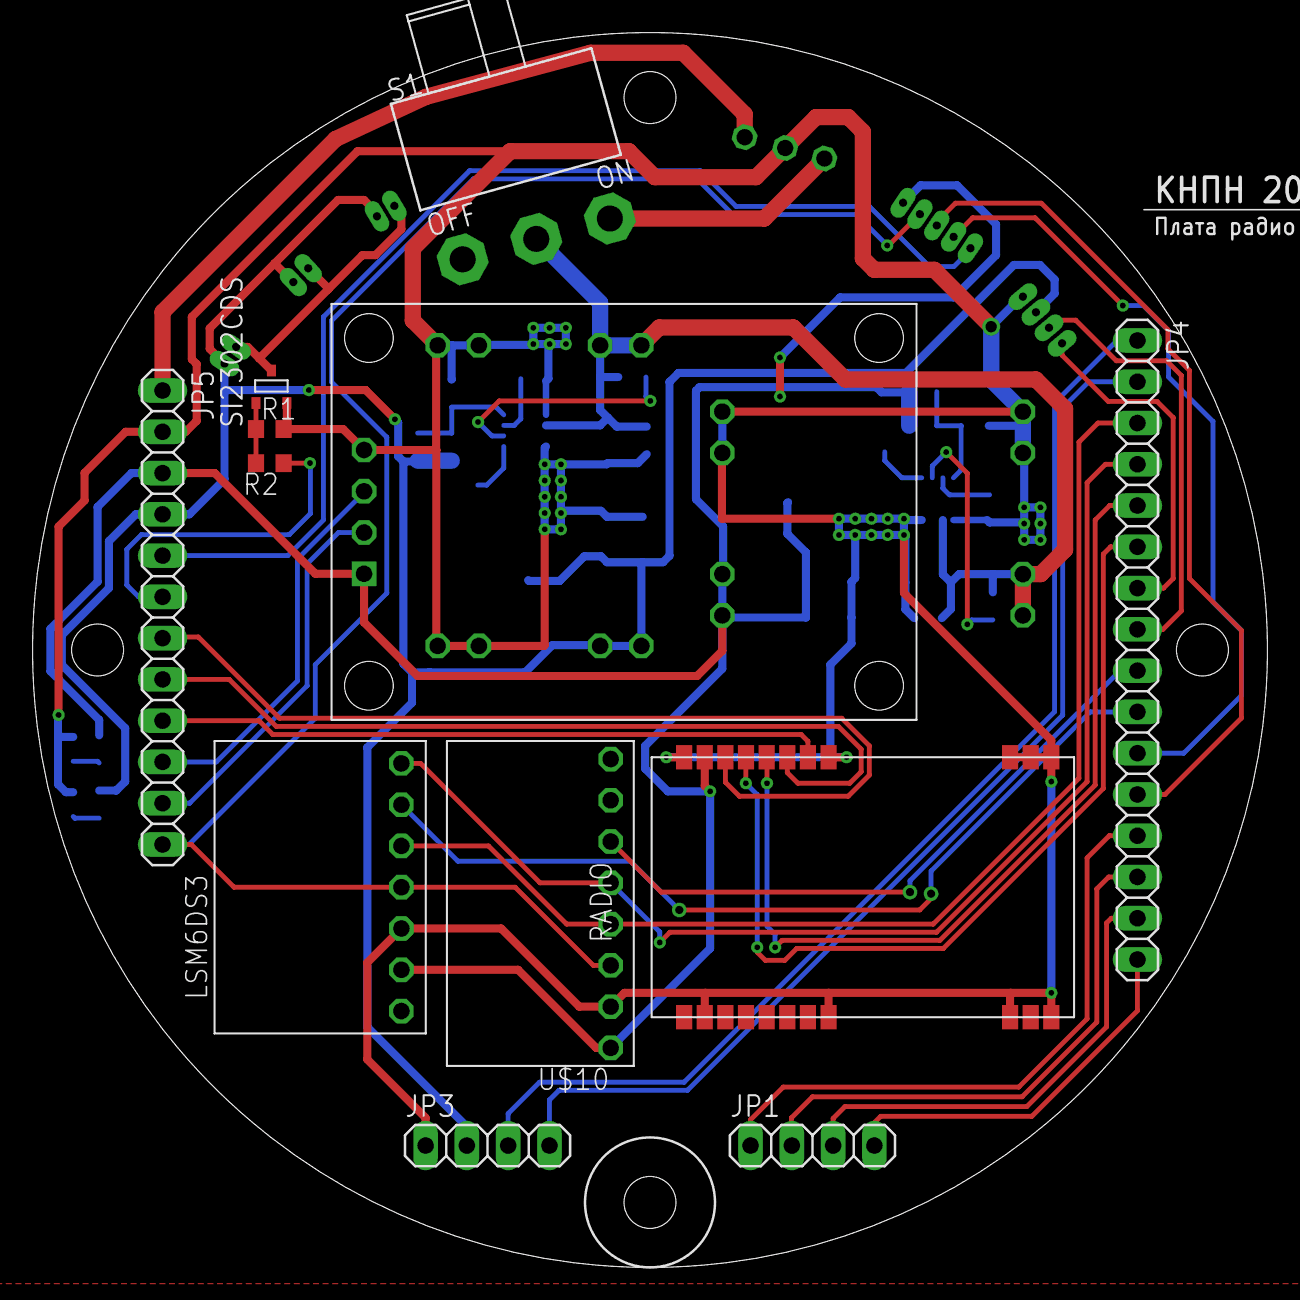
[picture p65: board RADIO.brd from above]

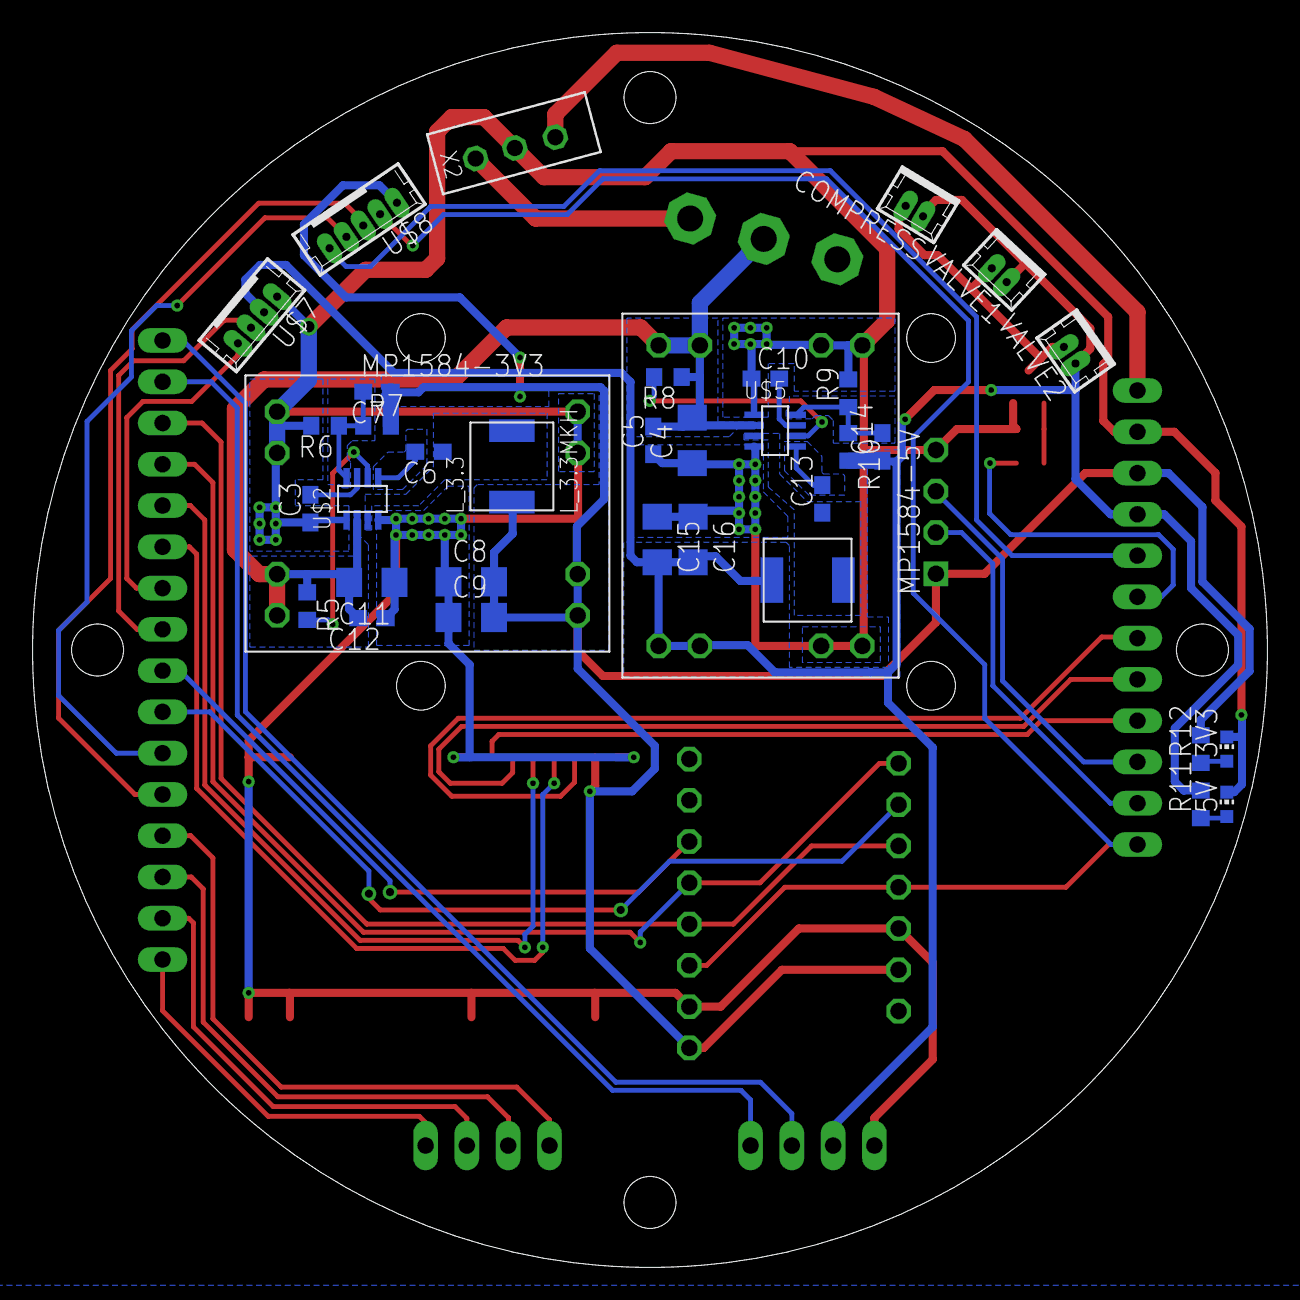
[picture p66: board RADIO.brd from below]

Board: 2 copper layers, 76.0 x 76.0 mm, 49 parts (36 on the bottom side), 44 nets.
