cansat-tsniimash/KNPN-2025/schematics/board/MK.brd

## EAGLE design schematics/board/MK.brd (2025-03-26)

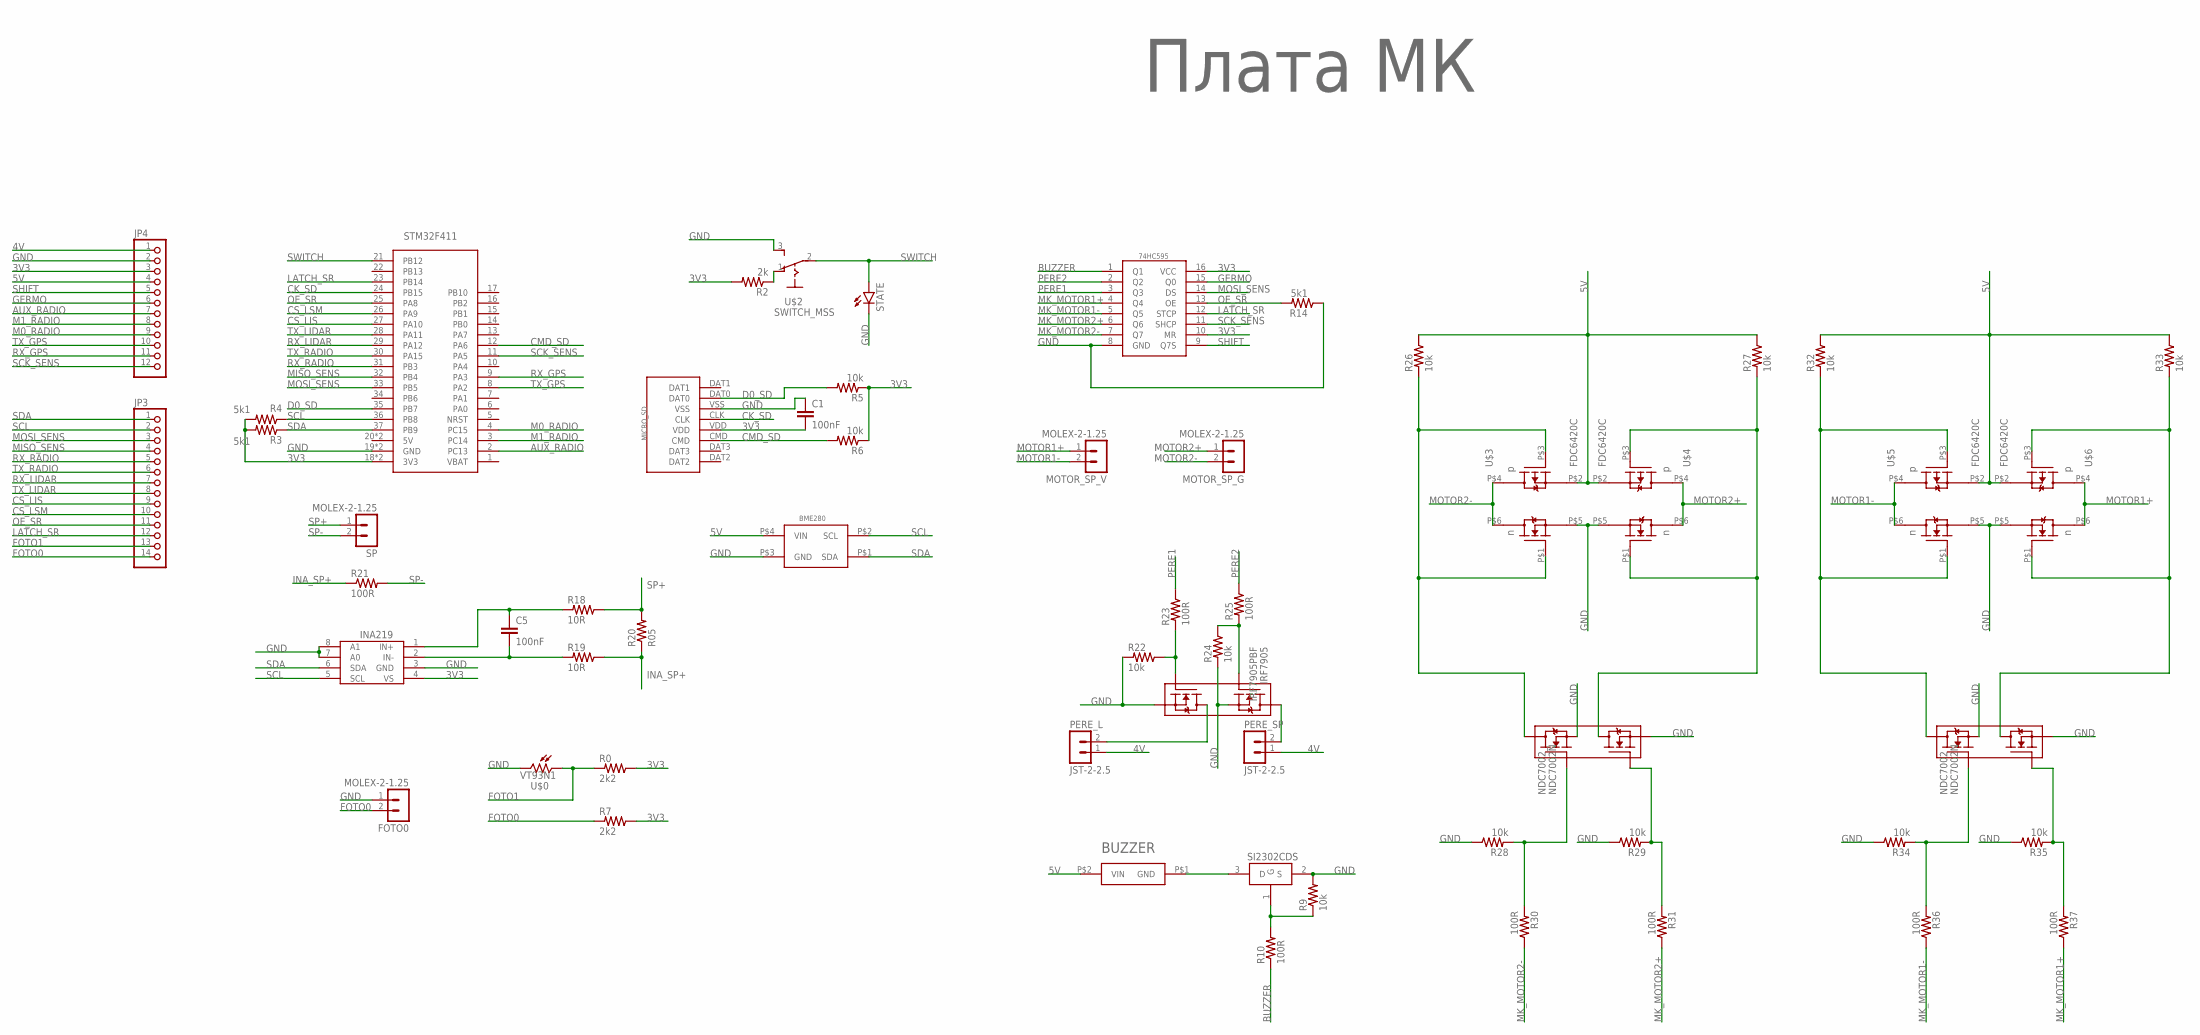
[picture p67: schematic MK.sch]

Parts:
74HC595: 74HC595; TSSOP16
BME280: BME280BME280-PINS-ONLY; BME280-PINS-ONLY
BUZZER: BUZZERS8R6; BUZZER-S8R12
C1, C5: 100nF; C0603
FOTO0: MOLEX-2-1.25; 53047-02
INA: INA219AID; SOT23-8
IRF7905: IRF7905PBF; SO8
JP3: PINHD-1X14; 1X14
JP4: PINHD-1X12; 1X12
MICRO_SD: SD
MOTOR_SP_G: MOLEX-2-1.25; 53047-02
MOTOR_SP_V: MOLEX-2-1.25; 53047-02
NDC7002, NDC7002_: NDC7002N; SOT23-6
PERE_L: JST-2-2.5
PERE_SP: JST-2-2.5
R0, R7: 2k2; R0603
R2: 2k; R0603
R3, R4, R14: 5k1; R0603
R5, R6, R9, R22, R24, R26, R27, R28, R29, R32, R33, R34, R35: 10k; R0603
R10, R23, R25, R30, R31, R36, R37: 100R; R0603
R18, R19: 10R; R0603
R20: R05; R2512
R21: 100R; 0207/15
SI2302: SI2302CDS; SOT23-3
SP: MOLEX-2-1.25; 53047-02
STATE: LEDCHIPLED_0603; CHIPLED_0603
STM32F411: STM32F411_BOARD
U$0: VT93N1
U$1: Плата МК; LOGO
U$2: SWITCH_MSS
U$3, U$4, U$5, U$6: FDC6420C; TSOP-6

Connections:
3V3: 74HC595.10 (MR), 74HC595.16 (VCC), C1.2, INA.4 (VS), JP4.3, MICRO_SD.VDD, R0.1, R2.2, R3.2, R4.2, R5.1, R6.1, R7.1, STM32F411.18 (3V3), STM32F411.40 (3V3)
4V: JP4.1, PERE_L.1, PERE_SP.1
5V: BME280.P$4 (VIN), BUZZER.P$2 (VIN), JP4.4, R26.1, R27.1, R32.1, R33.1, U$3.P$2 (PS), U$4.P$2 (PS), U$5.P$2 (PS), U$6.P$2 (PS)
AUX_RADIO: JP4.7, STM32F411.2 (PC13)
BUZZER: 74HC595.1 (Q1), R10.1
CK_SD: MICRO_SD.CLK, STM32F411.24 (PB15)
CMD_SD: MICRO_SD.CMD, R6.2, STM32F411.12 (PA6)
CS_LIS: JP3.9, STM32F411.27 (PA10)
CS_LSM: JP3.10, STM32F411.26 (PA9)
D0_SD: MICRO_SD.DAT0, R5.2, STM32F411.35 (PB7)
FOTO0: FOTO0.2, JP3.14, R7.2
FOTO1: JP3.13, R0.2, U$0.P$1 (1)
GERMO: 74HC595.15 (Q0), JP4.6
GND: 74HC595.8 (GND), BME280.P$3 (GND), C1.1, FOTO0.1, INA.3 (GND), INA.7 (A0), INA.8 (A1), IRF7905.1 (S2), IRF7905.3 (S1), JP4.2, MICRO_SD.VSS, NDC7002.2 (S2), NDC7002.5 (S1), NDC7002_.2 (S2), NDC7002_.5 (S1), R9.2, R14.1, R22.2, R24.2, R28.1, R29.1, R34.1, R35.1, SI2302.2 (S), STATE.C, STM32F411.19 (GND), STM32F411.39 (GND), U$0.P$2 (2), U$2.3 (S), U$3.P$5 (NS), U$4.P$5 (NS), U$5.P$5 (NS), U$6.P$5 (NS)
INA_SP+: R19.1, R20.1, R21.1
LATCH_SR: 74HC595.12 (STCP), JP3.12, STM32F411.23 (PB14)
M0_RADIO: JP4.9, STM32F411.4 (PC15)
M1_RADIO: JP4.8, STM32F411.3 (PC14)
MISO_SENS: JP3.4, STM32F411.32 (PB4)
MK_MOTOR1+: 74HC595.4 (Q4), R37.1
MK_MOTOR1-: 74HC595.5 (Q5), R36.1
MK_MOTOR2+: 74HC595.6 (Q6), R31.1
MK_MOTOR2-: 74HC595.7 (Q7), R30.1
MOSI_SENS: 74HC595.14 (DS), JP3.3, STM32F411.33 (PB5)
MOTOR1+: MOTOR_SP_V.1, U$6.P$4 (PD), U$6.P$6 (ND)
MOTOR1-: MOTOR_SP_V.2, U$5.P$4 (PD), U$5.P$6 (ND)
MOTOR2+: MOTOR_SP_G.1, U$4.P$4 (PD), U$4.P$6 (ND)
MOTOR2-: MOTOR_SP_G.2, U$3.P$4 (PD), U$3.P$6 (ND)
unnamed: R2.1, U$2.1 (O)
unnamed: BUZZER.P$1 (GND), SI2302.3 (D)
unnamed: R9.1, R10.2, SI2302.1 (G)
unnamed: C5.2, INA.2 (IN-), R19.2
unnamed: C5.1, INA.1 (IN+), R18.2
unnamed: IRF7905.7 (D2), IRF7905.8 (D2), PERE_L.2
unnamed: IRF7905.5 (D1), IRF7905.6 (D1), PERE_SP.2
unnamed: IRF7905.2 (G2), R22.1, R23.2
unnamed: IRF7905.4 (G1), R24.1, R25.2
unnamed: NDC7002.6 (D1), R32.2, U$5.P$1 (NG), U$5.P$3 (PG)
unnamed: NDC7002_.6 (D1), R26.2, U$3.P$1 (NG), U$3.P$3 (PG)
unnamed: NDC7002_.4 (D2), R27.2, U$4.P$1 (NG), U$4.P$3 (PG)
unnamed: NDC7002.4 (D2), R33.2, U$6.P$1 (NG), U$6.P$3 (PG)
unnamed: NDC7002.1 (G1), R34.2, R36.2
unnamed: NDC7002.3 (G2), R35.2, R37.2
unnamed: NDC7002_.1 (G1), R28.2, R30.2
unnamed: NDC7002_.3 (G2), R29.2, R31.2
OE_SR: 74HC595.13 (OE), JP3.11, R14.2, STM32F411.25 (PA8)
PERE1: 74HC595.3 (Q3), R23.1
PERE2: 74HC595.2 (Q2), R25.1
RX_GPS: JP4.11, STM32F411.9 (PA3)
RX_LIDAR: JP3.7, STM32F411.29 (PA12)
RX_RADIO: JP3.5, STM32F411.31 (PB3)
SCK_SENS: 74HC595.11 (SHCP), JP4.12, STM32F411.11 (PA5)
SCL: BME280.P$2 (SCL), INA.5 (SCL), JP3.2, R4.1, STM32F411.36 (PB8)
SDA: BME280.P$1 (SDA), INA.6 (SDA), JP3.1, R3.1, STM32F411.37 (PB9)
SHIFT: 74HC595.9 (Q7S), JP4.5
SP+: R18.1, R20.2, SP.1
SP-: R21.2, SP.2
SWITCH: STATE.A, STM32F411.21 (PB12), U$2.2
TX_GPS: JP4.10, STM32F411.8 (PA2)
TX_LIDAR: JP3.8, STM32F411.28 (PA11)
TX_RADIO: JP3.6, STM32F411.30 (PA15)

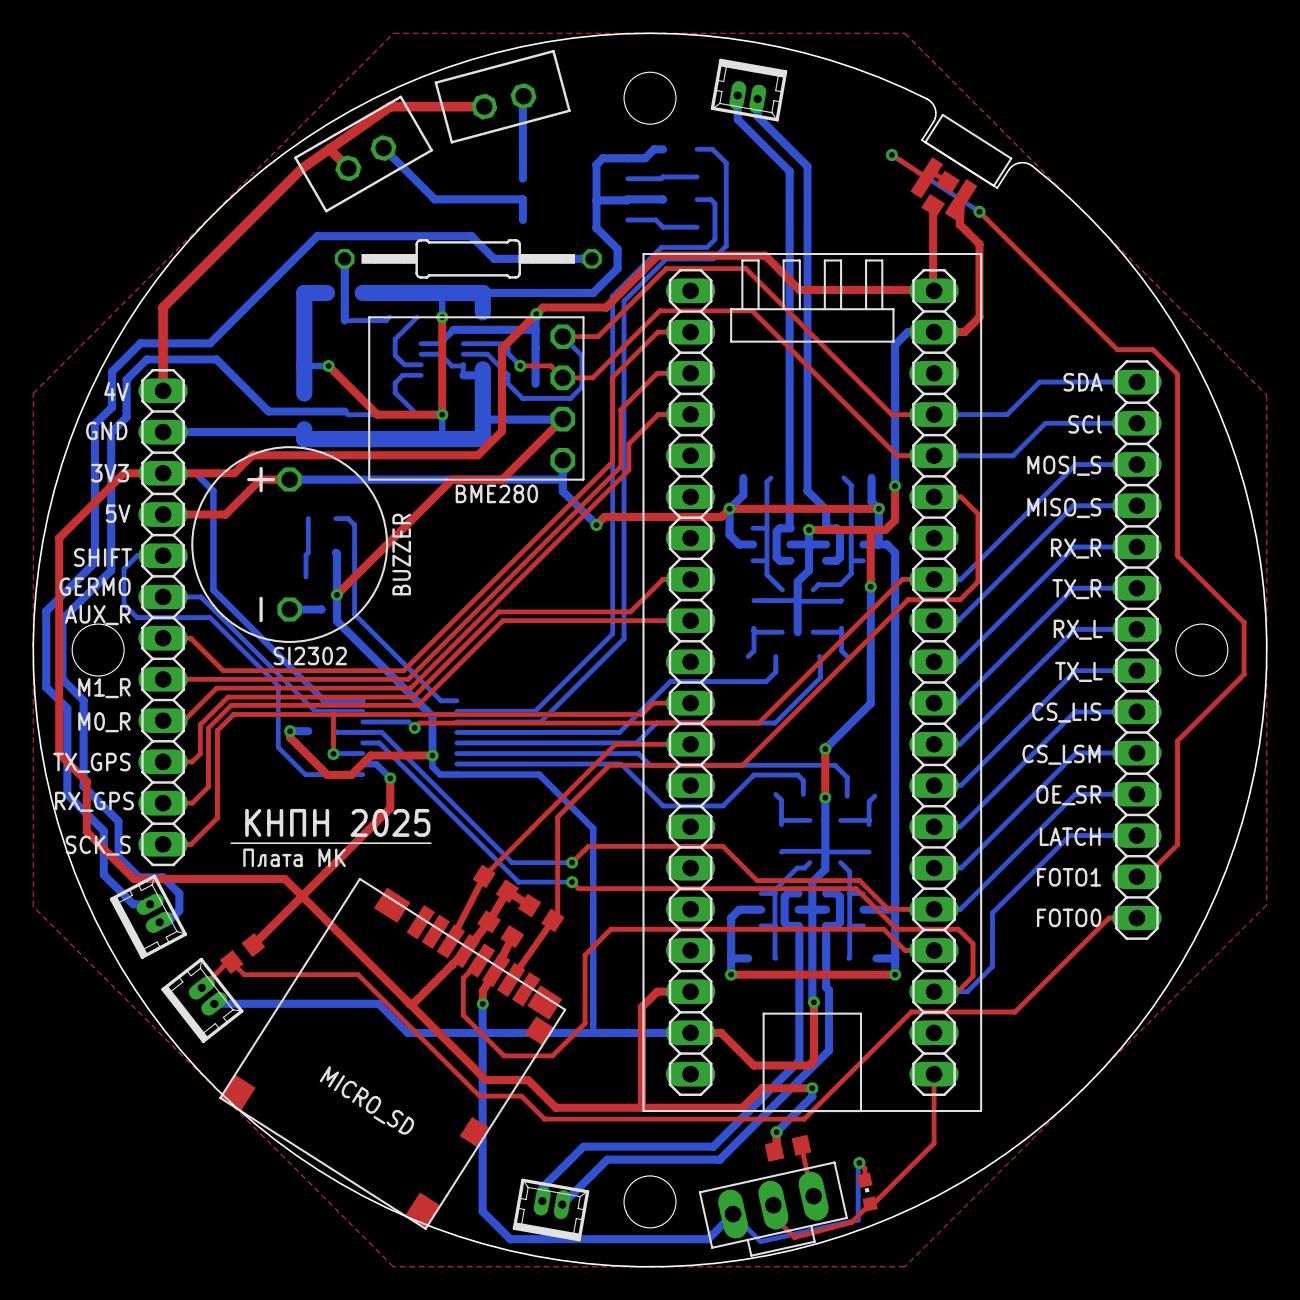
[picture p68: board schematics/board/MK.brd from above]

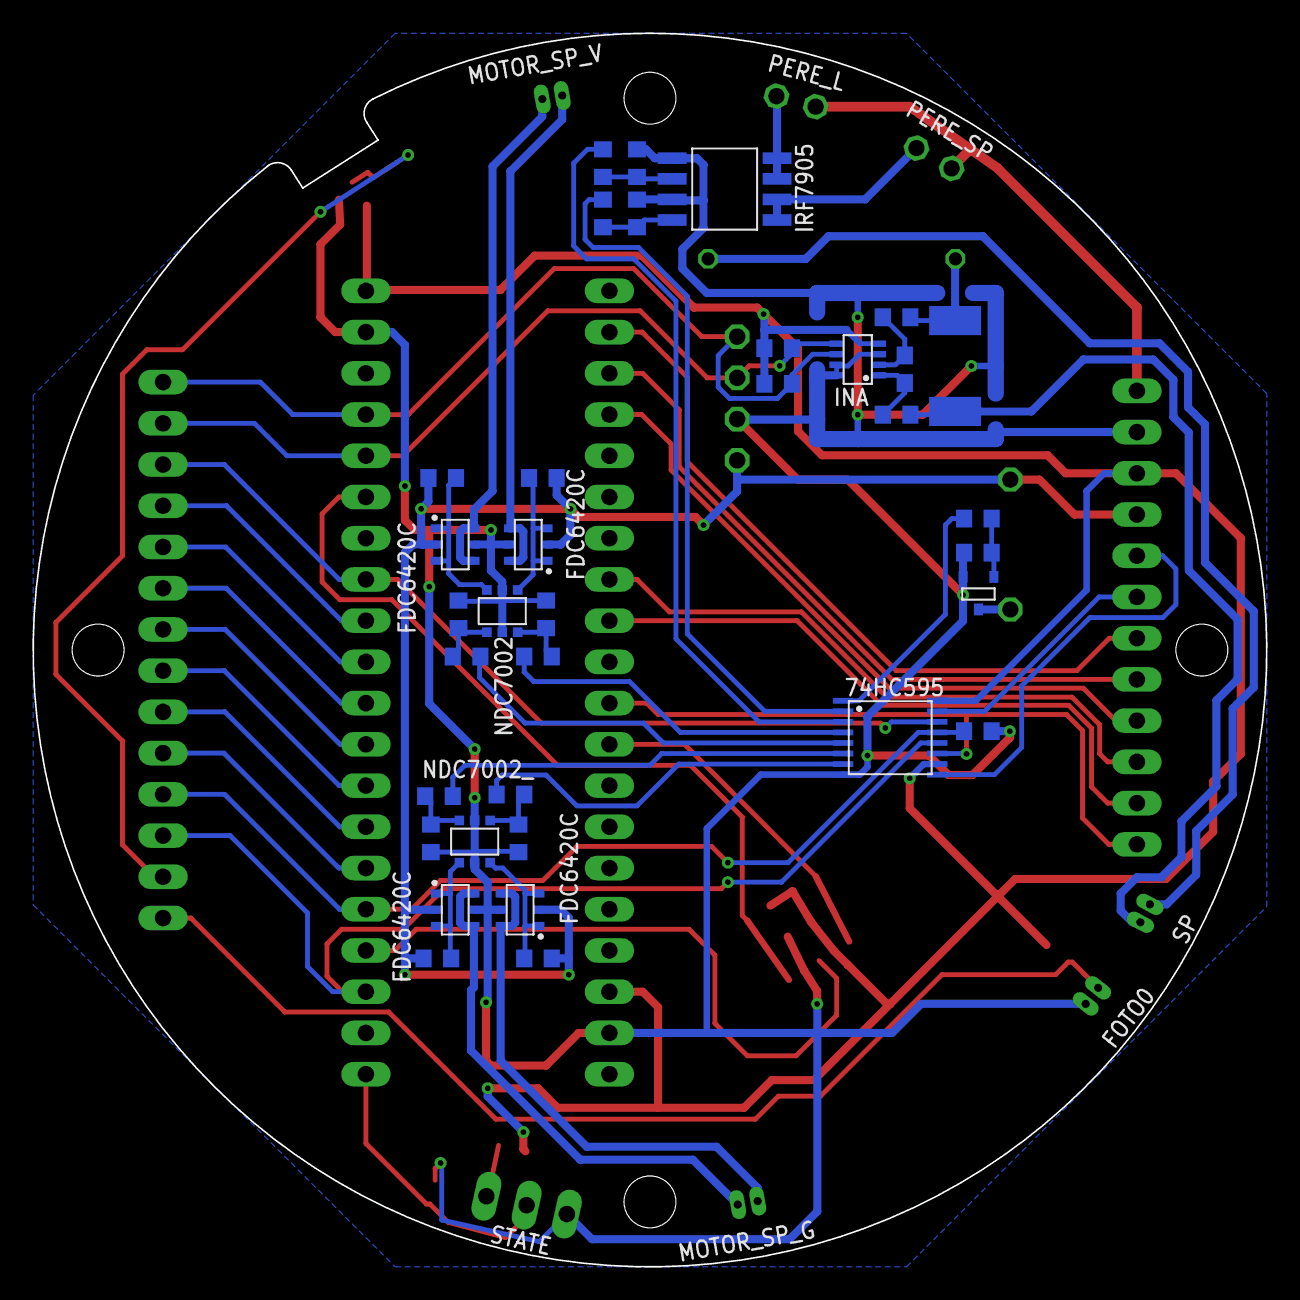
[picture p69: board schematics/board/MK.brd from below]

Board: 2 copper layers, 76.0 x 76.0 mm, 58 parts (35 on the bottom side), 61 nets.
