cansat-tsniimash/KNPN-2025/schematics/resisdelit.brd

## EAGLE design schematics/resisdelit.brd (2025-03-11)

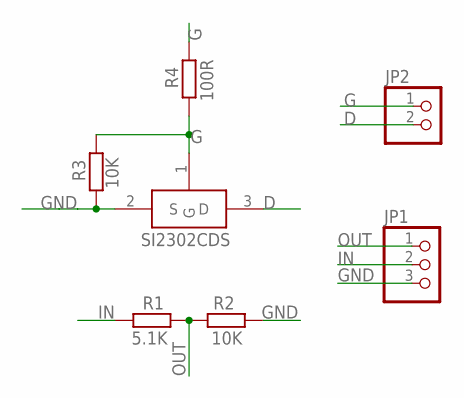
[picture p70: schematic resisdelit.sch]

Parts:
JP1: PINHD-1X3; 1X03
JP2: PINHD-1X2; 1X02
R1: 5.1K; R0603
R2, R3: 10K; R0603
R4: 100R; R0603
SI2300A: SI2302CDS; SOT23-3

Connections:
D: JP2.2, SI2300A.3 (D)
G: JP2.1, R3.2, R4.1, R4.2, SI2300A.1 (G)
GND: JP1.3, R2.2, R3.1, SI2300A.2 (S)
IN: JP1.2, R1.1
OUT: JP1.1, R1.2, R2.1

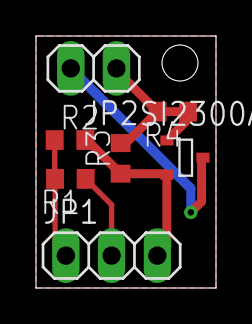
[picture p71: board resisdelit.brd from above]

Board: 2 copper layers, 10.0 x 14.0 mm, 7 parts (0 on the bottom side), 5 nets.
