cansat-tsniimash/KNPN-2025/schematics/shema.brd

## EAGLE design schematics/shema.brd (2025-03-11)

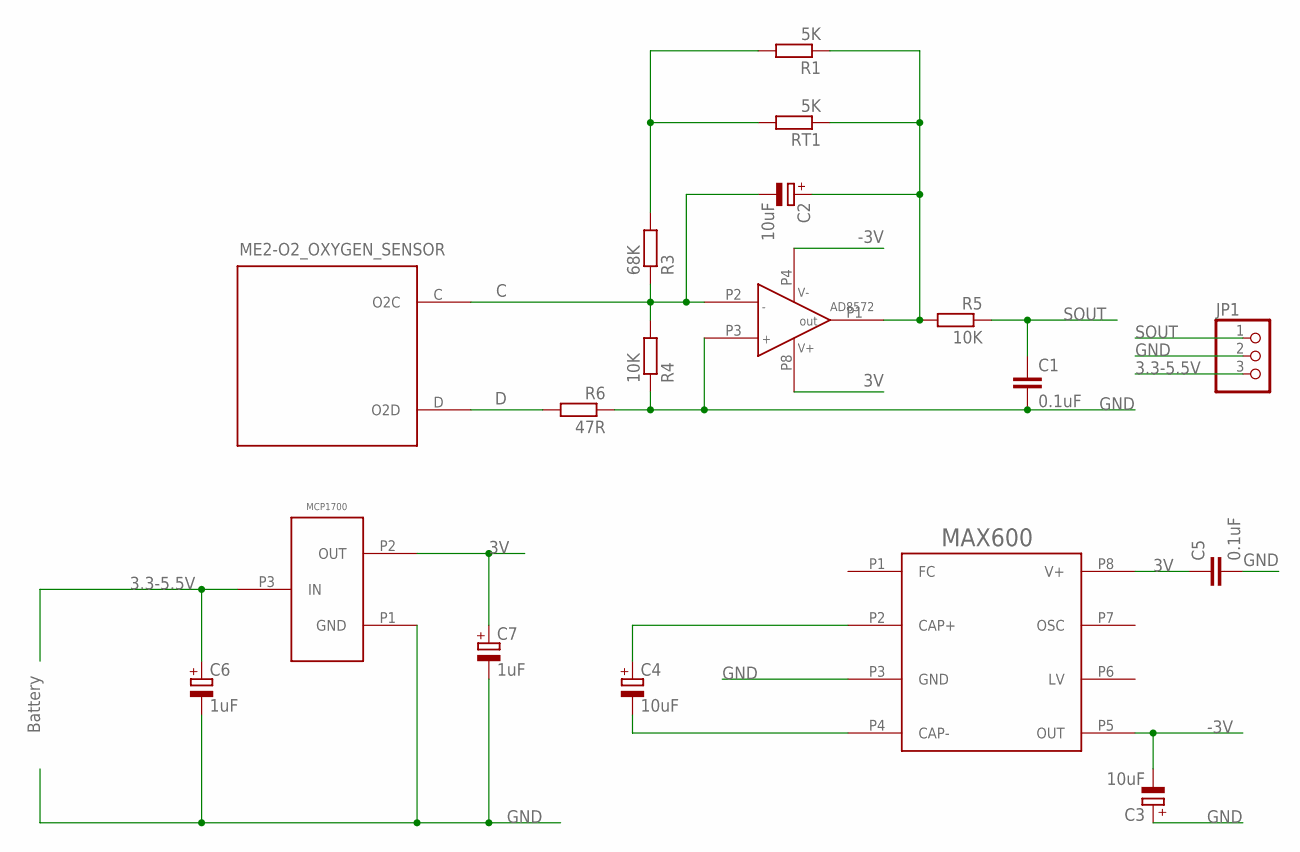
[picture p72: schematic shema.sch]

Parts:
AD8572: AD8572
C1, C5: 0.1uF; C0603
C2, C3, C4: 10uF; 153CLV-0405
C6, C7: 1uF; 153CLV-0405
JP1: PINHD-1X3; 1X03
MAX600: MAX660
MCP1700: MCP1700
ME2-O2_OXYGEN_SENSOR: ME2-O2_OXYGEN_SENSOR
R1: 5K; R0603
R3: 68K; R0603
R4, R5: 10K; R0603
R6: 47R; R0603
RT1: 5K; R0603

Connections:
3.3-5.5V: C6.+, JP1.3, MCP1700.P3 (IN)
3V: AD8572.P8 (V+), C5.1, C7.+, MAX600.P8 (V+), MCP1700.P2 (OUT)
-3V: AD8572.P4 (V-), C3.-, MAX600.P5 (OUT)
C: AD8572.P2 (-IN), C2.-, ME2-O2_OXYGEN_SENSOR.C (O2C), R3.1, R4.2
D: ME2-O2_OXYGEN_SENSOR.D (O2D), R6.2
GND: AD8572.P3 (+IN), C1.2, C3.+, C5.2, C6.-, C7.-, JP1.2, MAX600.P3 (GND), MCP1700.P1 (GND), R4.1, R6.1
unnamed: AD8572.P1 (OUT), C2.+, R1.1, R5.2, RT1.1
unnamed: R1.2, R3.2, RT1.2
unnamed: C4.+, MAX600.P2 (CAP+)
unnamed: C4.-, MAX600.P4 (CAP-)
SOUT: C1.1, JP1.1, R5.1

Notes on the sheet:
Battery

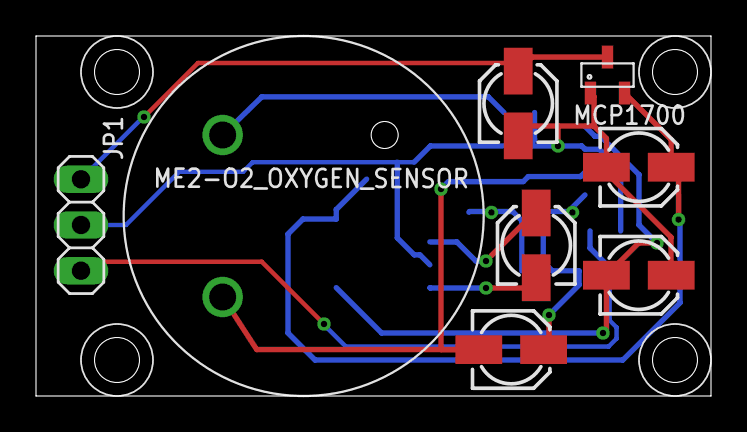
[picture p73: board shema.brd from above]

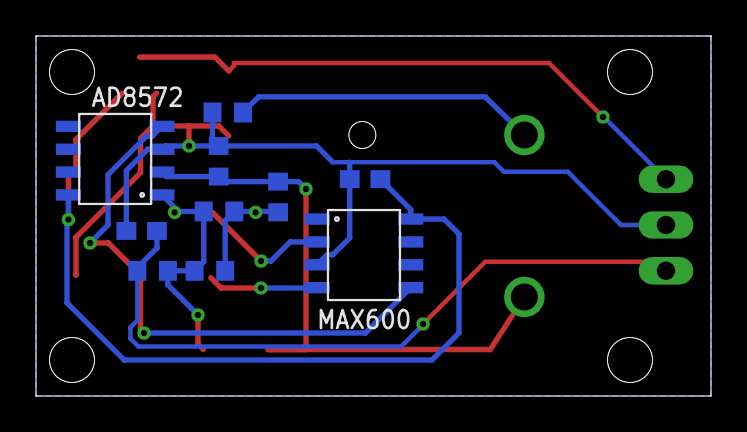
[picture p74: board shema.brd from below]

Board: 2 copper layers, 37.5 x 20.0 mm, 18 parts (10 on the bottom side), 11 nets.
