cansat-tsniimash/KNPN-2025/schematics/board/MOTOR.brd

## EAGLE design schematics/board/MOTOR.brd (2025-03-11)

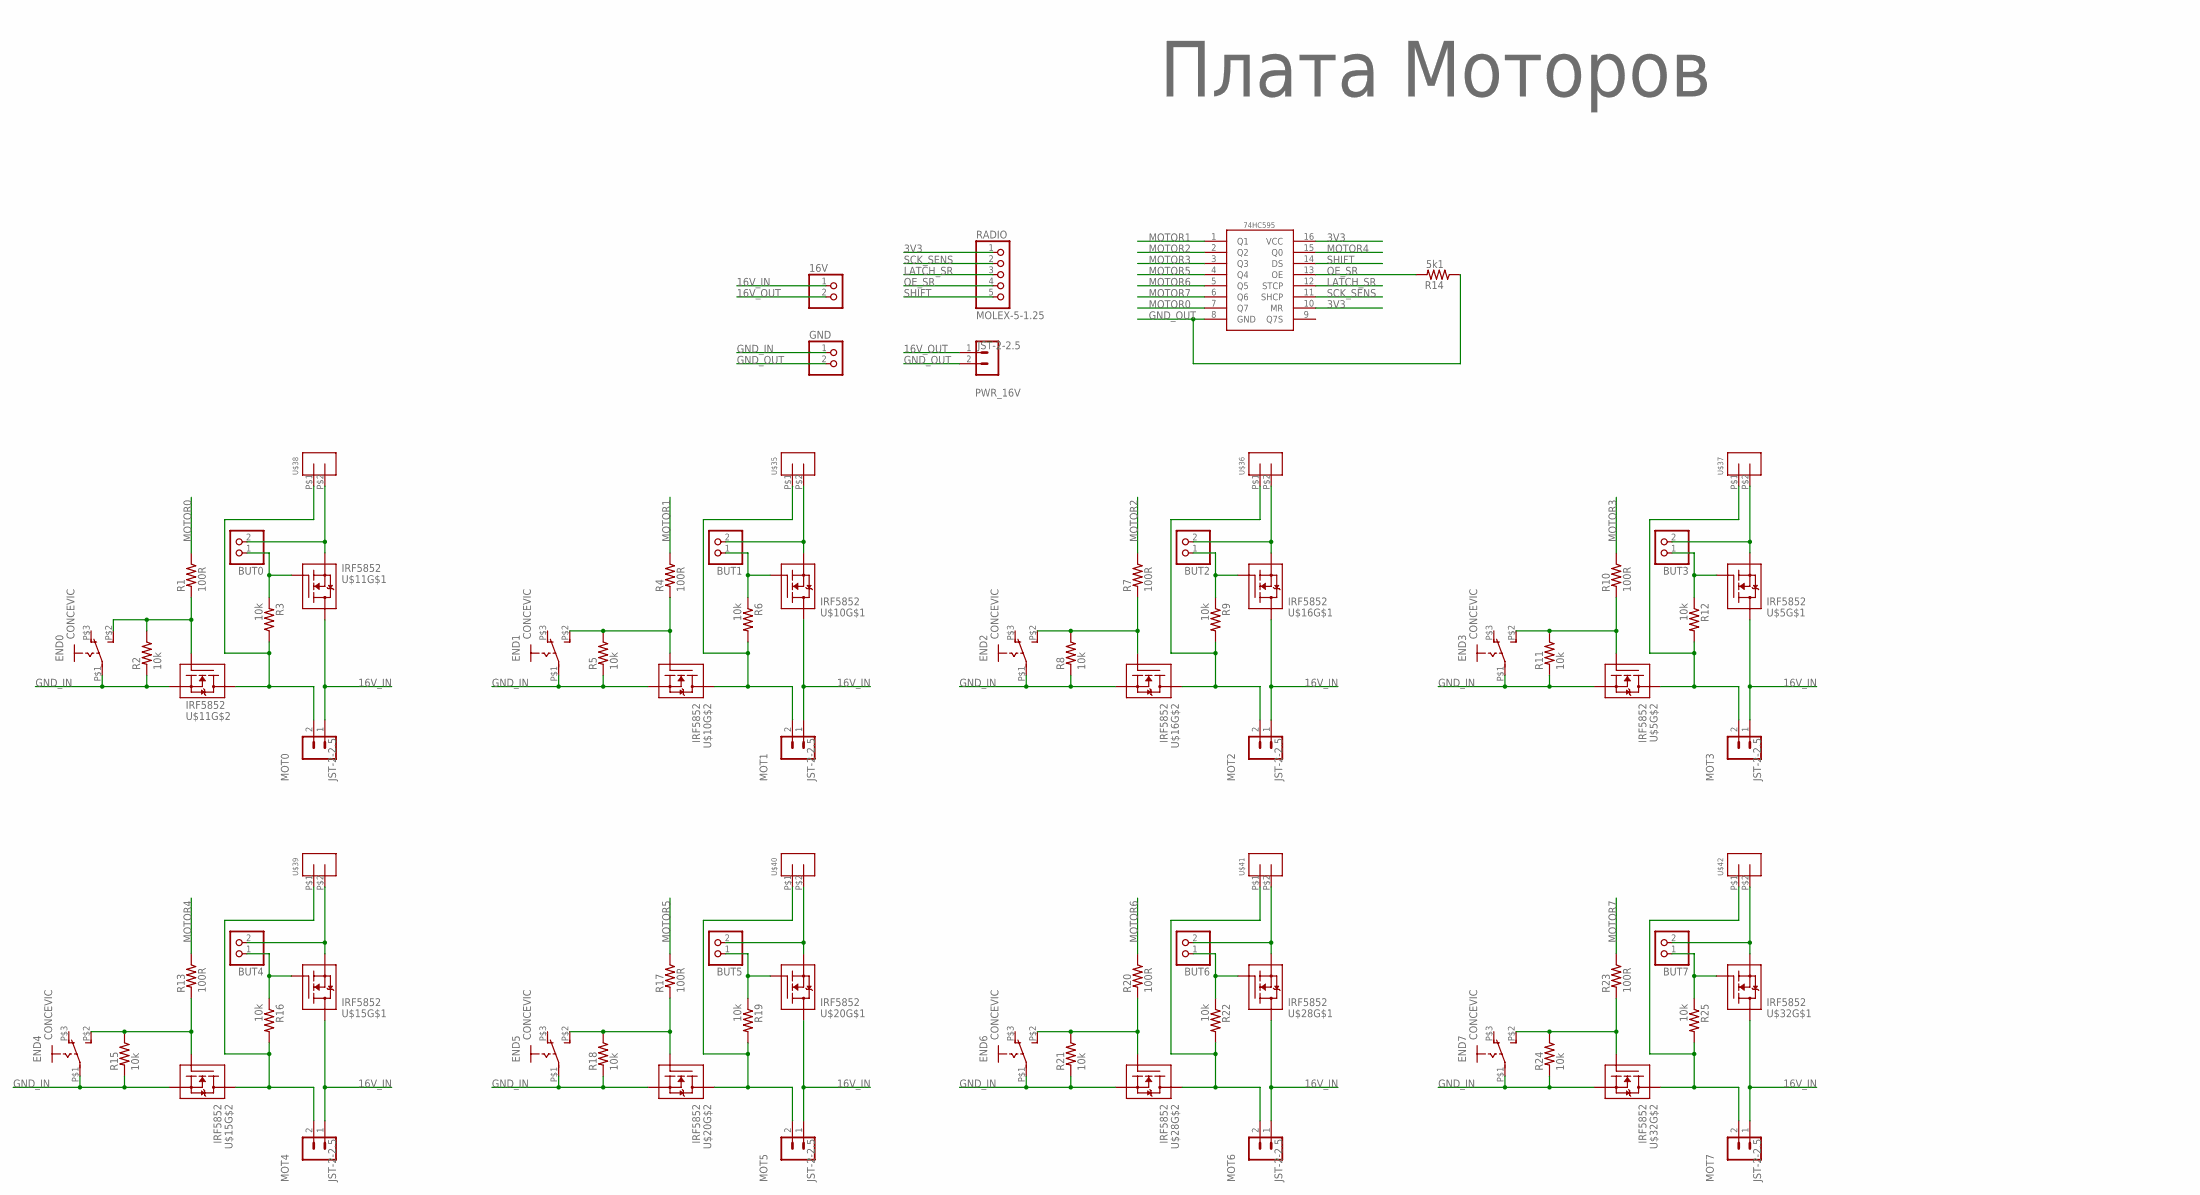
[picture p75: schematic MOTOR.sch]

Parts:
16V: PINHD-1X2/90; 1X02/90
74HC595: 74HC595; TSSOP16
BUT0, BUT1, BUT2, BUT3, BUT4, BUT5, BUT6, BUT7: PINHD-1X2; 1X02
END0, END1, END2, END3, END4, END5, END6, END7: CONCEVIC
GND: PINHD-1X2/90; 1X02/90
MOT0, MOT1, MOT2, MOT3, MOT4, MOT5, MOT6, MOT7: JST-2-2.5
PWR_16V: JST-2-2.5
R1, R4, R7, R10, R13, R17, R20, R23: 100R; R0603
R2, R3, R5, R6, R8, R9, R11, R12, R15, R16, R18, R19, R21, R22, R24, R25: 10k; R0603
R14: 5k1; R0603
RADIO: MOLEX-5-1.25; 53047-05
U$5, U$10, U$11, U$15, U$16, U$20, U$28, U$32: IRF5852; TSOP-6
U$9: Плата Моторов; LOGO
U$35, U$36, U$37, U$38, U$39, U$40, U$41, U$42: CONTACT_SIDE_4MM_2PIN

Connections:
3V3: 74HC595.10 (MR), 74HC595.16 (VCC), RADIO.1
16V_IN: 16V.1, MOT0.1, MOT1.1, MOT2.1, MOT3.1, MOT4.1, MOT5.1, MOT6.1, MOT7.1, U$5.P$6 (D1), U$10.P$6 (D1), U$11.P$6 (D1), U$15.P$6 (D1), U$16.P$6 (D1), U$20.P$6 (D1), U$28.P$6 (D1), U$32.P$6 (D1)
16V_OUT: 16V.2, PWR_16V.1
GND_IN: END0.P$1, END1.P$1, END2.P$1, END3.P$1, END4.P$1, END5.P$1, END6.P$1, END7.P$1, GND.1, R2.2, R5.2, R8.2, R11.2, R15.2, R18.2, R21.2, R24.2, U$5.P$2 (S1), U$10.P$2 (S1), U$11.P$2 (S1), U$15.P$2 (S1), U$16.P$2 (S1), U$20.P$2 (S1), U$28.P$2 (S1), U$32.P$2 (S1)
GND_OUT: 74HC595.8 (GND), GND.2, PWR_16V.2, R14.1
LATCH_SR: 74HC595.12 (STCP), RADIO.3
MOTOR0: 74HC595.7 (Q7), R1.1
MOTOR1: 74HC595.1 (Q1), R4.1
MOTOR2: 74HC595.2 (Q2), R7.1
MOTOR3: 74HC595.3 (Q3), R10.1
MOTOR4: 74HC595.15 (Q0), R13.1
MOTOR5: 74HC595.4 (Q4), R17.1
MOTOR6: 74HC595.5 (Q5), R20.1
MOTOR7: 74HC595.6 (Q6), R23.1
unnamed: MOT0.2, R3.1, U$11.P$4 (D1), U$38.P$1
unnamed: MOT1.2, R6.2, U$10.P$4 (D1), U$35.P$1
unnamed: END1.P$2 (S), R4.2, R5.1, U$10.P$3 (G1)
unnamed: END0.P$2 (S), R1.2, R2.1, U$11.P$3 (G1)
unnamed: BUT1.2, U$10.P$5 (S1), U$35.P$2
unnamed: BUT0.1, R3.2, U$11.P$1 (G1)
unnamed: BUT1.1, R6.1, U$10.P$1 (G1)
unnamed: BUT0.2, U$11.P$5 (S1), U$38.P$2
unnamed: MOT2.2, R9.2, U$16.P$4 (D1), U$36.P$1
unnamed: BUT2.2, U$16.P$5 (S1), U$36.P$2
unnamed: END3.P$2 (S), R10.2, R11.1, U$5.P$3 (G1)
unnamed: END2.P$2 (S), R7.2, R8.1, U$16.P$3 (G1)
unnamed: BUT2.1, R9.1, U$16.P$1 (G1)
unnamed: MOT3.2, R12.2, U$5.P$4 (D1), U$37.P$1
unnamed: BUT3.2, U$5.P$5 (S1), U$37.P$2
unnamed: BUT3.1, R12.1, U$5.P$1 (G1)
unnamed: END4.P$2 (S), R13.2, R15.1, U$15.P$3 (G1)
unnamed: MOT4.2, R16.2, U$15.P$4 (D1), U$39.P$1
unnamed: BUT4.2, U$15.P$5 (S1), U$39.P$2
unnamed: BUT4.1, R16.1, U$15.P$1 (G1)
unnamed: END5.P$2 (S), R17.2, R18.1, U$20.P$3 (G1)
unnamed: MOT5.2, R19.2, U$20.P$4 (D1), U$40.P$1
unnamed: BUT5.2, U$20.P$5 (S1), U$40.P$2
unnamed: BUT5.1, R19.1, U$20.P$1 (G1)
unnamed: END6.P$2 (S), R20.2, R21.1, U$28.P$3 (G1)
unnamed: MOT6.2, R22.2, U$28.P$4 (D1), U$41.P$1
unnamed: BUT6.2, U$28.P$5 (S1), U$41.P$2
unnamed: BUT6.1, R22.1, U$28.P$1 (G1)
unnamed: END7.P$2 (S), R23.2, R24.1, U$32.P$3 (G1)
unnamed: MOT7.2, R25.2, U$32.P$4 (D1), U$42.P$1
unnamed: BUT7.2, U$32.P$5 (S1), U$42.P$2
unnamed: BUT7.1, R25.1, U$32.P$1 (G1)
OE_SR: 74HC595.13 (OE), R14.2, RADIO.4
SCK_SENS: 74HC595.11 (SHCP), RADIO.2
SHIFT: 74HC595.14 (DS), RADIO.5
