cansat-tsniimash/KNPN-2025/schematics/board/MOTOR.brd

## EAGLE design schematics/board/MOTOR.brd (continued)

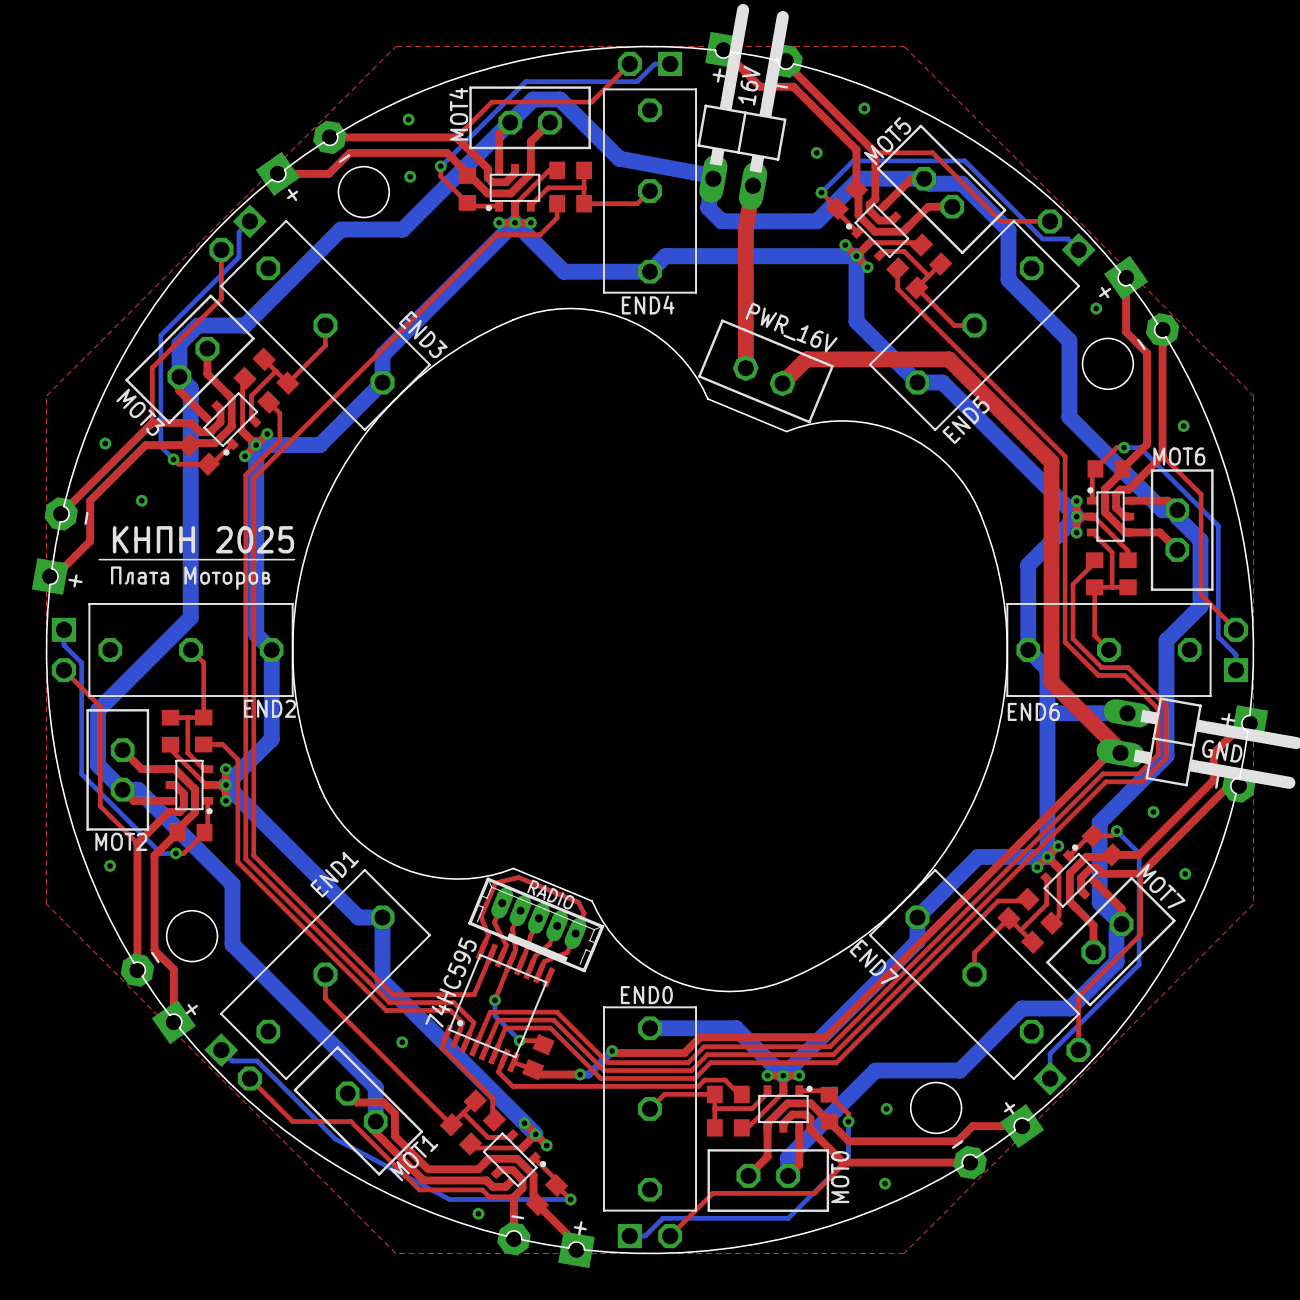
[picture p76: board MOTOR.brd from above]

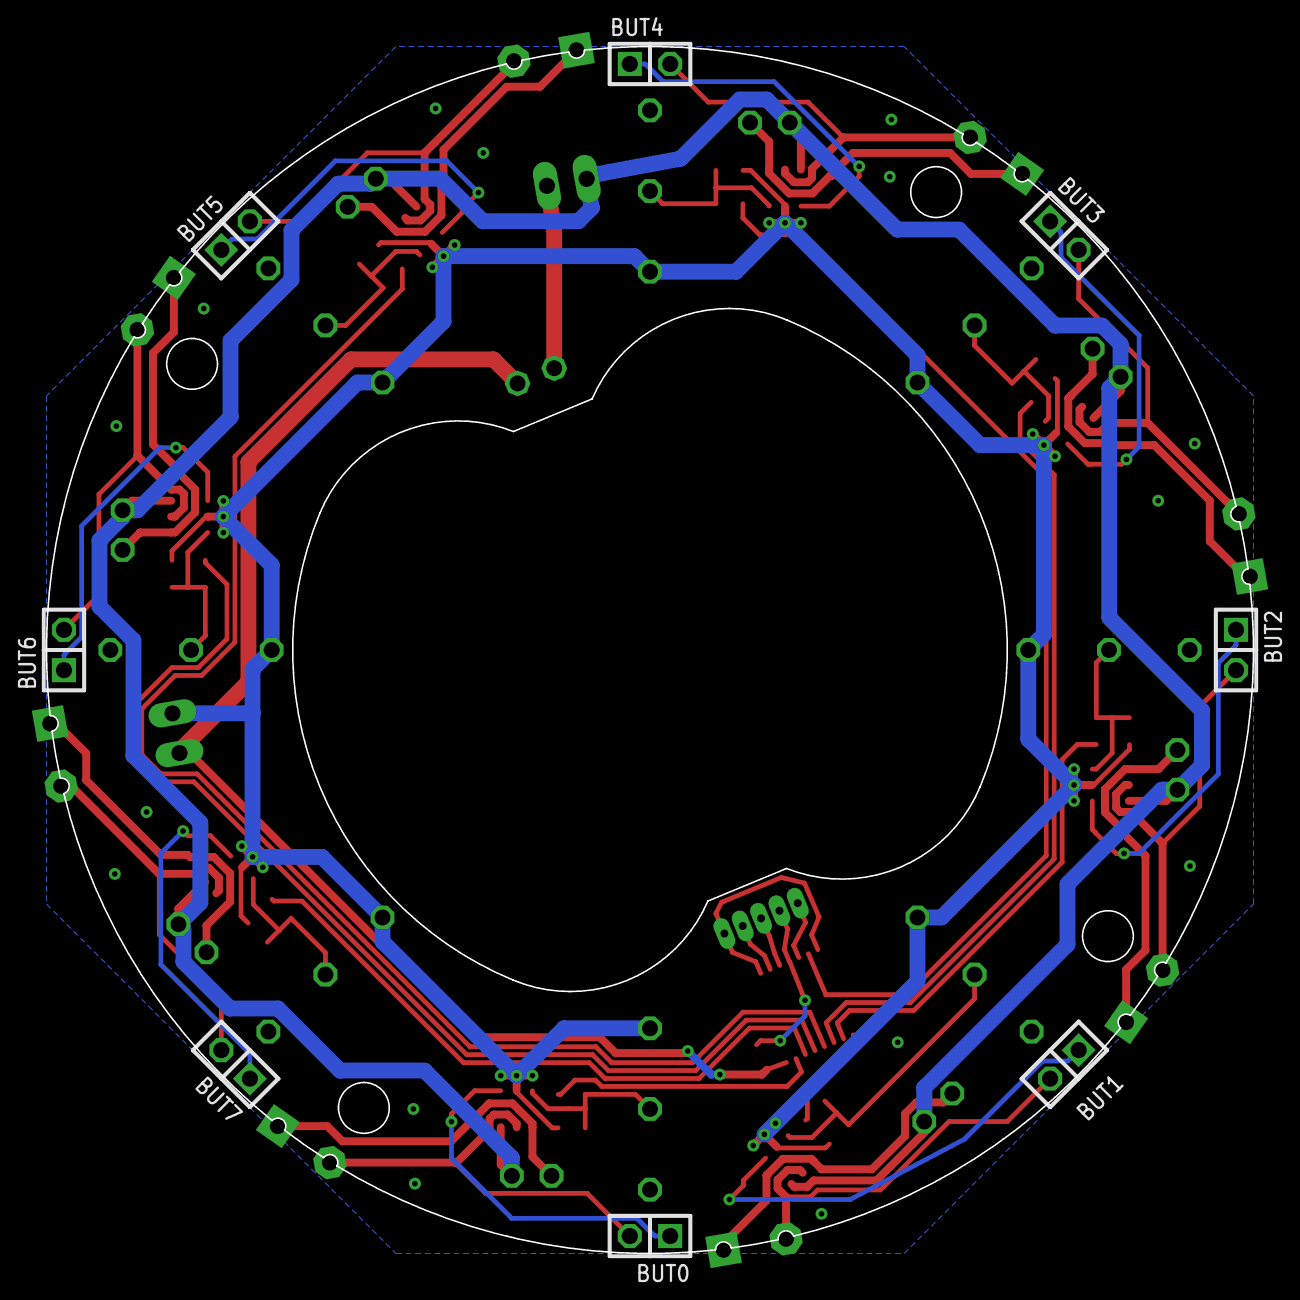
[picture p77: board MOTOR.brd from below]

Board: 2 copper layers, 76.0 x 76.0 mm, 71 parts (8 on the bottom side), 49 nets.
