cansat-tsniimash/KNPN-2025/schematics/board/SP.brd

## EAGLE design schematics/board/SP.brd (2025-03-10)

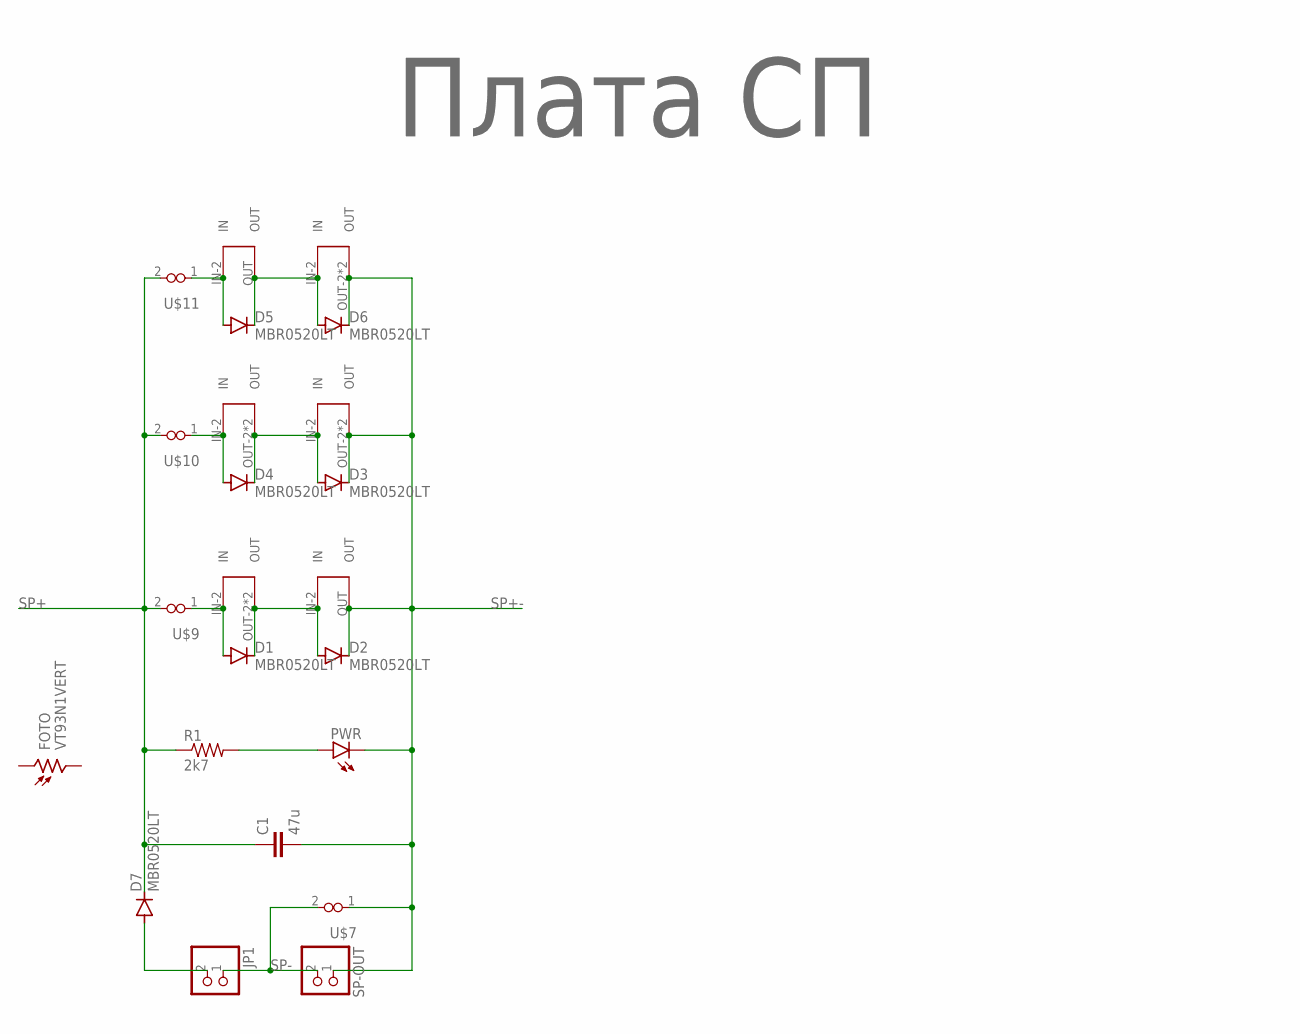
[picture p78: schematic SP.sch]

Parts:
C1: 47u; C1210
D1, D2, D3, D4, D5, D6, D7: MBR0520LT; SOD123
FOTO: VT93N1VERT; VT93N1-VERT
JP1: PINHD-1X2; 1X02
PWR: LEDCHIP-LED0603; CHIP-LED0603
R1: 2k7; R0603
SP-OUT: PINHD-1X2; 1X02
U$1, U$3, U$4, U$8: SOLAR-2_INVERT0-2; SOLAR_0-2_INVERT
U$2, U$6: SOLAR-2_INVERT1-2; SOLAR_1-2_INVERT
U$5: Плата СП; LOGO
U$7, U$9, U$10, U$11: VIAS-CONNECT

Connections:
unnamed: D7.A, JP1.2
unnamed: D5.A, U$6.IN-2 (IN), U$11.1
unnamed: D4.A, U$4.IN-2 (IN), U$10.1
unnamed: PWR.A, R1.2
unnamed: D1.C, D2.A, U$1.OUT-2 (OUT), U$1.OUT-21 (OUT), U$2.IN-2 (IN)
unnamed: D3.A, D4.C, U$3.IN-2 (IN), U$4.OUT-2 (OUT), U$4.OUT-21 (OUT)
unnamed: D1.A, U$1.IN-2 (IN), U$9.1
unnamed: D5.C, D6.A, U$6.OUT, U$8.IN-2 (IN)
SP+: C1.1, D7.C, R1.1, U$9.2, U$10.2, U$11.2
SP+-: C1.2, D2.C, D3.C, D6.C, PWR.C, SP-OUT.1, U$2.OUT, U$3.OUT-2 (OUT), U$3.OUT-21 (OUT), U$7.1, U$8.OUT-2 (OUT), U$8.OUT-21 (OUT)
SP-: JP1.1, SP-OUT.2, U$7.2

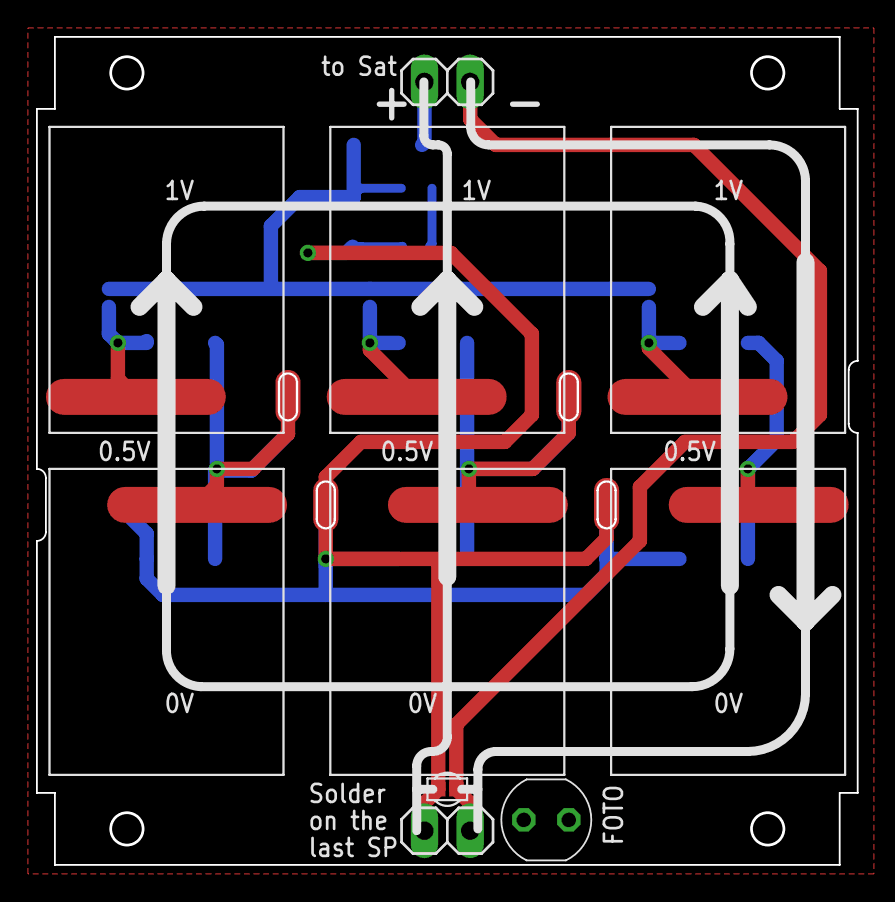
[picture p79: board SP.brd from above]

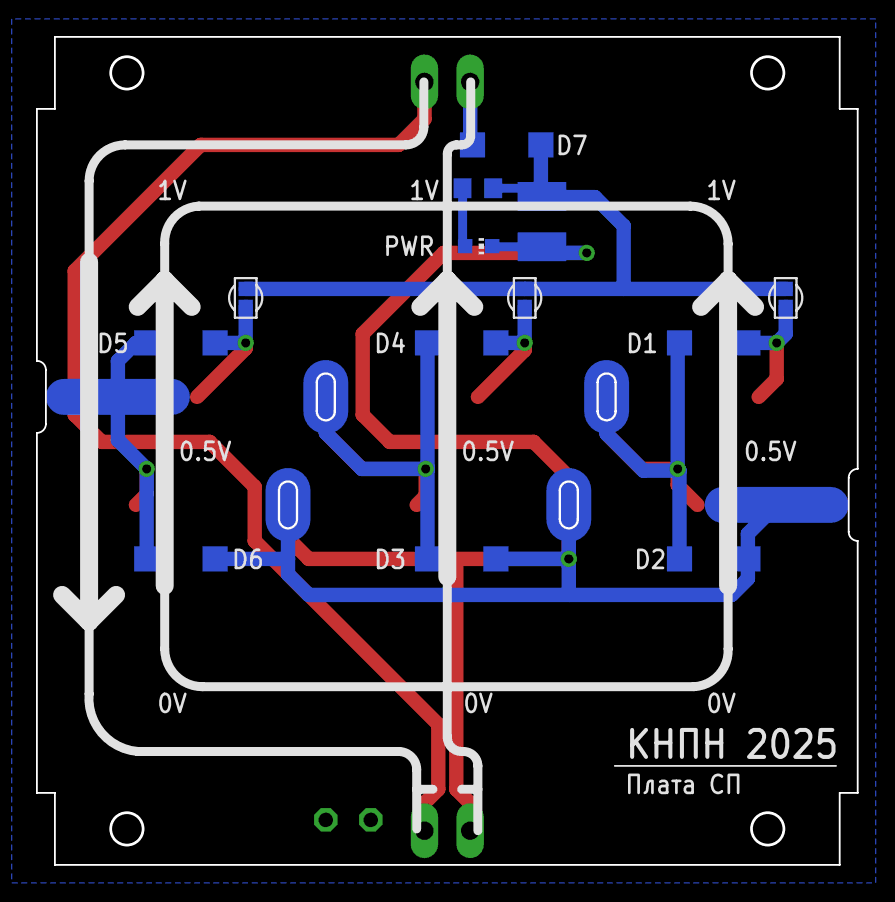
[picture p80: board SP.brd from below]

Board: 2 copper layers, 45.6 x 46.0 mm, 24 parts (14 on the bottom side), 11 nets.
