cansat-tsniimash/KNPN-2025/schematics/board/GERMO.brd

## EAGLE design schematics/board/GERMO.brd (2025-03-10)

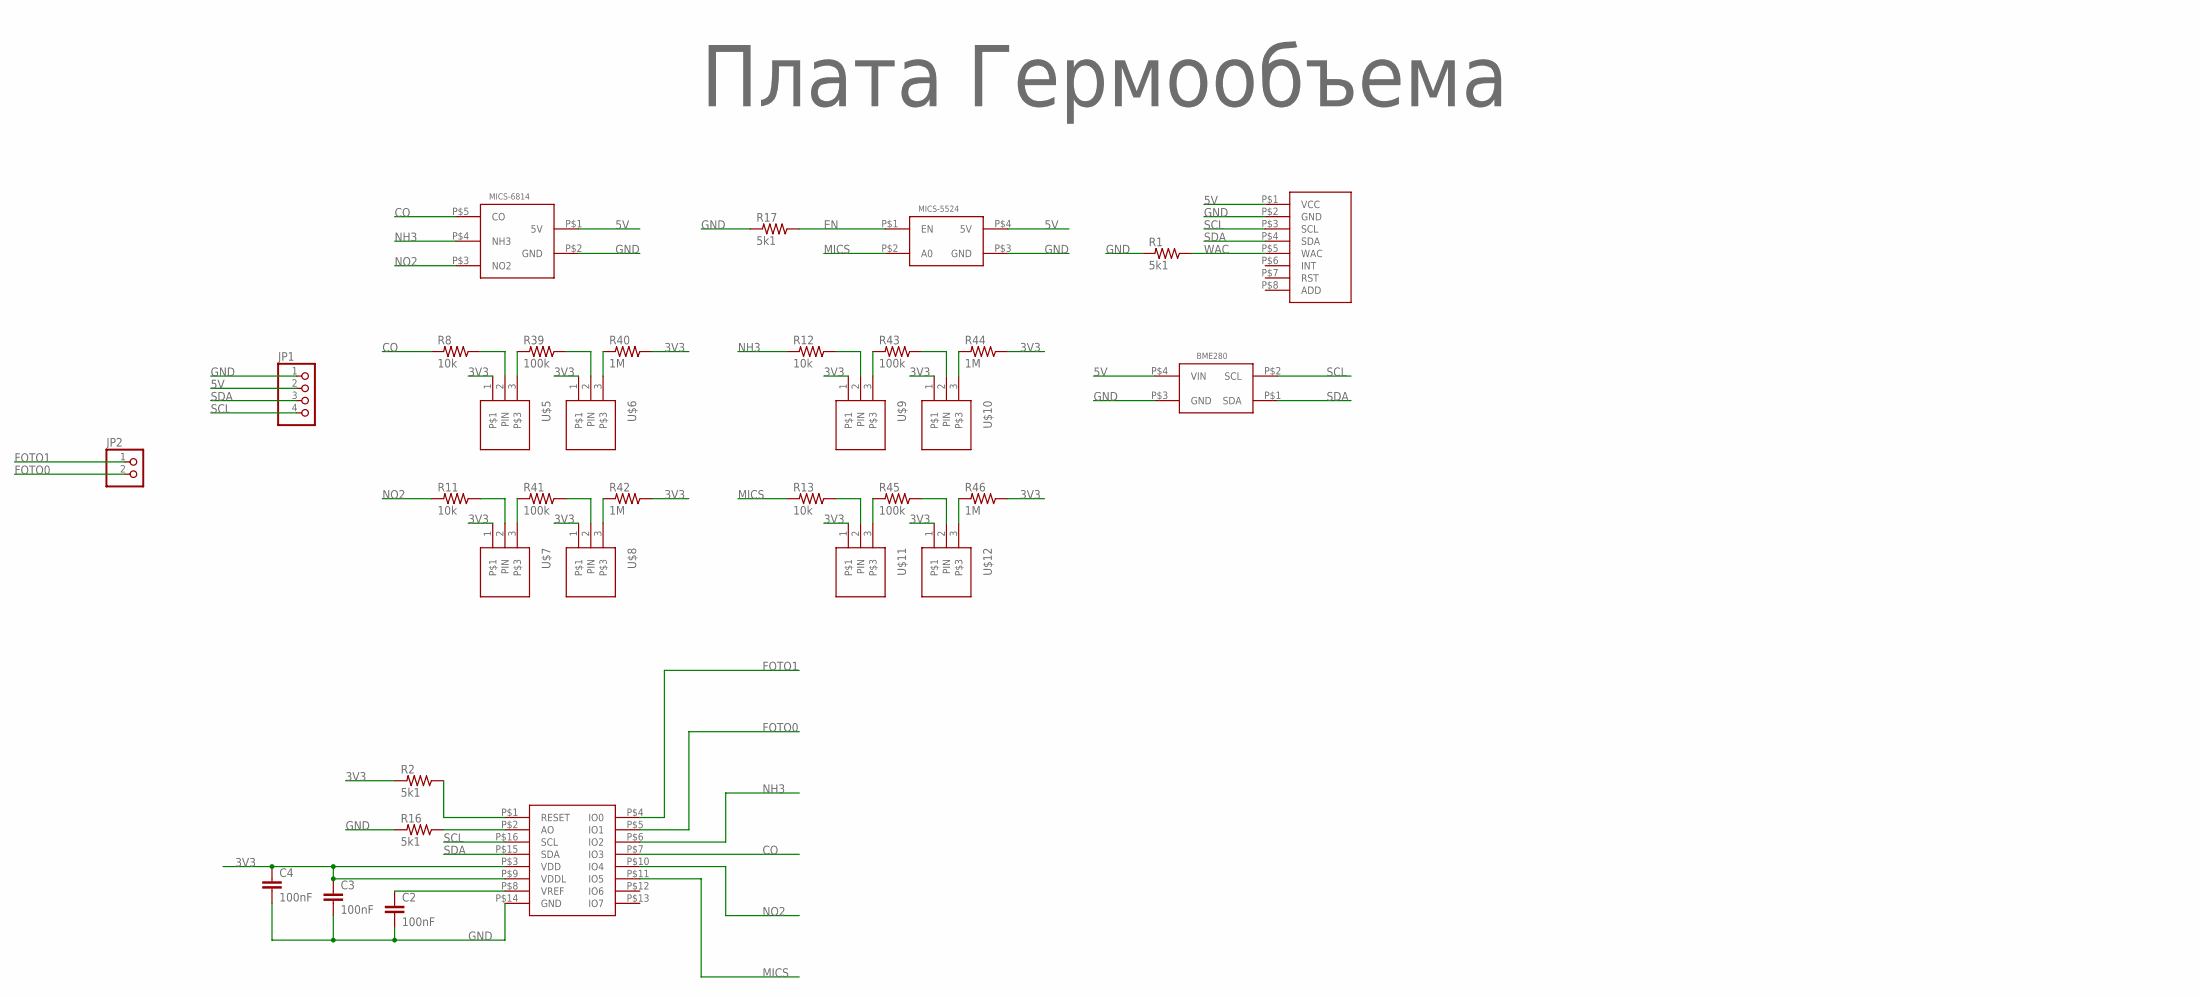
[picture p81: schematic GERMO.sch]

Parts:
BME280: BME280BME280-PINS-ONLY; BME280-PINS-ONLY
C2, C3, C4: 100nF; C0603
CCS811: CCS811; CSS811
JP1: PINHD-1X4; 1X04
JP2: PINHD-1X2; 1X02
MICS-5524: MICS_5524; MICS-5524
MICS-6814: MICS-6814
R1, R2, R16, R17: 5k1; R0603
R8, R11, R12, R13: 10k; R0603
R39, R41, R43, R45: 100k; R0603
R40, R42, R44, R46: 1M; R0603
U$2: Плата Гермообъема; LOGO
U$5, U$6, U$7, U$8, U$9, U$10, U$11, U$12: CONNECT_3
U$14: AD5593

Connections:
3V3: C3.1, C4.1, R2.2, R40.1, R42.1, R44.1, R46.1, U$5.1, U$6.1, U$7.1, U$8.1, U$9.1, U$10.1, U$11.1, U$12.1, U$14.P$3 (VDD), U$14.P$9 (VDDL)
5V: BME280.P$4 (VIN), CCS811.P$1 (VCC), JP1.2, MICS-5524.P$4 (5V), MICS-6814.P$1 (5V)
CO: MICS-6814.P$5 (CO), R8.2, U$14.P$7 (IO3)
EN: MICS-5524.P$1 (EN), R17.1
FOTO0: JP2.2, U$14.P$5 (IO1)
FOTO1: JP2.1, U$14.P$4 (IO0)
GND: BME280.P$3 (GND), C2.2, C3.2, C4.2, CCS811.P$2 (GND), JP1.1, MICS-5524.P$3 (GND), MICS-6814.P$2 (GND), R1.2, R16.2, R17.2, U$14.P$14 (GND)
MICS: MICS-5524.P$2 (A0), R13.2, U$14.P$11 (IO5)
unnamed: R39.2, U$5.3
unnamed: R8.1, U$5.2 (PIN)
unnamed: R40.2, U$6.3
unnamed: R39.1, U$6.2 (PIN)
unnamed: R41.2, U$7.3
unnamed: R11.1, U$7.2 (PIN)
unnamed: R42.2, U$8.3
unnamed: R41.1, U$8.2 (PIN)
unnamed: R43.2, U$9.3
unnamed: R12.1, U$9.2 (PIN)
unnamed: R44.2, U$10.3
unnamed: R43.1, U$10.2 (PIN)
unnamed: R45.2, U$11.3
unnamed: R13.1, U$11.2 (PIN)
unnamed: R46.2, U$12.3
unnamed: R45.1, U$12.2 (PIN)
unnamed: C2.1, U$14.P$8 (VREF)
unnamed: R16.1, U$14.P$2 (AO)
unnamed: R2.1, U$14.P$1 (RESET)
NH3: MICS-6814.P$4 (NH3), R12.2, U$14.P$6 (IO2)
NO2: MICS-6814.P$3 (NO2), R11.2, U$14.P$10 (IO4)
SCL: BME280.P$2 (SCL), CCS811.P$3 (SCL), JP1.4, U$14.P$16 (SCL)
SDA: BME280.P$1 (SDA), CCS811.P$4 (SDA), JP1.3, U$14.P$15 (SDA)
WAC: CCS811.P$5 (WAC), R1.1

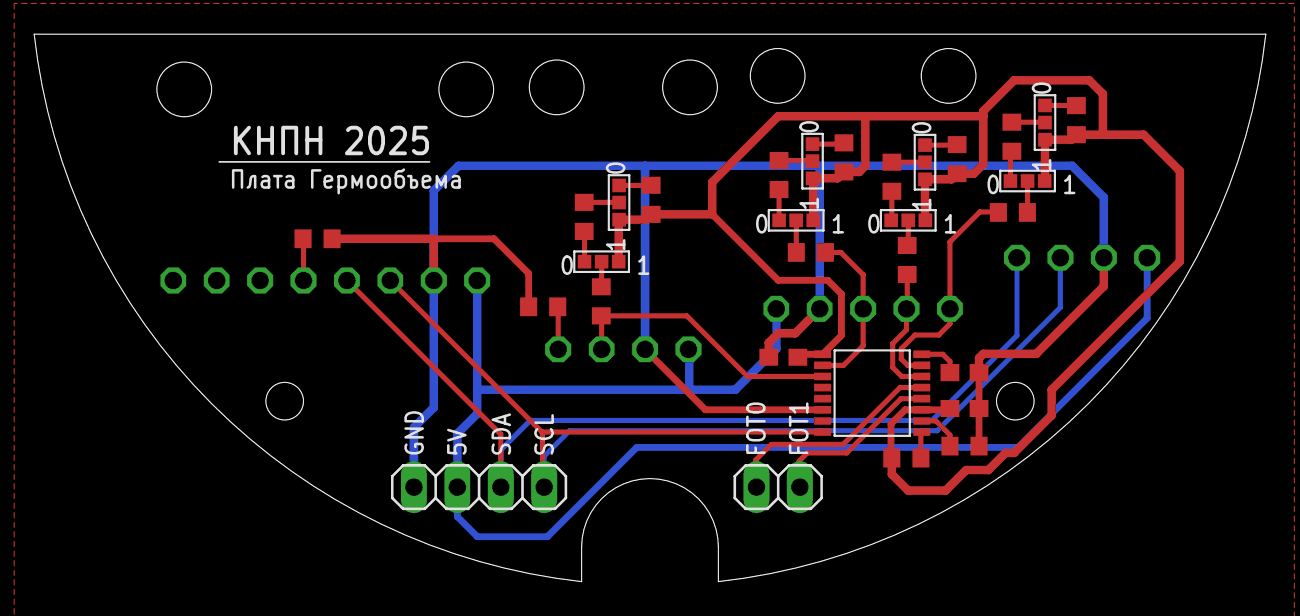
[picture p82: board GERMO.brd from above]

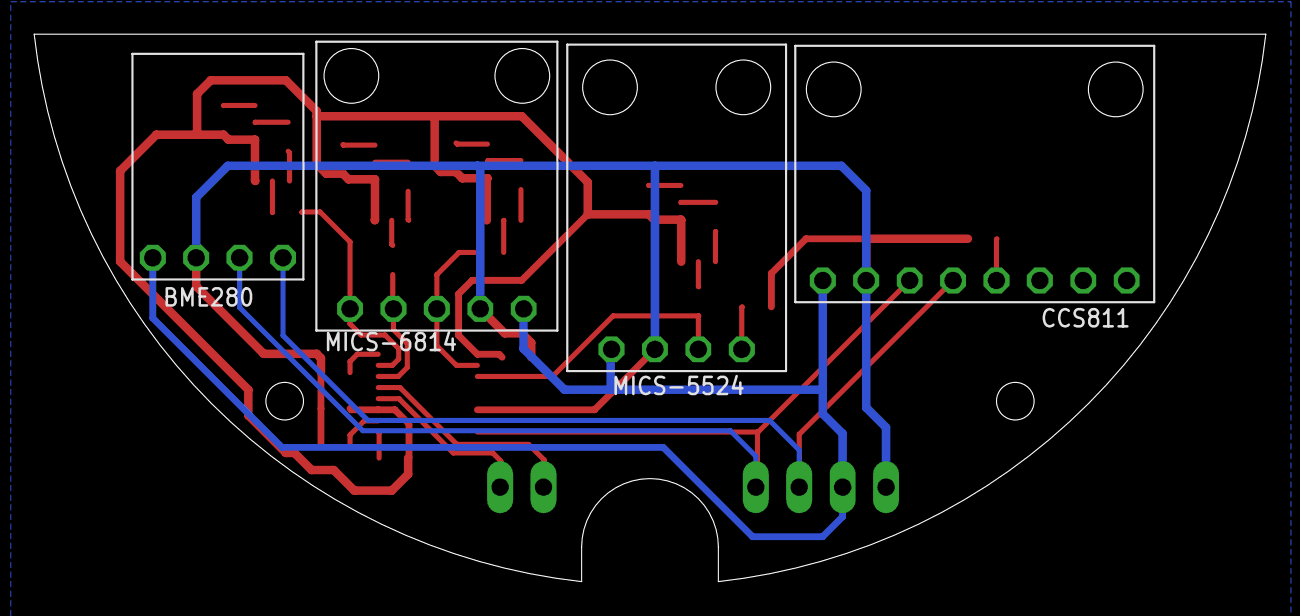
[picture p83: board GERMO.brd from below]

Board: 2 copper layers, 72.1 x 32.0 mm, 35 parts (4 on the bottom side), 32 nets.
