cansat-tsniimash/KNPN-2025/schematics/MK.brd

## EAGLE design schematics/MK.brd (2025-02-22)

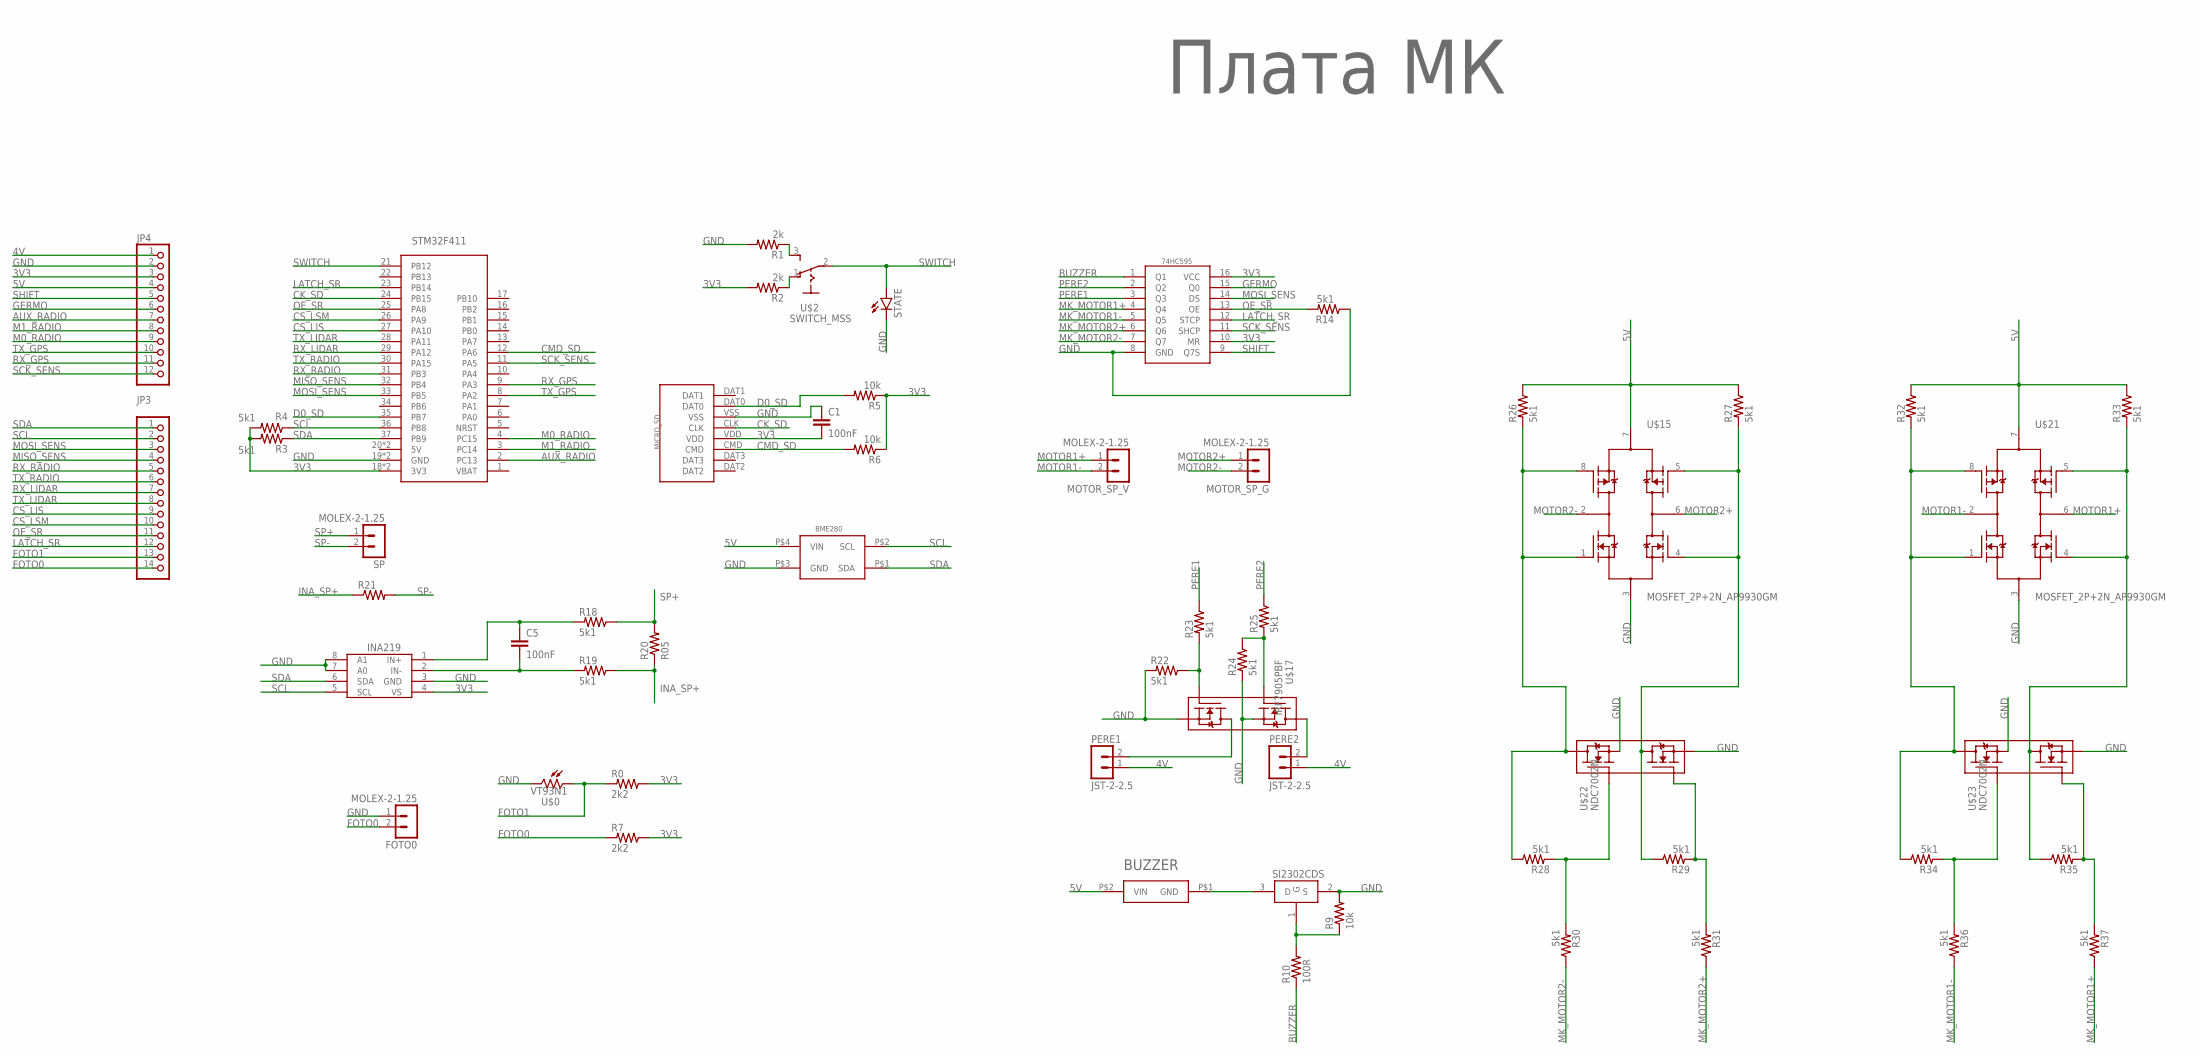
[picture p84: schematic MK.sch]

Parts:
BME280: BME280BME280-PINS-ONLY; BME280-PINS-ONLY
BUZZER: BUZZERS8R6; BUZZER-S8R12
C1, C5: 100nF; C0603
FOTO0: MOLEX-2-1.25; 53047-02
JP3: PINHD-1X14; 1X14
JP4: PINHD-1X12; 1X12
MICRO_SD: SD
MOTOR_SP_G: MOLEX-2-1.25; 53047-02
MOTOR_SP_V: MOLEX-2-1.25; 53047-02
PERE1, PERE2: JST-2-2.5
R0, R7: 2k2; R0603
R1, R2: 2k; R0603
R3, R4, R14, R18, R19, R22, R23, R24, R25, R26, R27, R28, R29, R30, R31, R32, R33, R34, R35, R36, R37: 5k1; R0603
R5, R6, R9: 10k; R0603
R10: 100R; R0603
R20: R05; R2512
R21: R-US_0207/15; 0207/15
SI2302CDS: SI2302CDS; SOT23-3
SP: MOLEX-2-1.25; 53047-02
STATE: LEDCHIPLED_0603; CHIPLED_0603
STM32F411: STM32F411_BOARD
U$0: VT93N1
U$1: Плата МК; LOGO
U$2: SWITCH_MSS
U$13: 74HC595; TSSOP16
U$15, U$21: MOSFET_2P+2N_AP9930GM; SO8
U$16: INA219AID; SOT23-8
U$17: IRF7905PBF; SO8
U$22, U$23: NDC7002N; SOT23-6

Connections:
3V3: C1.2, JP4.3, MICRO_SD.VDD, R0.1, R2.2, R3.2, R4.2, R5.1, R6.1, R7.1, STM32F411.18 (3V3), STM32F411.40 (3V3), U$13.10 (MR), U$13.16 (VCC), U$16.4 (VS)
4V: JP4.1, PERE1.1, PERE2.1
5V: BME280.P$4 (VIN), BUZZER.P$2 (VIN), JP4.4, R26.1, R27.1, R32.1, R33.1, U$15.7 (P1P2S), U$21.7 (P1P2S)
AUX_RADIO: JP4.7, STM32F411.2 (PC13)
BUZZER: R10.1, U$13.1 (Q1)
CK_SD: MICRO_SD.CLK, STM32F411.24 (PB15)
CMD_SD: MICRO_SD.CMD, R6.2, STM32F411.12 (PA6)
CS_LIS: JP3.9, STM32F411.27 (PA10)
CS_LSM: JP3.10, STM32F411.26 (PA9)
D0_SD: MICRO_SD.DAT0, R5.2, STM32F411.35 (PB7)
FOTO0: FOTO0.2, JP3.14, R7.2
FOTO1: JP3.13, R0.2, U$0.P$1 (1)
GERMO: JP4.6, U$13.15 (Q0)
GND: BME280.P$3 (GND), C1.1, FOTO0.1, JP4.2, MICRO_SD.VSS, R1.2, R9.2, R14.1, R22.2, R24.2, SI2302CDS.2 (S), STATE.C, STM32F411.19 (GND), STM32F411.39 (GND), U$0.P$2 (2), U$13.8 (GND), U$15.3 (N1N2S), U$16.3 (GND), U$16.7 (A0), U$16.8 (A1), U$17.1 (S2), U$17.3 (S1), U$21.3 (N1N2S), U$22.2 (S2), U$22.5 (S1), U$23.2 (S2), U$23.5 (S1)
INA_SP+: R19.1, R20.1, R21.1
LATCH_SR: JP3.12, STM32F411.23 (PB14), U$13.12 (STCP)
M0_RADIO: JP4.9, STM32F411.4 (PC15)
M1_RADIO: JP4.8, STM32F411.3 (PC14)
MISO_SENS: JP3.4, STM32F411.32 (PB4)
MK_MOTOR1+: R37.1, U$13.4 (Q4)
MK_MOTOR1-: R36.1, U$13.5 (Q5)
MK_MOTOR2+: R31.1, U$13.6 (Q6)
MK_MOTOR2-: R30.1, U$13.7 (Q7)
MOSI_SENS: JP3.3, STM32F411.33 (PB5), U$13.14 (DS)
MOTOR1+: MOTOR_SP_V.1, U$21.6 (P2N2D)
MOTOR1-: MOTOR_SP_V.2, U$21.2 (P1N1D)
MOTOR2+: MOTOR_SP_G.1, U$15.6 (P2N2D)
MOTOR2-: MOTOR_SP_G.2, U$15.2 (P1N1D)
unnamed: R1.1, U$2.3 (S)
unnamed: R2.1, U$2.1 (O)
unnamed: BUZZER.P$1 (GND), SI2302CDS.3 (D)
unnamed: R9.1, R10.2, SI2302CDS.1 (G)
unnamed: C5.2, R19.2, U$16.2 (IN-)
unnamed: C5.1, R18.2, U$16.1 (IN+)
unnamed: PERE1.2, U$17.7 (D2), U$17.8 (D2)
unnamed: PERE2.2, U$17.5 (D1), U$17.6 (D1)
unnamed: R22.1, R23.2, U$17.2 (G2)
unnamed: R24.1, R25.2, U$17.4 (G1)
unnamed: R32.2, R34.1, U$21.1 (N1G), U$21.8 (P1G), U$23.6 (D1)
unnamed: R26.2, R28.1, U$15.1 (N1G), U$15.8 (P1G), U$22.6 (D1)
unnamed: R27.2, R29.1, U$15.4 (N2G), U$15.5 (P2G), U$22.4 (D2)
unnamed: R33.2, R35.1, U$21.4 (N2G), U$21.5 (P2G), U$23.4 (D2)
unnamed: R34.2, R36.2, U$23.1 (G1)
unnamed: R35.2, R37.2, U$23.3 (G2)
unnamed: R28.2, R30.2, U$22.1 (G1)
unnamed: R29.2, R31.2, U$22.3 (G2)
OE_SR: JP3.11, R14.2, STM32F411.25 (PA8), U$13.13 (OE)
PERE1: R23.1, U$13.3 (Q3)
PERE2: R25.1, U$13.2 (Q2)
RX_GPS: JP4.11, STM32F411.9 (PA3)
RX_LIDAR: JP3.7, STM32F411.29 (PA12)
RX_RADIO: JP3.5, STM32F411.31 (PB3)
SCK_SENS: JP4.12, STM32F411.11 (PA5), U$13.11 (SHCP)
SCL: BME280.P$2 (SCL), JP3.2, R4.1, STM32F411.36 (PB8), U$16.5 (SCL)
SDA: BME280.P$1 (SDA), JP3.1, R3.1, STM32F411.37 (PB9), U$16.6 (SDA)
SHIFT: JP4.5, U$13.9 (Q7S)
SP+: R18.1, R20.2, SP.1
SP-: R21.2, SP.2
SWITCH: STATE.A, STM32F411.21 (PB12), U$2.2
TX_GPS: JP4.10, STM32F411.8 (PA2)
TX_LIDAR: JP3.8, STM32F411.28 (PA11)
TX_RADIO: JP3.6, STM32F411.30 (PA15)

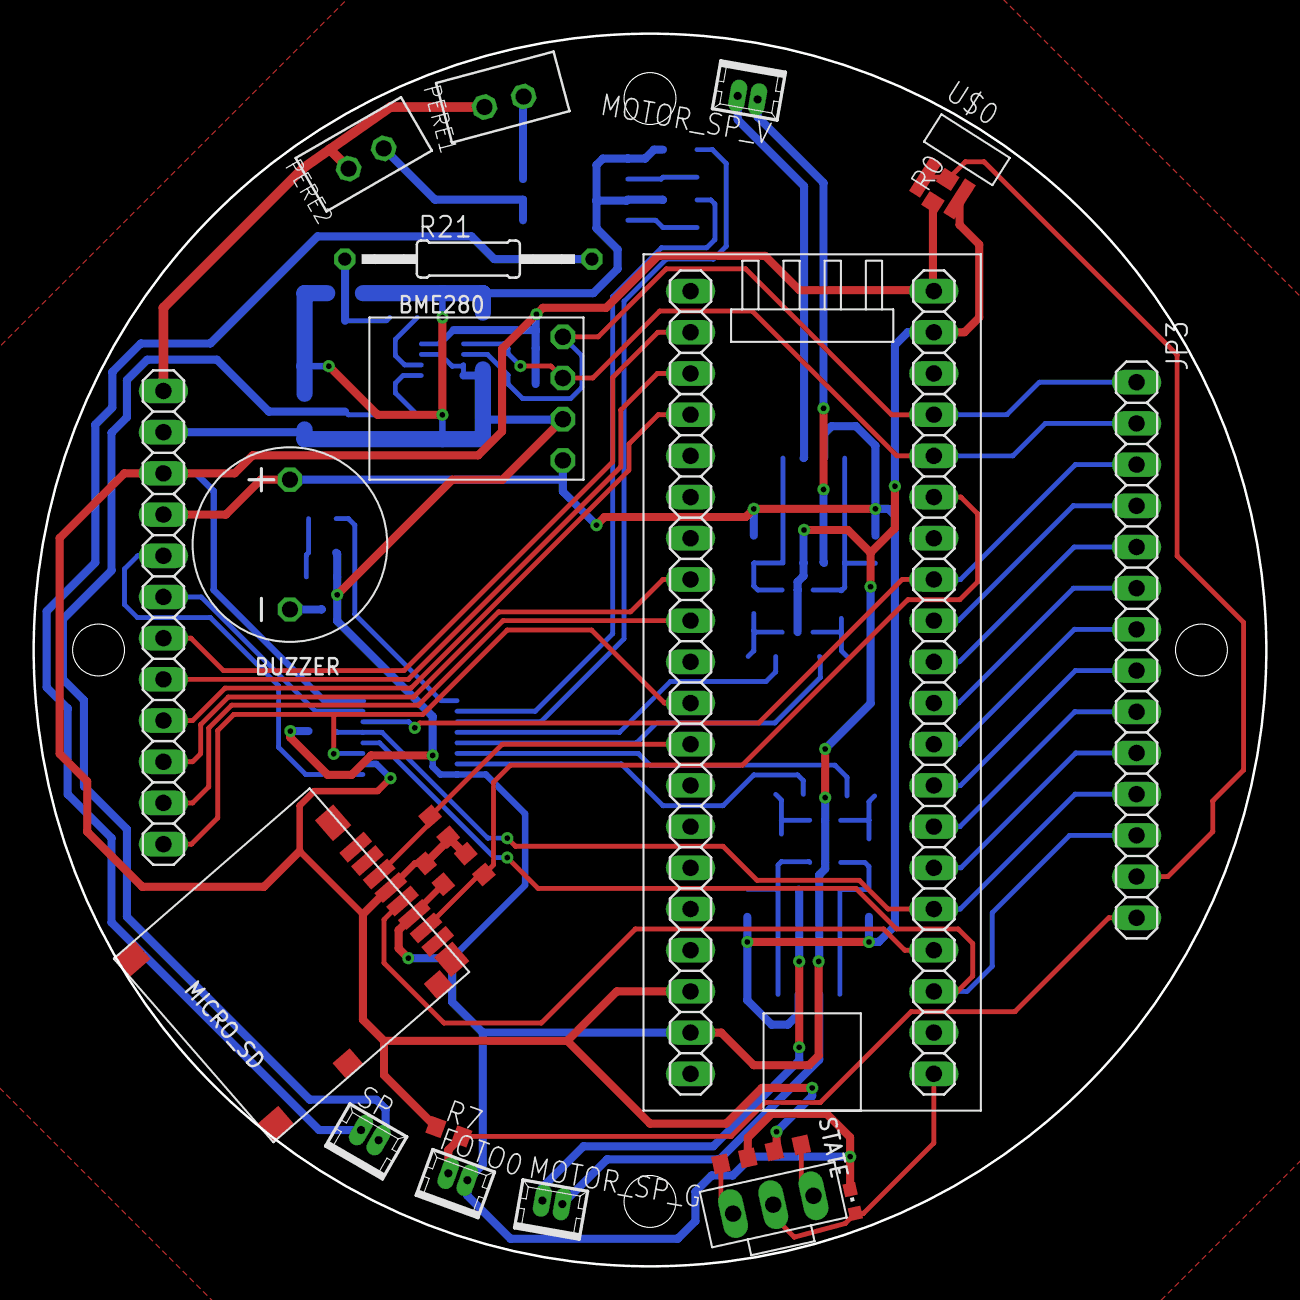
[picture p85: board schematics/MK.brd from above]

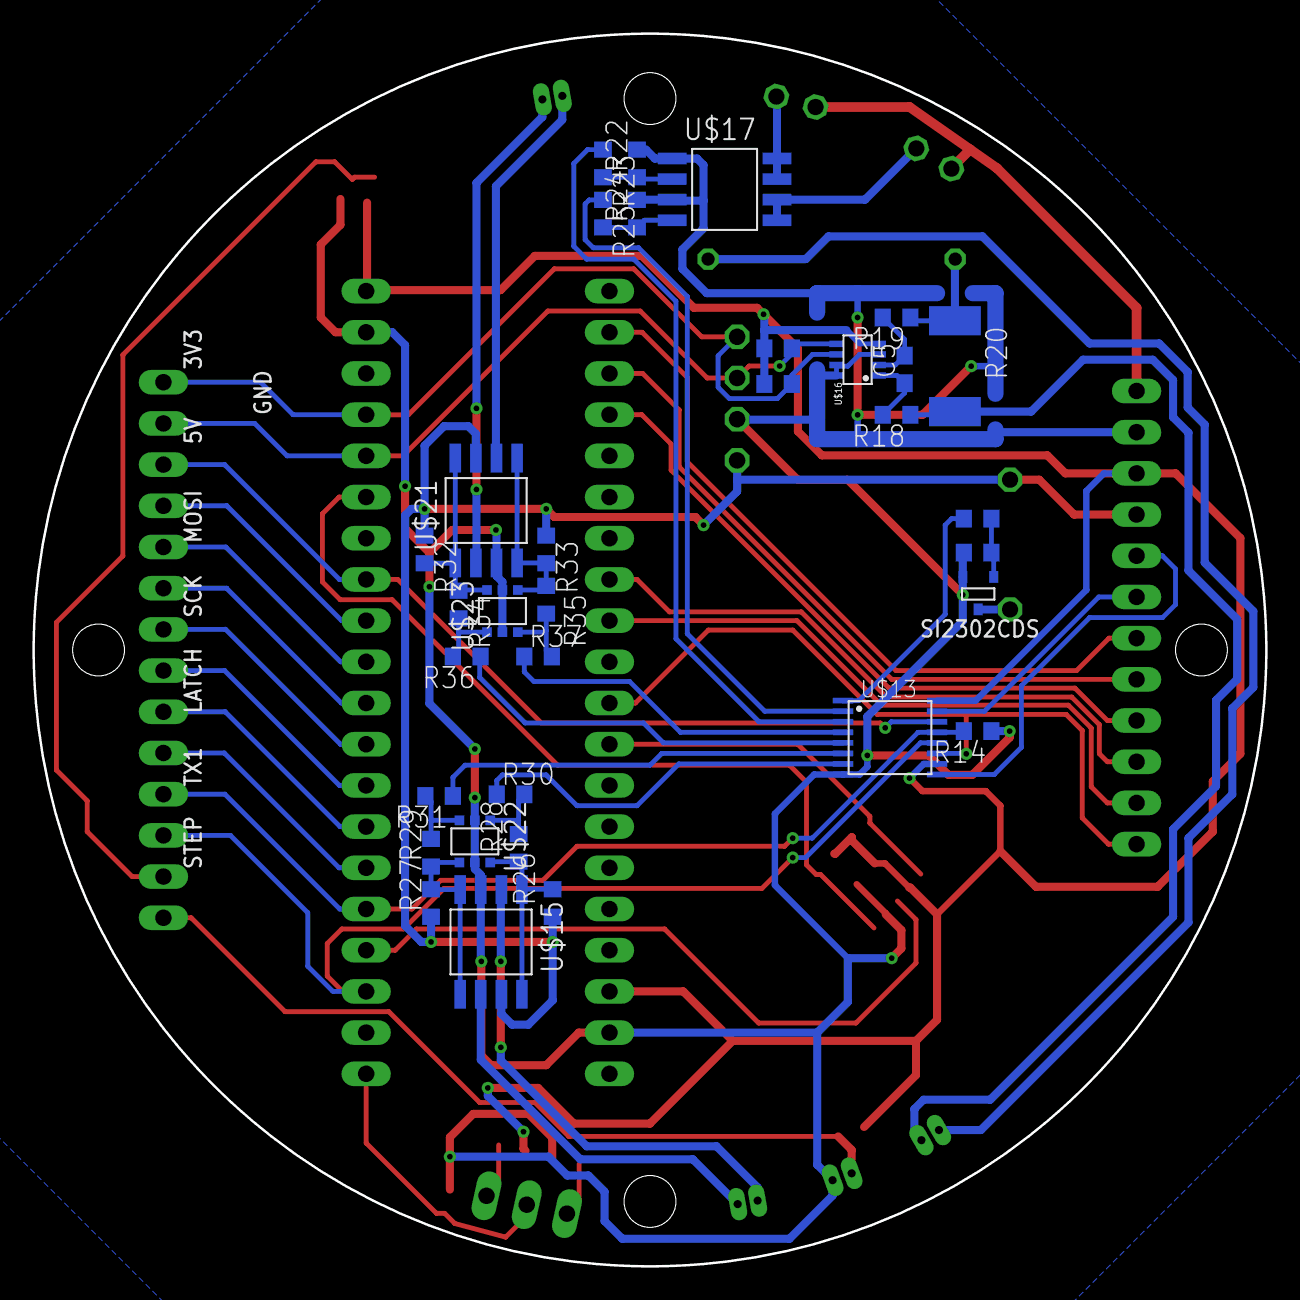
[picture p86: board schematics/MK.brd from below]

Board: 2 copper layers, 76.0 x 76.0 mm, 57 parts (33 on the bottom side), 62 nets.
