cansat-tsniimash/KNPN-2025/schematics/board/SP1.brd

## EAGLE design schematics/board/SP1.brd (2025-02-05)

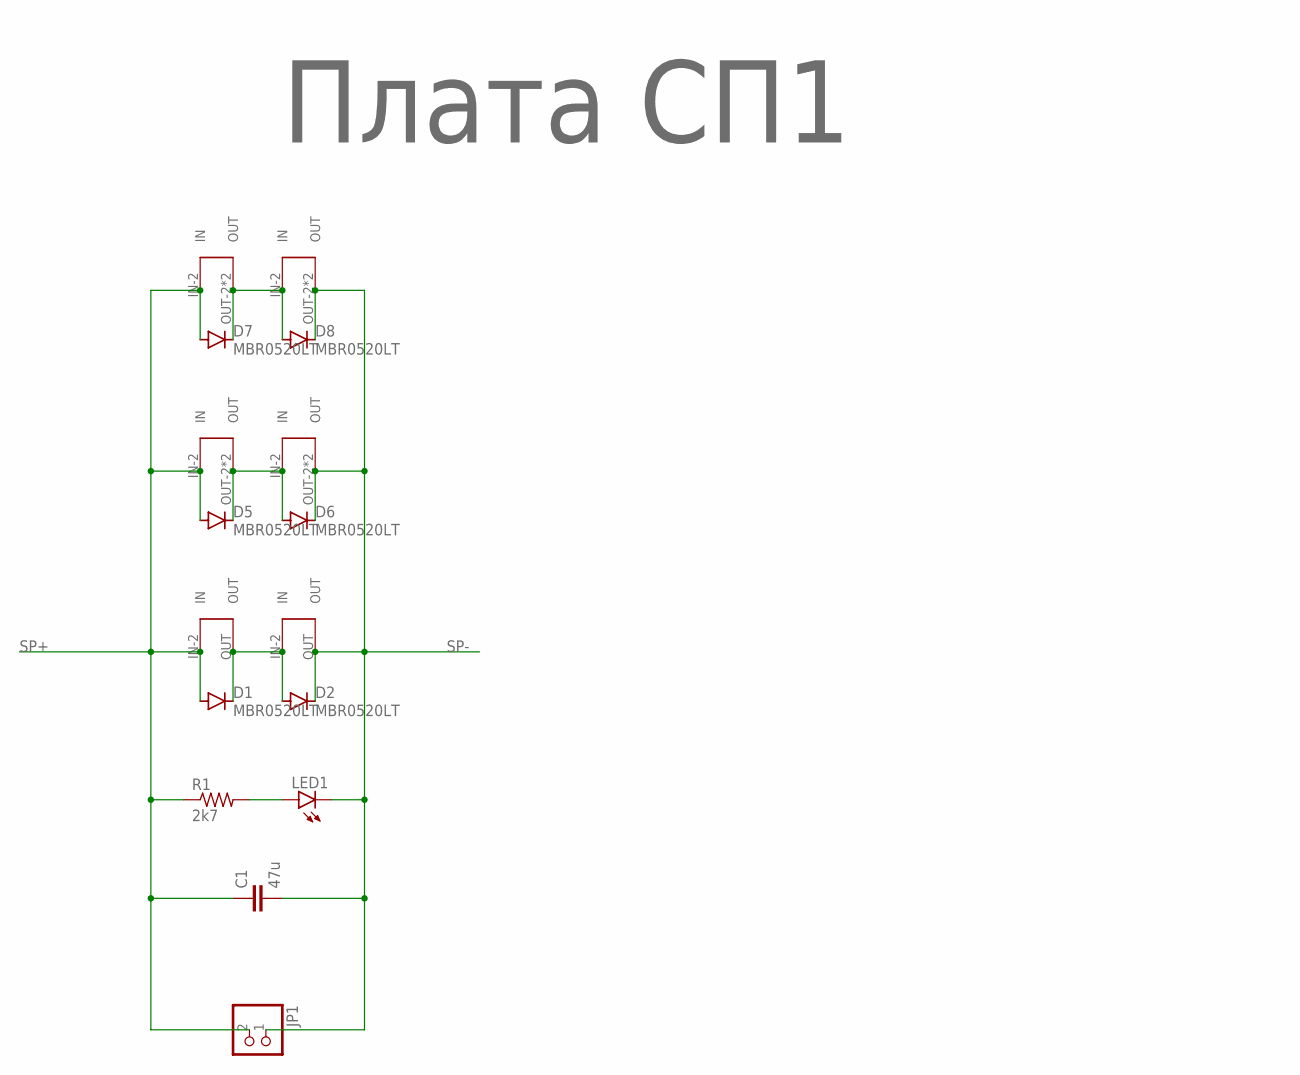
[picture p87: schematic SP1.sch]

Parts:
C1: 47u; C1210
D1, D2, D5, D6, D7, D8: MBR0520LT; SOD123
JP1: PINHD-1X2; 1X02
LED1: LEDCHIP-LED0603; CHIP-LED0603
R1: 2k7; R0603
U$1, U$2: SOLAR-2_1; SOLAR_1-2
U$3: Плата СП1; LOGO
U$5, U$6, U$7, U$8: SOLAR-2_0; SOLAR_0-2

Connections:
unnamed: D1.C, D2.A, U$1.OUT, U$2.IN-2 (IN)
unnamed: LED1.A, R1.2
unnamed: D5.C, D6.A, U$5.OUT-2 (OUT), U$5.OUT-21 (OUT), U$6.IN-2 (IN)
unnamed: D7.C, D8.A, U$7.OUT-2 (OUT), U$7.OUT-21 (OUT), U$8.IN-2 (IN)
SP+: C1.1, D1.A, D5.A, D7.A, JP1.2, R1.1, U$1.IN-2 (IN), U$5.IN-2 (IN), U$7.IN-2 (IN)
SP-: C1.2, D2.C, D6.C, D8.C, JP1.1, LED1.C, U$2.OUT, U$6.OUT-2 (OUT), U$6.OUT-21 (OUT), U$8.OUT-2 (OUT), U$8.OUT-21 (OUT)
