cansat-tsniimash/KNPN-2025/schematics/board/SP1.brd

## EAGLE design schematics/board/SP1.brd (continued)

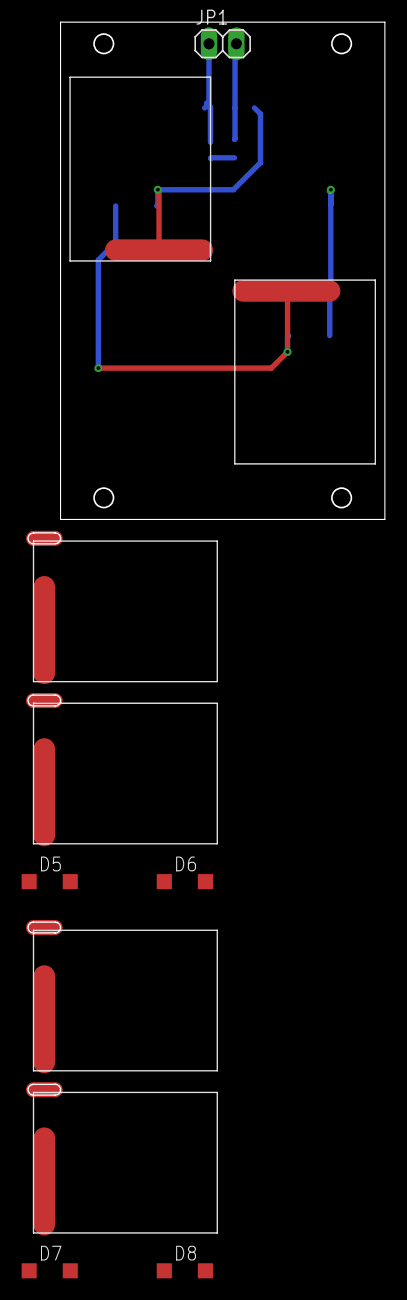
[picture p88: board SP1.brd from above]

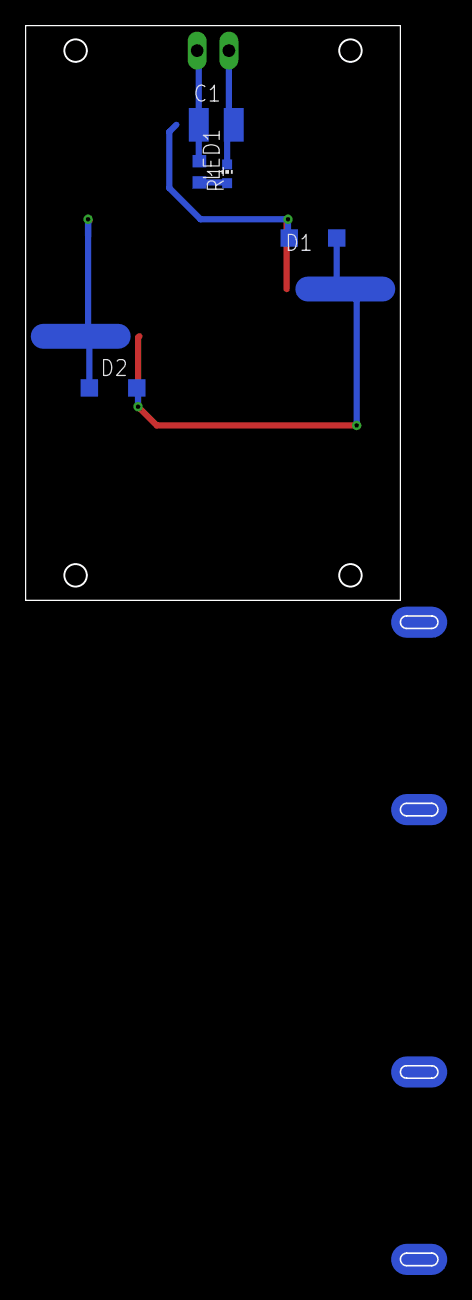
[picture p89: board SP1.brd from below]

Board: 2 copper layers, 33.0 x 99.2 mm, 17 parts (5 on the bottom side), 6 nets.
