cansat-tsniimash/KNPN-2025/schematics/board/SP2.brd

## EAGLE design schematics/board/SP2.brd (2025-02-05)

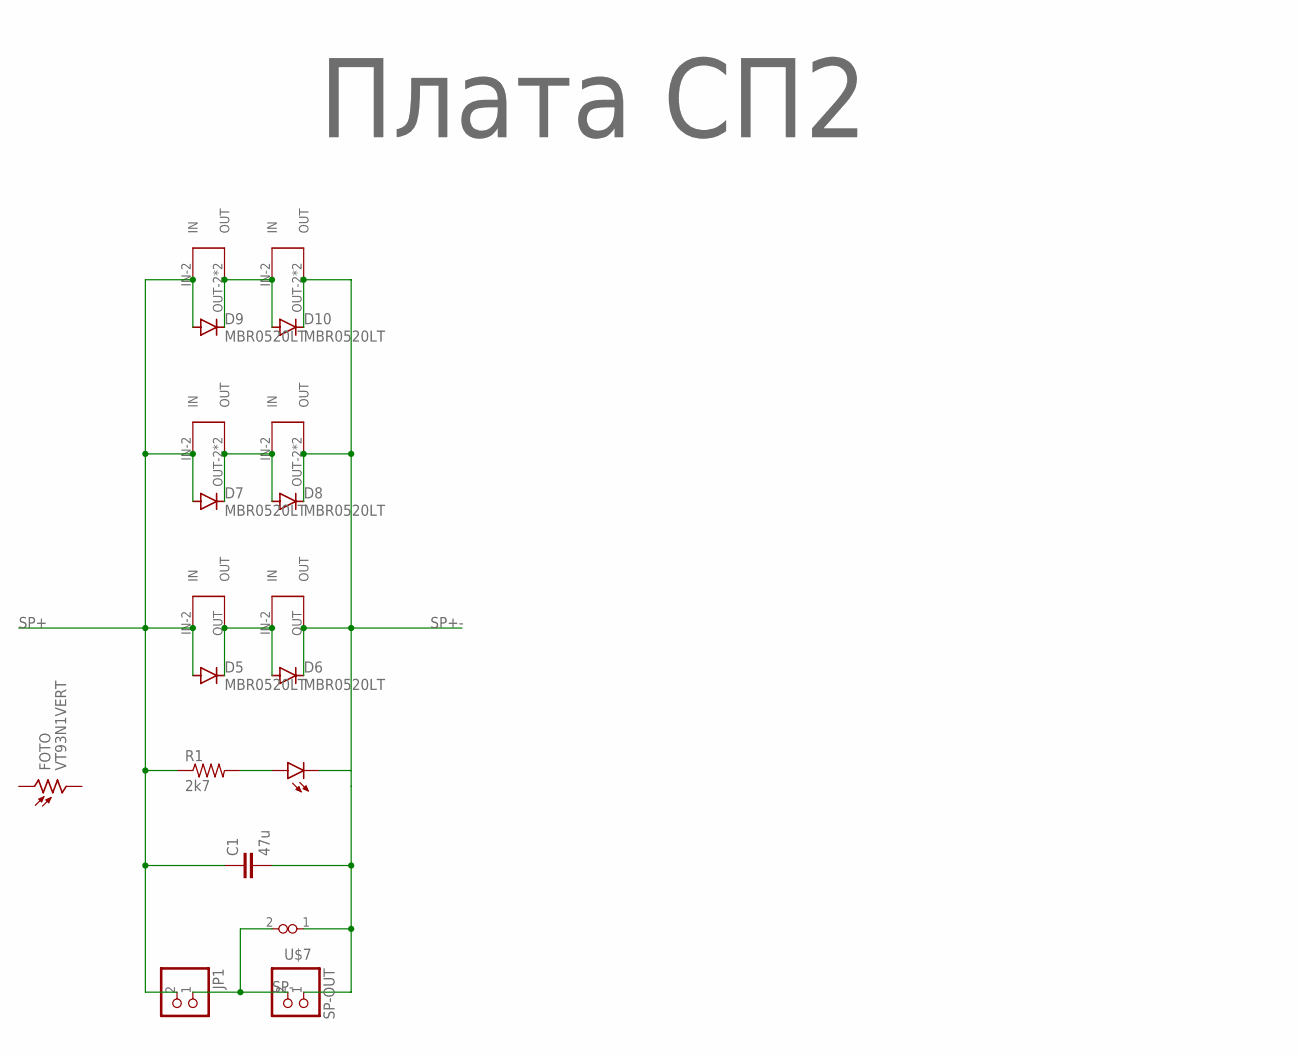
[picture p90: schematic SP2.sch]

Parts:
C1: 47u; C1210
D5, D6, D7, D8, D9, D10: MBR0520LT; SOD123
FOTO: VT93N1VERT; VT93N1-VERT
JP1: PINHD-1X2; 1X02
PWR: LEDCHIP-LED0603; CHIP-LED0603
R1: 2k7; R0603
SP-OUT: PINHD-1X2; 1X02
U$1: Плата СП2; LOGO
U$5, U$6: SOLAR-2_1; SOLAR_1-2
U$7: VIAS-CONNECT
U$8, U$9, U$10, U$11: SOLAR-2_0; SOLAR_0-2

Connections:
unnamed: PWR.A, R1.2
unnamed: D5.C, D6.A, U$5.OUT, U$6.IN-2 (IN)
unnamed: D7.C, D8.A, U$8.OUT-2 (OUT), U$8.OUT-21 (OUT), U$9.IN-2 (IN)
unnamed: D9.C, D10.A, U$10.OUT-2 (OUT), U$10.OUT-21 (OUT), U$11.IN-2 (IN)
SP+: C1.1, D5.A, D7.A, D9.A, JP1.2, R1.1, U$5.IN-2 (IN), U$8.IN-2 (IN), U$10.IN-2 (IN)
SP+-: C1.2, D6.C, D8.C, D10.C, PWR.C, SP-OUT.1, U$6.OUT, U$7.1, U$9.OUT-2 (OUT), U$9.OUT-21 (OUT), U$11.OUT-2 (OUT), U$11.OUT-21 (OUT)
SP-: JP1.1, SP-OUT.2, U$7.2

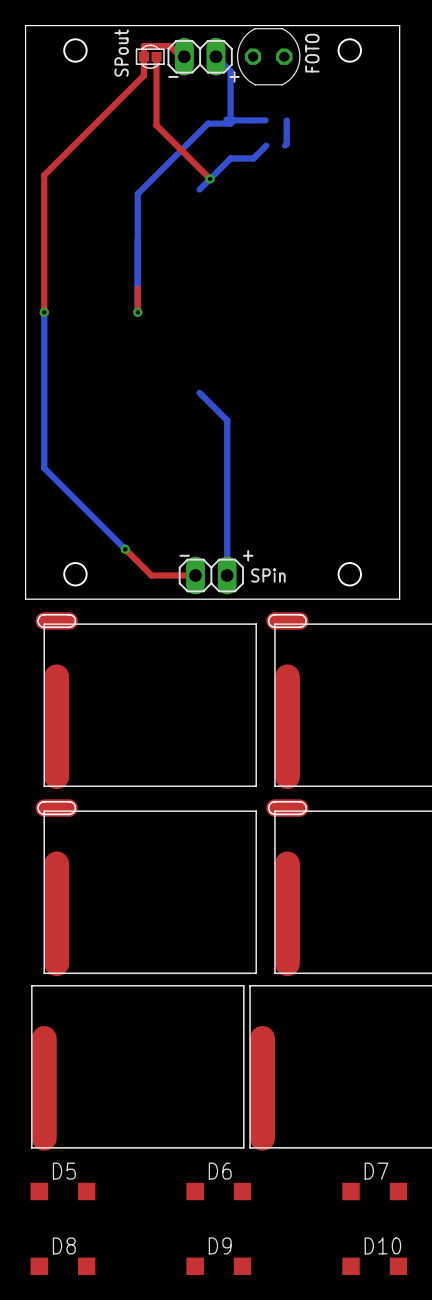
[picture p91: board SP2.brd from above]

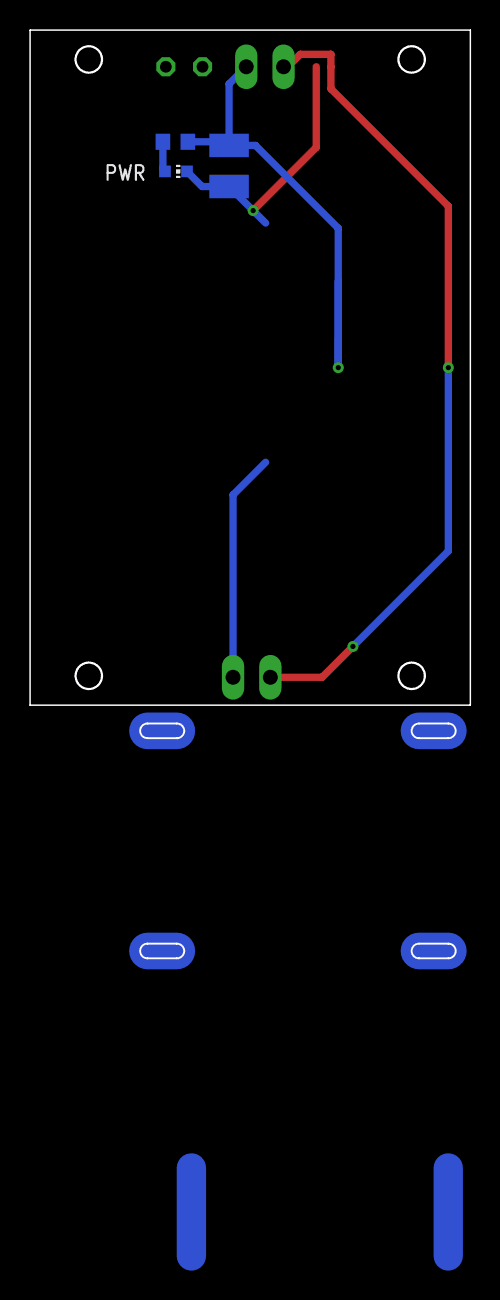
[picture p92: board SP2.brd from below]

Board: 2 copper layers, 20 parts (3 on the bottom side), 7 nets.
