cansat-tsniimash/KNPN-2025/schematics/Cansat-2025-1.brd

## EAGLE design schematics/Cansat-2025-1.brd (2025-03-26)

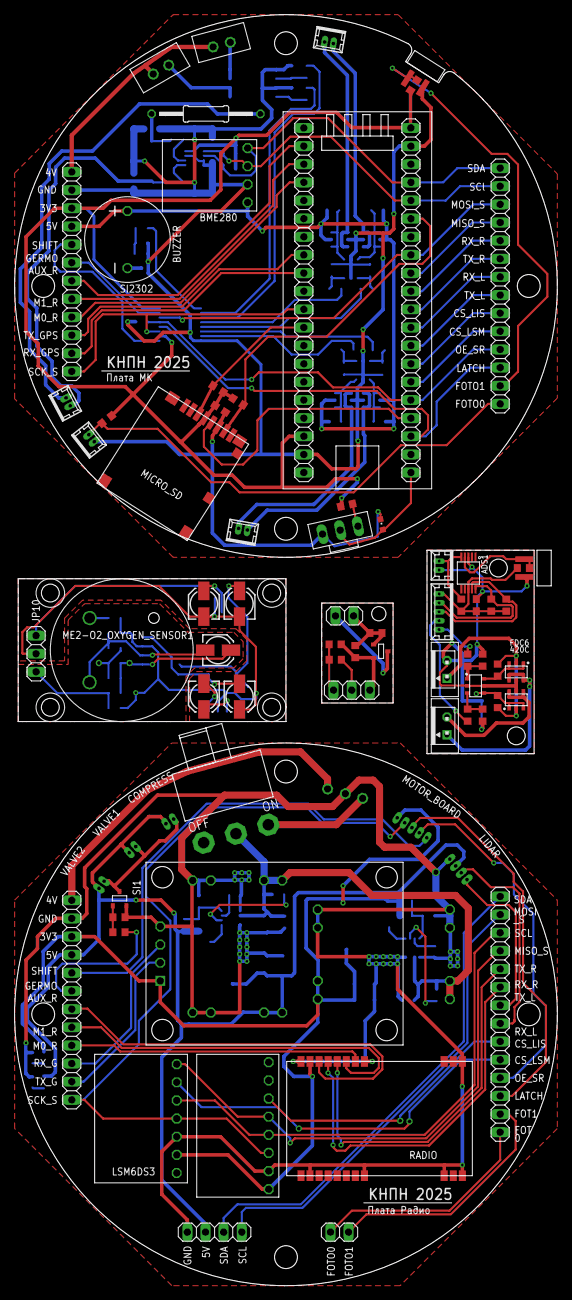
[picture p96: board Cansat-2025-1.brd from above]

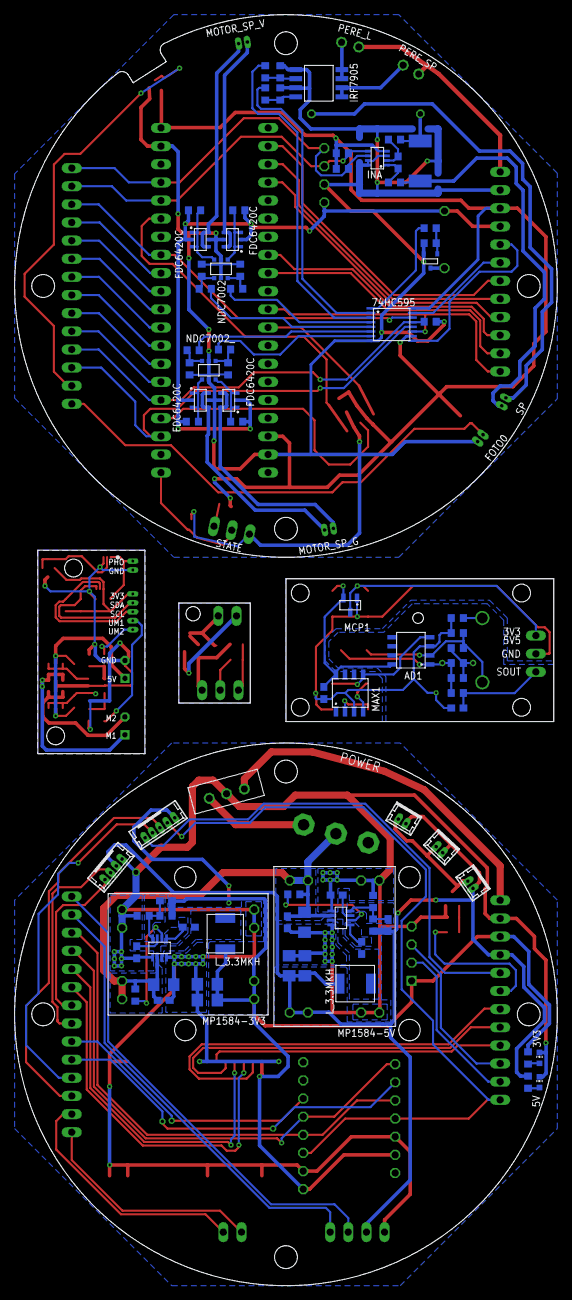
[picture p97: board Cansat-2025-1.brd from below]

Board: 2 copper layers, 76.0 x 178.0 mm, 152 parts (82 on the bottom side), 134 nets.

Parts:
3V3, 5V: CHIP-LED0603
74HC595: 74HC595; TSSOP16
AD1: AD8572
ADS1: ADS1115; MSOP10
BME280: BME280BME280-PINS-ONLY; BME280-PINS-ONLY
BUZZER: BUZZERS8R6; BUZZER-S8R12
C1, C25, C29: 0.1uF; C0603
C2, C5: 100nF; C0603
C3, C7, C11, C14: 0,1u; C0603
C4, C12: 0,1u; C1206
C6, C13: 22u; C0603
C8, C15: 33p; C0603
C9, C10, C16, C17: 22u; C1206
C26, C27, C28: 10uF; 153CLV-0405
C30, C31: 1uF; 153CLV-0405
COMPRESS: MOLEX-2-1.25; 53047-02
FOTO0: MOLEX-2-1.25; 53047-02
GPS-NEO7M: GPS-NEO7M
INA: INA219AID; SOT23-8
IRF7905: IRF7905PBF; SO8
JP1, JP3: 1X14
JP2, JP9: 1X02
JP4, JP5: 1X12
JP6: 1X04
JP8, JP10: 1X03
LIDAR: MOLEX-4-1.25; 53047-04
LSM6DS3: LSM6DS3; LSM6DS3_WITHOUT
L_3.3: L_3.3MKH; L_SPM5020
MAX1: MAX660
MCP1: MCP1700
ME2-O2_OXYGEN_SENSOR1: ME2-O2_OXYGEN_SENSOR
MICRO_SD: SD
MOTOR_BOARD: MOLEX-5-1.25; 53047-05
MOTOR_SP_G: MOLEX-2-1.25; 53047-02
MOTOR_SP_V: MOLEX-2-1.25; 53047-02
MP1584-3V3: MP1584-B
MP1584-5V: MP1584; MP1584-B
NDC7002, NDC7002_: NDC7002N; SOT23-6
PERE_L: JST-2-2.5
PERE_SP: JST-2-2.5
POWER: SS_12D11
R0, R18: 2k2; R0603
R1: 5K; R0603
R3: 68K; R0603
R4, R5, R56, R57, R59, R60, R66, R68: 10K; R0603
R6: 47R; R0603
R11, R16, R17, R22, R24, R26, R27, R28, R29, R32, R33, R34, R35, R41, R44, R48: 10k; R0603
R12, R23, R25, R30, R31, R36, R37, R49, R58, R65, R67: 100R; R0603
R13, R46, R47, R61, R62: 2k; R0603
R14, R15, R38: 5k1; R0603
R19, R20: 10R; R0603
R21: R05; R2512
R39: 100R; 0207/15
R40, R43: 100k; R0603
R42: 31k6; R0603
R45: 53k6; R0603
R55: 5.1K; R0603
R63, R64: 5K1; R0603
RADIO: E220-400T22S
RT2: 5K; R0603
SI1, SI2300A, SI2302: SI2302CDS; SOT23-3
SP: MOLEX-2-1.25; 53047-02
STATE: CHIPLED_0603
STM32F411: STM32F411_BOARD
U$0, U$9: VT93N1
U$1: SWITCH_MSS
U$4: Плата МК; LOGO
U$5: Плата Радио; LOGO
U$6, U$7: MP2225; TSOT23-8
U$8: L_3.3MKH; L_SPM5020
U$10: LIS3MDL
U$11: IRF5852; TSOP-6
U$12, U$13, U$19, U$20, U$21, U$22: FDC6420C; TSOP-6
VALVE1, VALVE2: MOLEX-2-1.25; 53047-02
X5: AKKUM; JST-3-2.5
X6: JST-5; MOLEX-5-1.25
X7: JST-2-1.25; MOLEX-2-1.25
X8, X9: JST-2-K-S; B2B-PH-K-S

Connections:
3.3-5.5V1: C30.+, JP10.3, MCP1.P3
3V1: 74HC595.10, 74HC595.16, C2.2, INA.4, JP4.3, MICRO_SD.VDD, R0.1, R13.2, R14.2, R15.2, R16.1, R17.1, R18.1, STM32F411.18, STM32F411.40
3V2: C8.1, C9.2, C10.2, GPS-NEO7M.P$1, JP5.3, LSM6DS3.P$2, L_3.3.P$1, MOTOR_BOARD.5, MP1584-3V3.P$7, MP1584-3V3.P$8, R42.2, R47.2, RADIO.P$25, U$10.UCC
3V3: AD1.P8, C29.1, C31.+, MAX1.P8, MCP1.P2
3V4: ADS1.8, C25.2, R61.1, R62.1, R63.2, R64.2, X6.P$1
4V: JP4.1, PERE_L.1, PERE_SP.1
4V1: JP5.1, X5.3
5V1: BME280.P$4, BUZZER.P$2, JP4.4, R26.1, R27.1, R32.1, R33.1, U$19.P$2, U$20.P$2, U$21.P$2, U$22.P$2
5V2: C15.1, C16.2, C17.2, COMPRESS.2, JP5.4, JP6.2, LIDAR.3, MP1584-5V.P$7, MP1584-5V.P$8, R45.2, R46.2, U$8.P$1, VALVE1.2, VALVE2.2
5V3: R59.2, R60.1, U$12.P$2, U$13.P$2, X8.1
-3V1: AD1.P4, C27.-, MAX1.P5
AUX_RADIO: JP4.7, STM32F411.2
AUX_RADIO1: JP5.7, RADIO.P$24
BUS+: C4.2, C6.2, C12.2, C13.2, MP1584-3V3.P$1, MP1584-3V3.P$2, MP1584-5V.P$1, MP1584-5V.P$2, POWER.2, R40.1, R43.1, U$6.P$2, U$7.P$2
BUS+_OUT: POWER.3, X5.1
BUZZER: 74HC595.1, R12.1
C1: AD1.P2, C26.-, ME2-O2_OXYGEN_SENSOR1.C, R3.1, R4.2
CK_SD: MICRO_SD.CLK, STM32F411.24
CMD_SD: MICRO_SD.CMD, R17.2, STM32F411.12
CS_LIS: JP3.9, STM32F411.27
CS_LIS1: JP1.9, U$10.CS
CS_LSM: JP3.10, STM32F411.26
CS_LSM1: JP1.10, LSM6DS3.P$6
D0_SD: MICRO_SD.DAT0, R16.2, STM32F411.35
D1: JP9.2, SI2300A.3
D2: ME2-O2_OXYGEN_SENSOR1.D, R6.2
FOTO0: FOTO0.2, JP3.14, R18.2
FOTO1: JP3.13, R0.2, U$0.P$1
FOTO2: JP1.13, JP2.1
FOTO3: JP1.14, JP2.2
G: JP9.1, R57.2, R58.1, R58.2, SI2300A.1
GERMO: 74HC595.15, JP4.6
GERMO1: JP5.6, R49.1
GND: AD1.P3, C1.2, C27.+, C29.2, C30.-, C31.-, JP10.2, MAX1.P3, MCP1.P1, R4.1, R6.1
GND1: 74HC595.8, BME280.P$3, C2.1, FOTO0.1, INA.3, INA.7, INA.8, IRF7905.1, IRF7905.3, JP4.2, MICRO_SD.VSS, NDC7002.2, NDC7002.5, NDC7002_.2, NDC7002_.5, R11.2, R22.2, R24.2, R28.1, R29.1, R34.1, R35.1, R38.1, SI2302.2, STATE.C, STM32F411.19, STM32F411.39, U$0.P$2, U$1.3, U$19.P$5, U$20.P$5, U$21.P$5, U$22.P$5
GND2: 3V3.C, 5V.C, C3.1, C4.1, C6.1, C9.1, C10.1, C11.1, C12.1, C13.1, C16.1, C17.1, GPS-NEO7M.P$4, JP5.2, JP6.1, LIDAR.4, LSM6DS3.P$3, MP1584-3V3.P$3, MP1584-3V3.P$4, MP1584-3V3.P$5, MP1584-3V3.P$6, MP1584-5V.P$3, MP1584-5V.P$4, MP1584-5V.P$5, MP1584-5V.P$6, R41.2, R44.2, R48.2, RADIO.P$2, RADIO.P$8, RADIO.P$11, RADIO.P$13, RADIO.P$14, RADIO.P$15, RADIO.P$16, RADIO.P$19, RADIO.P$26, SI1.2, U$6.P$1, U$6.P$4, U$7.P$1, U$7.P$4, U$10.GND, X5.2
GND4: JP8.3, R56.2, R57.1, SI2300A.2
GND5: ADS1.3, C25.1, R66.1, R68.1, U$9.P$2, U$11.P$2, U$11.P$5, U$12.P$5, U$13.P$5, X7.P$2, X8.2
IN: JP8.2, R55.1
INA_SP+: R20.1, R21.1, R39.1
LATCH_SR: 74HC595.12, JP3.12, STM32F411.23
LATCH_SR1: JP1.12, MOTOR_BOARD.3
M0_RADIO: JP4.9, STM32F411.4
M0_RADIO1: JP5.9, RADIO.P$20
M1_RADIO: JP4.8, STM32F411.3
M1_RADIO1: JP5.8, RADIO.P$21
M3: U$12.P$4, U$12.P$6, X9.2
M4: U$13.P$4, U$13.P$6, X9.1
MISO_SENS: JP3.4, STM32F411.32
MISO_SENS1: JP1.4, LSM6DS3.P$7, U$10.SDO
MK_MOTOR1+: 74HC595.4, R37.1
MK_MOTOR1-: 74HC595.5, R36.1
MK_MOTOR2+: 74HC595.6, R31.1
MK_MOTOR2-: 74HC595.7, R30.1
MOSI_SENS: 74HC595.14, JP3.3, STM32F411.33
MOSI_SENS1: JP1.3, LSM6DS3.P$5, U$10.SDA
MOTOR1+: MOTOR_SP_V.1, U$22.P$4, U$22.P$6
MOTOR1-: MOTOR_SP_V.2, U$21.P$4, U$21.P$6
MOTOR2+: MOTOR_SP_G.1, U$20.P$4, U$20.P$6
MOTOR2-: MOTOR_SP_G.2, U$19.P$4, U$19.P$6
unnamed: AD1.P1, C26.+, R1.1, R5.2, RT2.1
unnamed: R13.1, U$1.1
unnamed: C8.2, R41.1, R42.1, U$6.P$8
unnamed: R1.2, R3.2, RT2.2
unnamed: C28.+, MAX1.P2
unnamed: C11.2, U$7.P$7
unnamed: R43.2, U$7.P$6
unnamed: C15.2, R44.1, R45.1, U$7.P$8
unnamed: C3.2, U$6.P$7
unnamed: R40.2, U$6.P$6
unnamed: C7.2, U$6.P$5
unnamed: C7.1, L_3.3.P$2, U$6.P$3
unnamed: BUZZER.P$1, SI2302.3
unnamed: R11.1, R12.2, SI2302.1
unnamed: C5.2, INA.2, R20.2
unnamed: C14.2, U$7.P$5
unnamed: C14.1, U$7.P$3, U$8.P$2
unnamed: C5.1, INA.1, R19.2
unnamed: 5V.A, R46.1
unnamed: IRF7905.7, IRF7905.8, PERE_L.2
unnamed: IRF7905.5, IRF7905.6, PERE_SP.2
unnamed: IRF7905.2, R22.1, R23.2
unnamed: IRF7905.4, R24.1, R25.2
unnamed: NDC7002.6, R32.2, U$21.P$1, U$21.P$3
unnamed: NDC7002_.6, R26.2, U$19.P$1, U$19.P$3
unnamed: NDC7002_.4, R27.2, U$20.P$1, U$20.P$3
unnamed: NDC7002.4, R33.2, U$22.P$1, U$22.P$3
unnamed: NDC7002.1, R34.2, R36.2
unnamed: NDC7002.3, R35.2, R37.2
unnamed: 3V3.A, R47.1
unnamed: R48.1, R49.2, SI1.1
unnamed: NDC7002_.1, R28.2, R30.2
unnamed: COMPRESS.1, SI1.3, VALVE1.1, VALVE2.1
unnamed: NDC7002_.3, R29.2, R31.2
unnamed: ADS1.4, R61.2, U$9.P$1
unnamed: R65.1, R66.2, U$11.P$1
unnamed: R67.2, R68.2, U$11.P$3
unnamed: C28.-, MAX1.P4
OE_SR: 74HC595.13, JP3.11, R38.2, STM32F411.25
OE_SR1: JP1.11, MOTOR_BOARD.2
OUT: JP8.1, R55.2, R56.1
PERE1: 74HC595.3, R23.1
PERE2: 74HC595.2, R25.1
PHOTO1: ADS1.5, R62.2, X7.P$1
RX_GPS: JP4.11, STM32F411.9
RX_GPS1: GPS-NEO7M.P$3, JP5.10
RX_LIDAR: JP3.7, STM32F411.29
RX_LIDAR1: JP1.8, LIDAR.2
RX_RADIO: JP3.5, STM32F411.31
RX_RADIO1: JP1.6, RADIO.P$23
SCK_SENS: 74HC595.11, JP4.12, STM32F411.11
SCK_SENS1: JP5.12, LSM6DS3.P$4, MOTOR_BOARD.4, U$10.SCL
SCL1: BME280.P$2, INA.5, JP3.2, R15.1, STM32F411.36
SCL2: JP1.2, JP6.4
SCL3: ADS1.9, R63.1, X6.P$3
SDA1: BME280.P$1, INA.6, JP3.1, R14.1, STM32F411.37
SDA2: JP1.1, JP6.3
SDA3: ADS1.10, R64.1, X6.P$2
SHIFT: 74HC595.9, JP4.5
SHIFT1: JP5.5, MOTOR_BOARD.1
SOUT1: C1.1, JP10.1, R5.1
SP+: R19.1, R21.2, SP.1
SP-: R39.2, SP.2
SWITCH: STATE.A, STM32F411.21, U$1.2
TX_GPS: JP4.10, STM32F411.8
TX_GPS1: GPS-NEO7M.P$2, JP5.11
TX_LIDAR: JP3.8, STM32F411.28
TX_LIDAR1: JP1.7, LIDAR.1
TX_RADIO: JP3.6, STM32F411.30
TX_RADIO1: JP1.5, RADIO.P$22
UM1_MOSFET1: R59.1, U$11.P$6, U$13.P$1, U$13.P$3
UM2_MOSFET1: R60.2, U$11.P$4, U$12.P$1, U$12.P$3
UM3: R67.1, X6.P$4
UM4: R65.2, X6.P$5
