cansat-tsniimash/KNPN-2025/schematics/Cansat-2025-2.brd

## EAGLE design schematics/Cansat-2025-2.brd (2025-03-11)

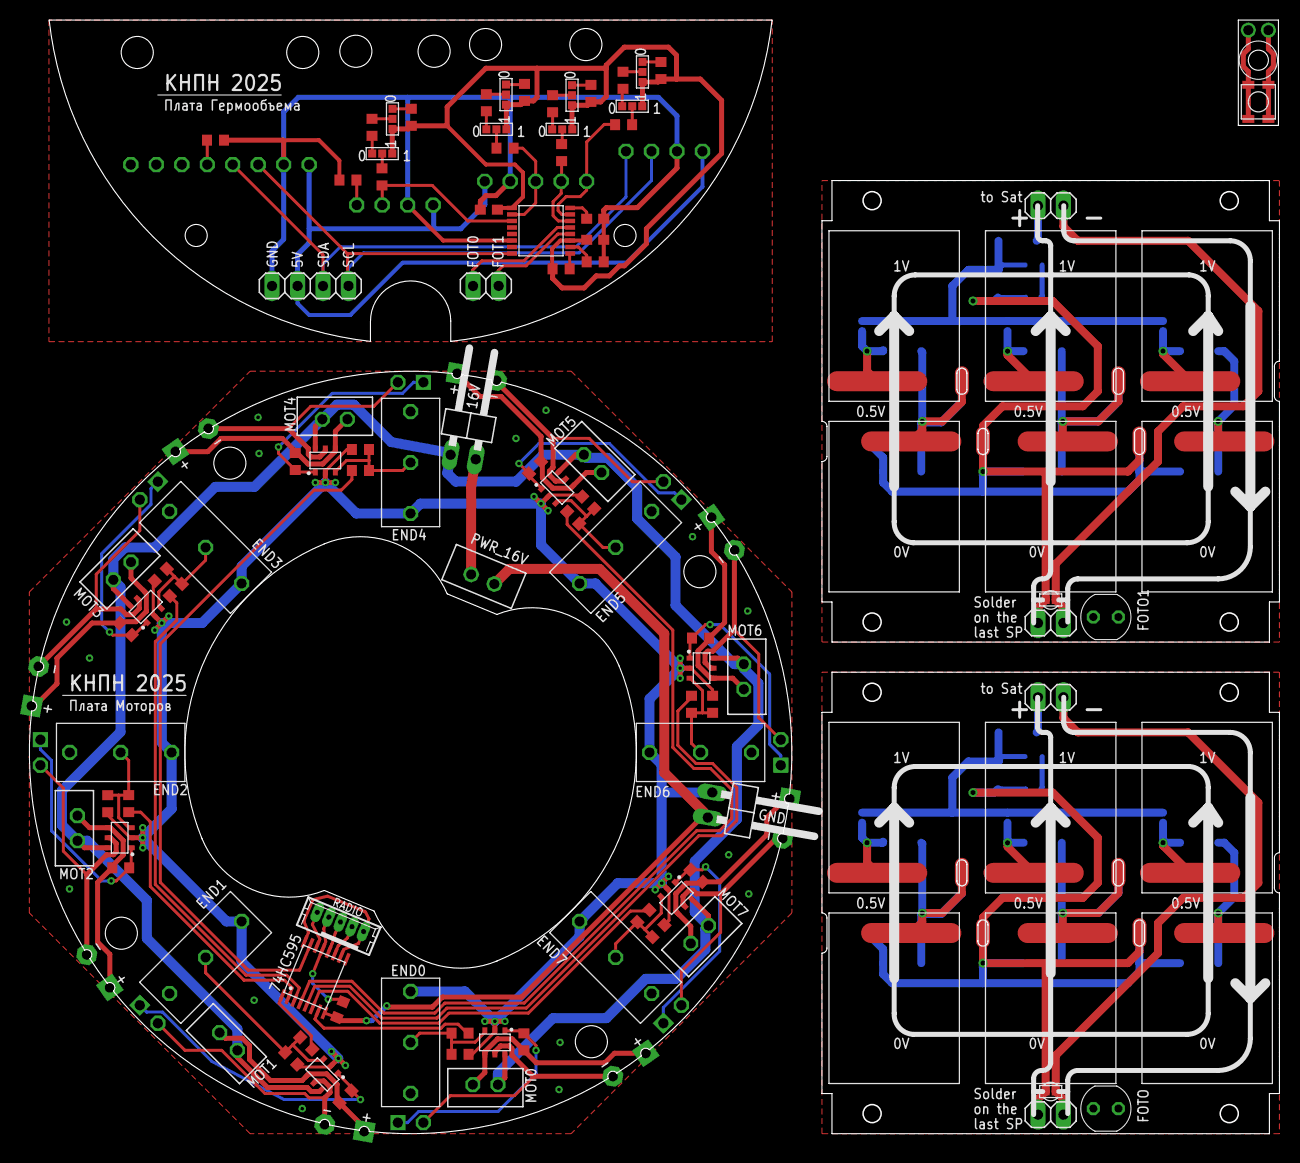
[picture p98: board Cansat-2025-2.brd from above]

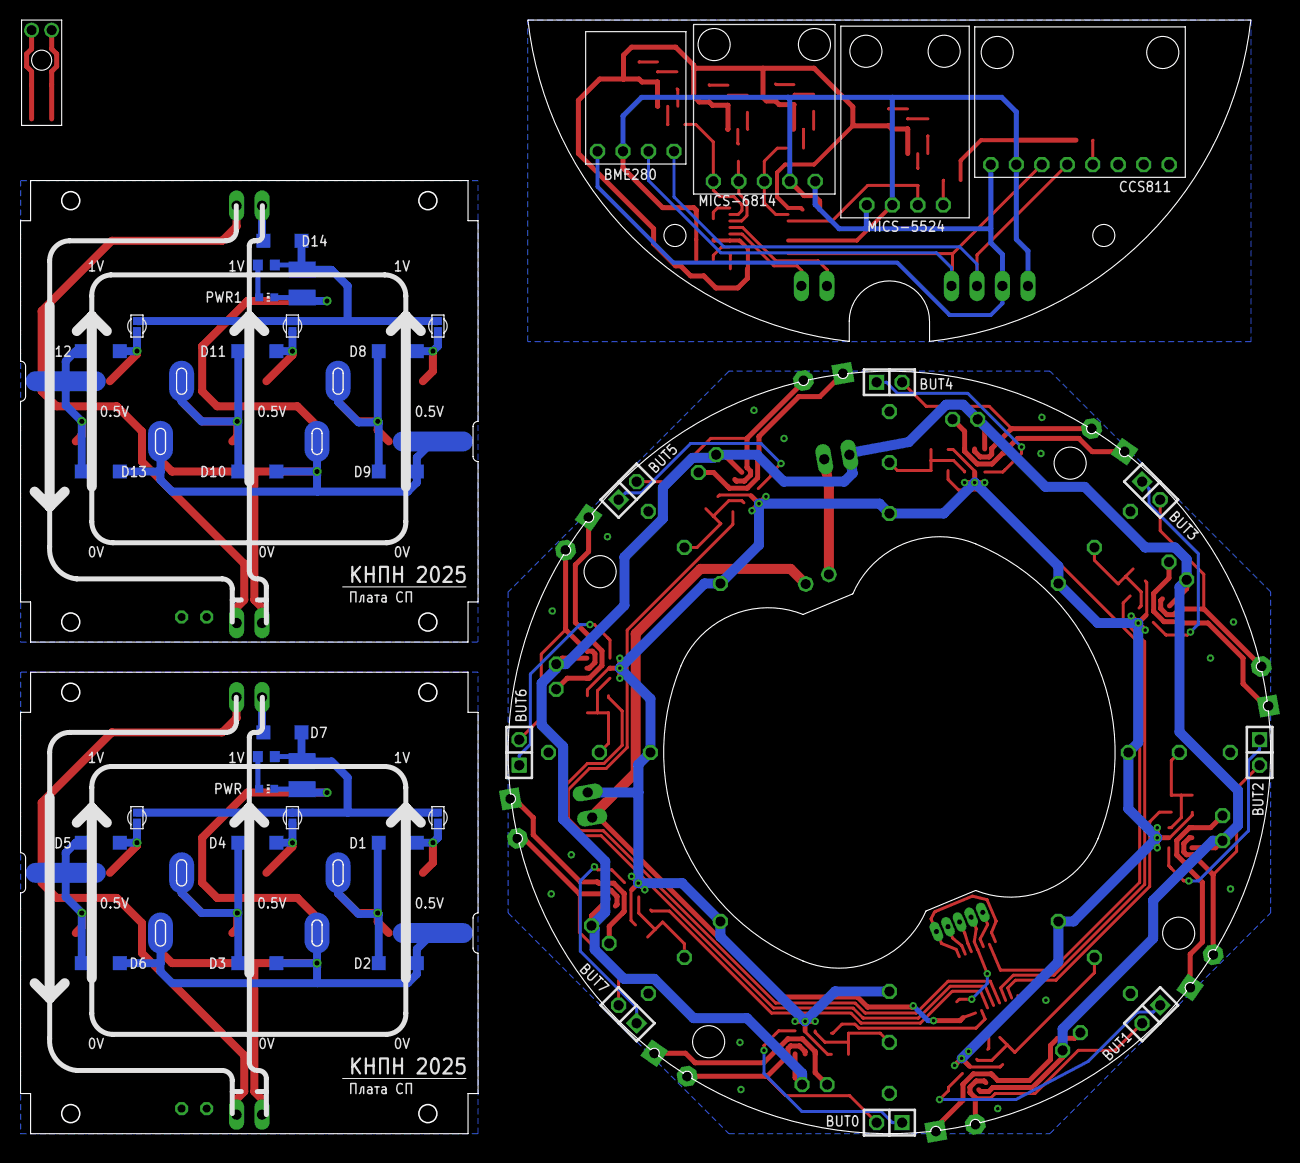
[picture p99: board Cansat-2025-2.brd from below]

Board: 2 copper layers, 124.6 x 111.0 mm, 155 parts (40 on the bottom side), 105 nets.

Parts:
16V: 1X02/90
74HC595: 74HC595; TSSOP16
BME280: BME280BME280-PINS-ONLY; BME280-PINS-ONLY
BUT0, BUT1, BUT2, BUT3, BUT4, BUT5, BUT6, BUT7: 1X02
C1, C2: 47u; C1210
C3, C4, C5: 100nF; C0603
CCS811: CCS811; CSS811
D1, D2, D3, D4, D5, D6, D7, D8, D9, D10, D11, D12, D13, D14: MBR0520LT; SOD123
END0, END1, END2, END3, END4, END5, END6, END7: CONCEVIC
FOTO, FOTO1: VT93N1VERT; VT93N1-VERT
GND: 1X02/90
JP1, JP2, JP4: 1X02
JP3: 1X04
MICS-5524: MICS_5524; MICS-5524
MICS-6814: MICS-6814
MOT0, MOT1, MOT2, MOT3, MOT4, MOT5, MOT6, MOT7: JST-2-2.5
PWR, PWR1: CHIP-LED0603
PWR_16V: JST-2-2.5
R1, R2: 2k7; R0603
R3, R6, R9, R12, R16, R19, R22, R25: 100R; R0603
R4, R5, R7, R8, R10, R11, R13, R15, R17, R18, R20, R21, R23, R24, R26, R27, R29, R30, R31, R33: 10k; R0603
R14, R28, R32, R34, R35: 5k1; R0603
R39, R41, R43, R45: 100k; R0603
R40, R42, R44, R46: 1M; R0603
RADIO: MOLEX-5-1.25; 53047-05
SP-OUT, SP-OUT1: 1X02
U$1, U$3, U$4, U$8, U$12, U$14, U$15, U$19: SOLAR-2_INVERT0-2; SOLAR_0-2_INVERT
U$2, U$6, U$13, U$18: SOLAR-2_INVERT1-2; SOLAR_1-2_INVERT
U$5, U$17: Плата СП; LOGO
U$7, U$9, U$10, U$11, U$16, U$20, U$21, U$22: VIAS-CONNECT
U$23: Плата Моторов; LOGO
U$24, U$25, U$26, U$27, U$28, U$29, U$30, U$32: IRF5852; TSOP-6
U$31, U$33, U$34, U$44, U$45, U$46, U$47, U$48: CONNECT_3
U$35, U$36, U$37, U$38, U$39, U$40, U$41, U$42: CONTACT_SIDE_4MM_2PIN
U$43: Плата Гермообъема; LOGO
U$49: AD5593
U$50: BTN_VERY_SMALLCUT; BTN-VS-CUT

Connections:
3V1: C4.1, C5.1, R35.2, R40.1, R42.1, R44.1, R46.1, U$31.1, U$33.1, U$34.1, U$44.1, U$45.1, U$46.1, U$47.1, U$48.1, U$49.P$3, U$49.P$9
3V3: 74HC595.10, 74HC595.16, RADIO.1
5V: BME280.P$4, CCS811.P$1, JP3.2, MICS-5524.P$4, MICS-6814.P$1
16V_IN: 16V.1, MOT0.1, MOT1.1, MOT2.1, MOT3.1, MOT4.1, MOT5.1, MOT6.1, MOT7.1, U$24.P$6, U$25.P$6, U$26.P$6, U$27.P$6, U$28.P$6, U$29.P$6, U$30.P$6, U$32.P$6
16V_OUT: 16V.2, PWR_16V.1
CO: MICS-6814.P$5, R33.2, U$49.P$7
EN: MICS-5524.P$1, R32.1
FOTO0: JP4.2, U$49.P$5
FOTO1: JP4.1, U$49.P$4
GND: BME280.P$3, C3.2, C4.2, C5.2, CCS811.P$2, JP3.1, MICS-5524.P$3, MICS-6814.P$2, R28.2, R32.2, R34.2, U$49.P$14
GND_IN: END0.P$1, END1.P$1, END2.P$1, END3.P$1, END4.P$1, END5.P$1, END6.P$1, END7.P$1, GND.1, R4.2, R7.2, R10.2, R13.2, R17.2, R20.2, R23.2, R26.2, U$24.P$2, U$25.P$2, U$26.P$2, U$27.P$2, U$28.P$2, U$29.P$2, U$30.P$2, U$32.P$2
GND_OUT: 74HC595.8, GND.2, PWR_16V.2, R14.1
LATCH_SR: 74HC595.12, RADIO.3
MICS: MICS-5524.P$2, R31.2, U$49.P$11
MOTOR0: 74HC595.7, R3.1
MOTOR1: 74HC595.1, R6.1
MOTOR2: 74HC595.2, R9.1
MOTOR3: 74HC595.3, R12.1
MOTOR4: 74HC595.15, R16.1
MOTOR5: 74HC595.4, R19.1
MOTOR6: 74HC595.5, R22.1
MOTOR7: 74HC595.6, R25.1
unnamed: D7.A, JP1.2
unnamed: D5.A, U$6.IN-2, U$11.1
unnamed: D4.A, U$4.IN-2, U$10.1
unnamed: PWR.A, R1.2
unnamed: D1.C, D2.A, U$1.OUT-2, U$1.OUT-21, U$2.IN-2
unnamed: D3.A, D4.C, U$3.IN-2, U$4.OUT-2, U$4.OUT-21
unnamed: D1.A, U$1.IN-2, U$9.1
unnamed: D5.C, D6.A, U$6.OUT, U$8.IN-2
unnamed: PWR1.A, R2.2
unnamed: D12.C, D13.A, U$18.OUT, U$19.IN-2
unnamed: D14.A, JP2.2
unnamed: D8.C, D9.A, U$12.OUT-2, U$12.OUT-21, U$13.IN-2
unnamed: D11.A, U$15.IN-2, U$21.1
unnamed: D12.A, U$18.IN-2, U$22.1
unnamed: D8.A, U$12.IN-2, U$20.1
unnamed: D10.A, D11.C, U$14.IN-2, U$15.OUT-2, U$15.OUT-21
unnamed: MOT0.2, R5.1, U$24.P$4, U$38.P$1
unnamed: END0.P$2, R3.2, R4.1, U$24.P$3
unnamed: END1.P$2, R6.2, R7.1, U$25.P$3
unnamed: END2.P$2, R9.2, R10.1, U$26.P$3
unnamed: BUT0.2, U$24.P$5, U$38.P$2
unnamed: BUT0.1, R5.2, U$24.P$1
unnamed: BUT1.2, U$25.P$5, U$35.P$2
unnamed: BUT1.1, R8.1, U$25.P$1
unnamed: MOT1.2, R8.2, U$25.P$4, U$35.P$1
unnamed: MOT2.2, R11.2, U$26.P$4, U$36.P$1
unnamed: BUT2.2, U$26.P$5, U$36.P$2
unnamed: BUT2.1, R11.1, U$26.P$1
unnamed: END3.P$2, R12.2, R13.1, U$27.P$3
unnamed: MOT3.2, R15.2, U$27.P$4, U$37.P$1
unnamed: BUT3.2, U$27.P$5, U$37.P$2
unnamed: BUT3.1, R15.1, U$27.P$1
unnamed: END4.P$2, R16.2, R17.1, U$28.P$3
unnamed: MOT4.2, R18.2, U$28.P$4, U$39.P$1
unnamed: BUT4.2, U$28.P$5, U$39.P$2
unnamed: BUT4.1, R18.1, U$28.P$1
unnamed: END5.P$2, R19.2, R20.1, U$29.P$3
unnamed: MOT5.2, R21.2, U$29.P$4, U$40.P$1
unnamed: BUT5.2, U$29.P$5, U$40.P$2
unnamed: BUT5.1, R21.1, U$29.P$1
unnamed: END6.P$2, R22.2, R23.1, U$30.P$3
unnamed: MOT6.2, R24.2, U$30.P$4, U$41.P$1
unnamed: BUT6.2, U$30.P$5, U$41.P$2
unnamed: BUT6.1, R24.1, U$30.P$1
unnamed: END7.P$2, R25.2, R26.1, U$32.P$3
unnamed: MOT7.2, R27.2, U$32.P$4, U$42.P$1
unnamed: BUT7.2, U$32.P$5, U$42.P$2
unnamed: BUT7.1, R27.1, U$32.P$1
unnamed: R39.2, U$44.3
unnamed: R33.1, U$44.2
unnamed: R40.2, U$45.3
unnamed: R39.1, U$45.2
unnamed: R41.2, U$46.3
unnamed: R29.1, U$46.2
unnamed: R42.2, U$47.3
unnamed: R41.1, U$47.2
unnamed: R43.2, U$48.3
unnamed: R30.1, U$48.2
unnamed: R44.2, U$31.3
unnamed: R43.1, U$31.2
unnamed: R45.2, U$33.3
unnamed: R31.1, U$33.2
unnamed: R46.2, U$34.3
unnamed: R45.1, U$34.2
unnamed: C3.1, U$49.P$8
unnamed: R34.1, U$49.P$2
unnamed: R35.1, U$49.P$1
NH3: MICS-6814.P$4, R30.2, U$49.P$6
NO2: MICS-6814.P$3, R29.2, U$49.P$10
OE_SR: 74HC595.13, R14.2, RADIO.4
P1: U$50.P$1, U$50.P$2
P2: U$50.P$3, U$50.P$4
SCK_SENS: 74HC595.11, RADIO.2
SCL: BME280.P$2, CCS811.P$3, JP3.4, U$49.P$16
SDA: BME280.P$1, CCS811.P$4, JP3.3, U$49.P$15
SHIFT: 74HC595.14, RADIO.5
SP+: C1.1, D7.C, R1.1, U$9.2, U$10.2, U$11.2
SP+1: C2.1, D14.C, R2.1, U$20.2, U$21.2, U$22.2
SP+-: C1.2, D2.C, D3.C, D6.C, PWR.C, SP-OUT.1, U$2.OUT, U$3.OUT-2, U$3.OUT-21, U$7.1, U$8.OUT-2, U$8.OUT-21
SP+-1: C2.2, D9.C, D10.C, D13.C, PWR1.C, SP-OUT1.1, U$13.OUT, U$14.OUT-2, U$14.OUT-21, U$16.1, U$19.OUT-2, U$19.OUT-21
SP-: JP1.1, SP-OUT.2, U$7.2
SP-1: JP2.1, SP-OUT1.2, U$16.2
WAC: CCS811.P$5, R28.1
