cansat-tsniimash/KNPN-2025/src/KNPN/KNPN.ioc

Mcu.UserName=STM32F411CEUx
PA10.Signal=GPIO_Output
PA11.Signal=USART6_TX
PA12.Signal=USART6_RX
PA15.Signal=USART1_TX
PA2.Signal=USART2_TX
PA3.Signal=USART2_RX
PA5.Signal=SPI1_SCK
PA6.Signal=SDIO_CMD
PA8.GPIO_Label=OE_SR
PA8.Signal=GPIO_Output
PA9.Signal=GPIO_Output
PB0.Signal=GPIO_Output
PB1.Signal=GPIO_Output
PB14.GPIO_Label=LATCH_SR
PB14.Signal=GPIO_Output
PB15.Signal=SDIO_CK
PB3.Signal=USART1_RX
PB4.Signal=SPI1_MISO
PB5.Signal=SPI1_MOSI
PB7.Signal=SDIO_D0
PB8.Signal=I2C1_SCL
PB9.Signal=I2C1_SDA
PC14-OSC32_IN.Signal=GPIO_Output
PC15-OSC32_OUT.Signal=GPIO_Output
