cansat-tsniimash/KNPN-2025/src/KNPN/Core/Inc/main.h

#define LATCH_SR_Pin GPIO_PIN_14
#define LATCH_SR_GPIO_Port GPIOB
#define OE_SR_Pin GPIO_PIN_8
#define OE_SR_GPIO_Port GPIOA
