cansat-tsniimash/KNPN-2025/(commit log)

2024-10-09 буэээ
2024-10-10 Компрессор добавлен
2024-10-10 добавил мотор большой угловой
    [motor.prt]
2024-10-10 старые модельки
    [air-valve.prt, akkum_18350.prt, blinchik-down_1.prt, blinchik-down_2.prt, blinchik_kernel_up.prt, bme280_module.prt, button.prt, capitan_compress.prt]
2024-10-16 вариант с красивым механизмом
    [abstractnaa_os.prt, bottom_disk_corpus.prt, gayla_by_andrey.prt, krivoship.prt, lepestok.prt, motor-reductor-m4.prt, shatun.prt]
2024-10-17 катуфку сделяль
2024-10-19 Много всякого по моторам
2024-10-19 Моторный рай блин
2024-10-23 Я не могу, это писос, моторы - головняк
2024-10-23 ЗАТЯШКА ПАЧТИ
    [motor.prt]
2024-10-23 возвращение модели катушки
    [3mm_shesternya.prt, akk_cyl_aaaaaaaa.prt, andrey_pomni_tut_fignia2.prt, andrey_pomni_tut_fignya.prt, corpus_motor.prt, derjalka_motora.prt, down_corpus.prt, katushka.prt]
2024-10-26 МегаСвастон, моторный рай растет)
2024-10-27 делаем верх
    [katushka.prt, lepestok_1.prt, natyajitel.prt]
2024-10-27 исправлены привязки к другим деталям сборки, ВЛАД!!!
    [akk_cyl_aaaaaaaa.prt, akkum_18350.prt, base.prt, derjalka_motora.prt, lepestok_1.prt, motor-1axis.prt, shahshahs.prt]
2024-10-30 добавлена сборка старой верхней части и плат ВЛ
    [74hc595t16.prt, amplifier_xq-02a.prt, blinchik_for_kreplenie.prt, bme280_board.prt, board.prt, buzzer.prt, connector-pls-20.prt, connector-pls-4.prt]
2024-10-30 мать моя женщина...
2024-10-30 сделаль крепление пережигателя
    [katushka.prt, lepestok_1.prt, lepestok_2.prt]
2024-10-30 гермообъем
    [detal_germoobema.prt, prt0003.prt]
2024-11-04 STL для макета
    [base.prt, base.stl, lepestok_1_test.prt, lepestok_1_test.stl, lepestok_2_test.prt, lepestok_2_test.stl, motor-2axis.prt, solariy_aaaaaaaa.prt]
2024-11-05 prt 1 и 2 - держалка для грузиков
2024-11-06 Держалка... для грузиков
2024-11-08 Лепестки на печать
    [lepestok_cyl_test.stl]
2024-11-20 Дальномеры 2 штука
2024-11-20 чототам
    [boarder.prt, dalnomer.prt, dalnomer2.prt, derjalka_motora.prt, derjalka_motora_m2.prt, katushka.prt, prt0001.prt, prt0002.prt]
2024-11-22 Вау скок всего
    [lepestok_1_test3.stl]
2024-11-23 Старые платки
    [board.prt, gear_motor_2axis.prt]
2024-11-23 абудаб
    [air-valve.prt, bme280_module.prt, mics-6814.prt]
2024-11-23 добавили все в проект куба
2024-11-28 порядок
    [ad5593.prt, boarder.prt, buzzer.prt, connector_b2b-eh-a.prt, gear_motor_2axis.prt, ina219_korpus.prt, irf7905.prt, katushka.prt]
2024-11-30 радио работает
2024-12-04 мсчьб
    [base.prt]
2024-12-04 Больше никогда влад!!!!! я в тг написал
    [bme280_board.prt, boarder.prt, buzzer.prt, connector-pls-20.prt, connector-pls-4.prt, connector_b2b-eh-a.prt, connector_pbs-smd.prt, connector_pls-smd.prt]
2024-12-06 ПЕРЕИМЕНОВАЛ
    [3mm_gear.prt, air_valve.prt, compressor.prt, ffc_pinhead_dip.prt, fitting.prt, hermetic_board.prt, hermetic_case.prt, kernel_3mm.prt]
2024-12-06 кнопка для моторов
    [button.prt, es_board.prt]
2024-12-06 эщкереееее
    [base.prt]
2024-12-06 добавл дырдочки
    [gear_motor_2axis.prt, motor_angular.prt, plate_sp.prt, sp_shaft_fastener.prt]
2024-12-07 пам пам тидам
    [MK.brd, MK.sch]
2024-12-07 программа полета
2024-12-07 покрашены детали
    [3mm_gear.prt, base.prt, boarder.prt, es_board.prt, gear_motor_2axis.prt, gps_antenna25x25.prt, hermetic_board.prt, hermetic_case.prt]
2024-12-07 примерили антенну гпс
    [base.prt, hermetic_case.prt, kernel_3mm.prt, plate_sp.prt, sp_shaft_fastener.prt]
2024-12-11 Добавил гпс
    [gps_antenna25x25.prt, plate_sp.prt, sp_shaft_fastener.prt]
2024-12-13 mvcmvn fvghjk
    [connector_pbs_5mm-smd.prt, connector_pls_5mm-smd.prt, hermetic_case.prt]
2024-12-14 боба
    [3mm_gear.prt, base.prt, bme280_module.prt, boarder.prt, boarder_mk.prt, ccs811.prt, compressor.prt, connector_pbs_5mm-smd.prt]
2024-12-14 анимация
2024-12-14 сделал видева
2024-12-18 дс дс
    [RADIO.brd]
2024-12-18 радиомодуль
    [wireless_module_e22-400t30s.prt]
2024-12-18 в процессе видева
2024-12-20 доделал видево
2024-12-20 Платы, скоро будут вырезы
    [switch_ss-12d11.prt]
2024-12-20 добавлены гпс и дсдс в нашу папку, ВЛАД!!!
    [base.prt, boarder.prt, boarder_mk.prt, dc-dc_1584.prt, gps_ublox_neo-7m.prt]
2024-12-21 Вырез фоторезистора
2024-12-21 Вырезал почки
    [lepestok_vz1.prt, lepestok_vz2.prt, lepestok_vz3.prt, lepestok_vz4.prt]
2024-12-21 Андрбша, я тебе покушать принес
    [boarder.prt, boarder_mk.prt, connector_pbs-smd.prt, connector_pbs_5mm-smd.prt, lepestok_1.prt, lepestok_vz1.prt, lepestok_vz2.prt, lepestok_vz3.prt]
2024-12-21 цуар
    [connector_pls-smd.prt, sp_shaft_fastener.prt]
2024-12-21 масса не тонна, но многовато
    [connector_pls_5mm-smd.prt, es_board.prt, gps_antenna25x25.prt, hermetic_case.prt]
2024-12-21 Черттрёё1ёэодцлэощлцв
2024-12-25 ьлтимсчав
    [bme280_module.prt, ccs811.prt, mics-5524.prt, mics-6814.prt]
2024-12-27 ЧЕРТЁЁЁЁЁЁЁЖОЖУШЧВОУАТ ЦУЩкз
    [lepestok_2.prt, lepestok_vz2.prt, parachute_compartment.prt]
2024-12-27 исправлены ошибки в углах при проектировании конструкции
    [base.prt, boarder_mk.prt, connector_pbs-10_5mm_smd.prt, connector_pbs-15_smd.prt, connector_pbs-4_5mm_smd.prt, connector_pbs-smd.prt, connector_pbs_5mm-smd.prt, connector_pls-10_smd.prt]
2025-01-05 для видео
    [gps_antenna.prt]
2025-01-05 видео
2025-01-09 обновлены видео, добавлена анимация подъема
    [base.prt]
2025-01-10 Гифки
2025-01-11 добавлены анимации без кромки
2025-01-17 расчет скорости спуска под 7 м/с
    [parapat_RUS.xls, График падения без парашюта (2).xlsx, План-график.xlsx]
2025-01-31 Платки там
    [MK.brd, MK.sch, RADIO.brd, RADIO.sch]
2025-01-31 модели маяка и его аккума
    [akb_tbeacon.prt, tbeacon_onyx.prt]
2025-01-31 новый гч
2025-02-01 Платы СП 2023
    [SP1.brd, SP1.sch, SP2.brd, SP2.sch]
2025-02-01 ПЛАТЫ, АААААААААААААААААААААААААААА
    [MK.brd, MK.sch, RADIO.brd, RADIO.sch, SP1.brd, SP1.sch, SP2.brd, SP2.sch]
2025-02-01 план-график
    [План-график.xlsx]
2025-02-01 авиполджэъ/ ХПАРОэхжзвапрэ ЖДЛотрипмтсарлншжщлдбьюж
    [GERMO.brd, GERMO.sch, MOTOR.sch]
2025-02-05 Затягиватель
    [tensioner.prt]
2025-02-07 схемы плат
    [GERMO.brd, GERMO.sch, MK.brd, MK.sch, MOTOR.sch, RADIO.brd, RADIO.sch, SP1.sch]
2025-02-07 подготовлены файлы для зимней сессии
    [GERMO.brd, GERMO.sch, MK.brd, MK.sch, MOTOR.sch, RADIO.brd, RADIO.sch, SP.brd]
2025-02-07 распиновка разъемов плат
    [MK.brd, MK.sch, RADIO.brd, RADIO.sch]
2025-02-07 платочки
    [GERMO.brd, MOTOR.brd, drw0001.dxf, hermetic_board.dxf, lepestok_vz1.stl, lepestok_vz2.stl, lepestok_vz3.stl, lepestok_vz4.stl]
2025-02-07 длорпамсвч
    [GERMO.brd, RADIO.brd]
2025-02-07 разъем в гермообъеме на 8 пинов
    [RADIO.brd, RADIO.sch, connector_pbs-15_smd.prt]
2025-02-07 дсдс
    [base.prt, dc-dc_12v.prt]
2025-02-08 обновлено расположение компонентов на платах
    [connector_pbs-12_5mm_smd.prt, connector_pbs-16_5mm_smd.prt, connector_pls-12_smd.prt, connector_pls-16_smd.prt]
2025-02-12 Расставлены разъемы на плате Радио
    [connector_b2b-eh-a.prt, pinhead_jst_4pin.prt, pinhead_jst_5pin.prt]
2025-02-14 Плата Радио
    [MK.brd, RADIO.brd, RADIO.sch]
2025-02-15 цывуа4кеп5рн6го7л8шщ9
    [MK.brd, RADIO.brd]
2025-02-15 сч мипэхъ\
    [GERMO.brd, GERMO.sch, MOTOR.brd, MOTOR.sch]
2025-02-21 Моторчики
    [MOTOR.brd, MOTOR.sch]
2025-02-22 Поправлены платы МК, Радио, Гермо
    [GERMO.brd, GERMO.sch, MK.brd, MK.sch, RADIO.brd, RADIO.sch, SP.brd, SP.sch]
2025-03-01 лплоав
2025-03-01 схема платы моторов исправлена
    [MOTOR.brd, MOTOR.sch, SP.brd, SP.sch]
2025-03-01 фцыувкаепнргошщз
    [GERMO.brd, GERMO.sch, MK.brd, MK.sch, MOTOR.brd, MOTOR.sch, RADIO.brd, RADIO.sch]
2025-03-01 компоненты внутри рабочей области
    [MOTOR.brd]
2025-03-02 чёта
2025-03-07 Вроде платы
2025-03-07 Плата MOTOR разведена, но не сделана шелкография
    [MOTOR.brd, MOTOR.sch]
2025-03-07 Покрутили модель, подвигали DC-DC и платы
    [base.prt, connector-pls-2.prt, motor_board.prt, motor_gxf.dxf]
2025-03-07 проверка плат
    [GERMO.brd, MK.brd, MK.sch, RADIO.brd, RADIO.sch, SP.brd]
2025-03-08 кутиииии
2025-03-08 исправлена отправка пакетов
2025-03-10 Платы готовы
    [GERMO.brd, GERMO.sch, MK.brd, MK.sch, MOTOR.brd, MOTOR.sch, RADIO.brd, RADIO.sch]
2025-03-10 Че-то с наземкой
2025-03-10 Гыы, мы делаем солнечные панели второй год, гыы...
    [Cansat-2025-1.brd]
2025-03-11 Не обижайтесь
    [shema.brd, shema.sch]
2025-03-11 Пу-пу-руу
    [resisdelit.brd, resisdelit.sch]
2025-03-11 заказ плат
    [Cansat-2025-1.brd, Cansat-2025-2.brd, MOTOR.brd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]
2025-03-19 кууутиии продолжение
2025-03-22 ну чёта я сделал и наверное оно работает, но я не уверен
2025-03-26 СД в центре лепестка. Платы версия 2
    [Cansat-2025-1.brd, MK.brd, MK.sch, RADIO.brd, boarder_mk.prt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]
2025-04-06 написал ccs811
2025-04-11 База и цилиндры для сбросов
    [6.stl, base_for_test.prt, cylin_test05.stl, cylin_test1.stl, cylin_test2.stl, cylin_test3.stl, cylin_test4.stl, prt0001.prt]
2025-04-11 ЛЕПЕСТКИ ВЛАААААД
    [base.prt, lepestok_1.prt, lepestok_1.stl, lepestok_vmot.prt, lepestok_vz2.prt, parachute.prt, parachute_compartment.prt]
2025-04-11 Лепестки, основание и крышка подготовлены к печати
    [base.prt, base.stl, connector-h5-pbs-12.prt, connector-h5-pbs-16.prt, connector-pbs-12.prt, connector-pbs-16.prt, connector-pbs-4.prt, connector-pls-12.prt]
2025-04-25 на плате работают бме лис и сд больше там ничего не работает кек
2025-04-25 отверстия в лепестках выше - под высокие межплатные разъемы
    [lepestok-aboba.prt, lepestok-aboba.stl, lepestok_990.prt, lepestok_990.stl, lepestok_vz1.prt, lepestok_vz1.stl, lepestok_vz2.prt, lepestok_vz2.stl]
2025-04-26 радио
2025-04-26 лсм не работает кек
2025-05-03 наземка + отображалка
2025-05-03 Андрей, после коммита надо пушить!!!!
2025-05-03 Я всё осознал) ещё чуть-чуть отображалки
2025-05-04 Лсм и ацп работают. Хотя в коде ничего и не менялось кек
2025-05-13 авволвадол
2025-05-17 lis и lsm снова работают
2025-05-17 фваывп
2025-05-18 Сборочный чертеж обновлен
2025-05-21 наземка с увеличенным шрифтом
2025-05-21 Работает старое наведение по одной оси. По второй не работает и раскрытие не работает.
2025-05-22 Исравлены отверстия под СБ
    [sp_board.prt, sp_board_fastener1.prt, sp_board_fastener2.prt, sp_board_motor_fastener.prt, sp_cap.prt]
2025-05-23 исправил гнпс
    [gps_antenna.prt, plate_sp.prt, sp_shaft_fastener.prt]
2025-05-23 Модель dcdc на 16 В
    [dc-dc_12v.prt]
2025-05-23 Андрей, комп надо выключать и все коммитить!!!!! Уменьшили отверстия в слониках
    [sp_base.prt]
2025-05-24 яхзчтототампоменял
    [plate_sp.prt]
2025-05-24 деталь для покрытия СП эпоксидкой
    [box_for_sp.prt]
2025-05-24 проршлый комит ток новая версия
    [box_for_sp.prt]
2025-05-24 правки в наземке
    [План-график.xlsx]
2025-05-28 разрезал базу сп
    [gps_base.stl]
2025-05-31 Епты гриша
2025-05-31 цварноглждеклуцорйвпАФВПРЛДБГЭЖОПВРАЫФЧЫЛРДПОЖРЭОРОПВЫАФЧЫПРЛОАДПЖНРШГЭ ЖЛДРНГПВАФЧспыЛДЖПНЭГДШНЛГОАПСФвчпырлДЖЭРДЛПОА
2025-06-01 исправлен фоторезистор и шрифты в наземке
2025-06-01 новые детали базы и гермообъема
    [base.prt, base.stl, gps_base.prt, hermetic_case.prt, hermetic_case.stl, tube_holder.prt, tube_holder.stl, План-график.xlsx]
2025-06-18 Увеличил отверстие под вал двигателя
    [gear_motor_2axis.prt]
2025-06-19 нужно делать как нужно, как не нужно делать не нужно
2025-06-24 пепе
2025-06-25 Наземка и лепестки стл
    [lepestok-aboba.stl, lepestok_1.stl, lepestok_990.stl, lepestok_vmot.stl, lepestok_vz1.stl, lepestok_vz2.stl, План-график.xlsx]
2025-07-04 крайняя версия наземки
    [packet1.csv, packet2.csv, План-график.xlsx]
2025-07-07 финал
